Tressilloide/Serra_smart/Kimi_Agent_Smart Greenhouse ESP32 LoRa/docs/Guida_Serra_Smart.md

# Serra Smart — Guida completa

Sistema di monitoraggio e irrigazione automatica basato su due ESP32 collegati
via LoRa e un server Linux con Home Assistant.

**Firmware 2.0** — comunicazione bidirezionale, sensori modulari, controllo
completo da Home Assistant.

---

## 1. Architettura

```
┌──────────────────────────┐      LoRa 433 MHz      ┌────────────────────────┐
│       NODO SERRA         │  ───── dati ────────►  │   PONTE IN CAMERA      │
│        (ESP32)           │                        │       (ESP32)          │
│                          │  ◄── ACK + comandi ──  │                        │
│  • BME280 (I2C)          │                        │  • LoRa Ra-01          │
│  • DS1307 RTC (I2C)      │                        │  • WiFi + MQTT         │
│  • Luce (GPIO 32)        │                        │  • Coda comandi        │
│  • Tensione (GPIO 33)    │                        │  • Ora NTP             │
│  • Terreno ×2 (34, 35)   │                        │  • Discovery HA        │
│  • Flussometro (15)      │                        │  • Sempre acceso       │
│  • microSD (backlog)     │                        │                        │
│  • Relay irrigazione     │                        └───────────┬────────────┘
│  • Deep sleep 15 min     │                                    │ WiFi / MQTT
└──────────────────────────┘                                    ▼
                                                    ┌────────────────────────┐
                                                    │   SERVER IN GARAGE     │
                                                    │     192.168.1.36       │
                                                    │  • Mosquitto           │
                                                    │  • Home Assistant      │
                                                    │  • Tailscale           │
                                                    └────────────────────────┘
```

### Come fluiscono i dati

1. Ogni 15 minuti il nodo si sveglia, legge i sensori e trasmette via LoRa.
2. Il ponte pubblica il pacchetto su MQTT e **solo dopo** risponde con un ACK.
3. Se l'ACK non arriva (ponte spento, WiFi giù, server in manutenzione), il
   nodo salva il pacchetto su microSD e lo ritrasmette al prossimo risveglio.
4. Home Assistant riceve i dati e crea le entità da solo via MQTT Discovery.

### Come fluiscono i comandi (novità della 2.0)

Il nodo dorme il 99% del tempo: non può restare in ascolto. L'unico momento in
cui la sua radio è accesa in ricezione è l'attesa dell'ACK dopo la
trasmissione. **È lì che viene infilato il comando.**

```
nodo  ── dati ─────────────────────────────►  ponte ──► MQTT ──► HA
nodo  ◄── ACK;s=42;now=…;c=7;o=IRR;a=120 ───  ponte
        [esegue]
nodo  ── dati;res=7;rc=0;det=ok ───────────►  ponte ──► serra/nodo/cmd/res
```

Costo aggiuntivo: **zero**. Nessuna finestra di ascolto in più, nessun consumo
extra, nessun pacchetto aggiuntivo nel caso normale.

Home Assistant pubblica i comandi con `retain: true`, quindi **è il broker MQTT
a fare da coda**: se premi un bottone mentre la serra dorme, il comando resta
lì e sopravvive anche a un riavvio del ponte.

**Latenza:** fino a un intervallo di deep sleep (15 minuti di default). La
dashboard mostra "comando in coda" finché non arriva l'esito, così l'attesa è
visibile e non sembra un malfunzionamento.

Poiché anche il pacchetto di esito riceve un ACK, e anche quell'ACK può portare
un comando, più comandi si svuotano a catena nello stesso risveglio.

---

## 2. File del progetto

| Percorso | Contenuto |
|---|---|
| `serra_nodo/serra_nodo.ino` | Orchestrazione del ciclo di vita del nodo |
| `serra_nodo/config.h` | **Tutti i parametri e il pinout** |
| `serra_nodo/protocollo.h` | Formato dei pacchetti (copia identica nel ponte) |
| `serra_nodo/sensori.{h,cpp}` | Registro sensori modulare |
| `serra_nodo/irrigazione.{h,cpp}` | Logica e protezioni dell'irrigazione |
| `serra_nodo/backlog.{h,cpp}` | Coda su microSD |
| `serra_nodo/riserva.{h,cpp}`, `riserva_coda.h` | Riserva in RAM RTC quando la microSD manca (dalla 2.6.0) |
| `serra_nodo/impostazioni.{h,cpp}` | Persistenza in NVS |
| `serra_nodo/comandi.{h,cpp}` | Esecuzione dei comandi |
| `serra_nodo/orologio.{h,cpp}` | DS1307 e sincronizzazione |
| `serra_nodo/radio.{h,cpp}` | LoRa |
| `serra_nodo/watchdog.h` | Wrapper TWDT compatibile core 2.x e 3.x |
| `camera_ponte/camera_ponte.ino` | Ponte LoRa → WiFi → MQTT |
| `camera_ponte/secrets.h` | **Credenziali (non versionato)** |
| `camera_ponte/discovery.{h,cpp}` | Generazione entità Home Assistant |
| `camera_ponte/comandi.{h,cpp}` | Coda comandi MQTT → LoRa |
| `test_protocollo/` | Autotest del protocollo, da caricare su un ESP32 qualsiasi |
| `test_flusso/` | Test del flussometro, da caricare sulla scheda del nodo |
| `homeassistant/packages/serra.yaml` | Contatori, sensori calcolati, automazioni |
| `homeassistant/lovelace/serra_core.yaml` | Dashboard senza dipendenze |
| `homeassistant/lovelace/serra_hacs.yaml` | Dashboard con Mushroom + ApexCharts |
| `server/` | Broker MQTT Mosquitto |
| `docs/PROTOCOLLO.md` | Specifica del protocollo e dei comandi |
| `docs/PINOUT.md` | Pinout, schemi e avvertenze hardware |
| `tools/test_*.py` | Test che girano sul PC: finestra di irrigazione, record arretrati e bilancio dei byte, tempo di volo, scatola nera, riserva RTC (compila `test_riserva.cpp` con g++), radio del ponte contro un SX1278 simulato (`test_radio_ponte.py`, con g++ e i sorgenti della libreria LoRa) |
| `tools/verifica_entita.py` | Controlla che ogni entità citata da package e dashboard esista |
| `tools/salute_serra.py` | Rapporto giornaliero dal recorder di Home Assistant: cicli arrivati, buchi, segnale, batteria, acqua (vedi §9.bis) |

> L'IDE Arduino richiede che ogni sketch stia in una cartella con lo stesso
> nome del file `.ino`. Non rinominare le cartelle. Tutti i `.h` e `.cpp` nella
> cartella dello sketch vengono compilati automaticamente.

---

## 3. Preparazione dell'IDE Arduino

1. Installa il core **esp32 by Espressif** (va bene sia 2.x che 3.x: il codice
   gestisce entrambi).
2. Dal Gestore librerie installa:
   - **LoRa** by Sandeep Mistry
   - **Adafruit BME280 Library** (accetta le dipendenze, *Adafruit Unified Sensor* inclusa)
   - **RTClib** by Adafruit
   - **PubSubClient** by Nick O'Leary
   - *(solo se attivi `USA_ADS1115`)* **Adafruit ADS1X15**
3. Scheda: **ESP32 Dev Module**, monitor seriale a **115200**.

---

## 4. Configurazione del ponte

```bash
cd camera_ponte
cp secrets.h.example secrets.h
```

Apri `secrets.h` e compila WiFi, MQTT e password OTA. Il file è escluso dal
versionamento: nella versione precedente le credenziali finivano dentro git.

Carica lo sketch e apri il monitor seriale. Dovresti vedere `In ascolto
continuo`, la connessione WiFi e poi MQTT. Se il server non è ancora pronto
vedrai tentativi ogni 5 secondi: è normale, e nel frattempo la serra accumula
su SD.

**Garanzie del ponte:**

- Riconnessione WiFi e MQTT **non bloccanti**: la radio non smette mai di ascoltare.
- L'ACK parte **solo dopo** la pubblicazione MQTT riuscita.
- Last Will: se il ponte muore, Home Assistant segna subito tutto come non disponibile.
- Watchdog sul loop (30 s) e riavvio **solo** se il WiFi resta giù per 15 minuti.
- Aggiornamento via WiFi (ArduinoOTA), comodo perché il ponte spesso sta dietro un mobile.

> **Cambiato rispetto alla 1.0:** il ponte non si riavvia più ogni ora. Durante
> i secondi di riavvio la radio non ascolta e, con il nodo che trasmette ogni
> 15 minuti, c'era una probabilità concreta di perdere proprio quel pacchetto.

---

## 5. Configurazione del nodo

Tutto sta in `serra_nodo/config.h`. I valori più importanti:

```c
#define SLEEP_TIME_SEC   900     // risveglio ogni 15 minuti
#define IRRIG_ORA_DEF    17      // irrigazione alle 17:00
#define IRRIG_SEC_DEF    300     // per 5 minuti
#define LORA_BAND        433E6   // deve coincidere con il ponte

#define USA_SOIL         1       // sensori terreno collegati?
#define N_SOIL           2
#define USA_FLUSSO       1       // flussometro collegato?
```

Metti a `0` i sensori che non hai ancora collegato: il codice si adatta, il
pacchetto si accorcia e Home Assistant non mostra entità fantasma.

> **Nota importante:** i valori di irrigazione qui sono solo il **default di
> primo avvio**. Una volta scritti in NVS diventano modificabili da Home
> Assistant, e da quel momento il valore in NVS ha la precedenza su quello
> compilato. Per tornare ai default usa il comando `RESETCFG`.

### 5.1 Le protezioni dell'irrigazione

Sette livelli, dal più esterno al più interno:

1. **`relayOffImmediato()` è la primissima istruzione del `setup()`.** Dopo
   qualunque reset — watchdog, brownout, panic — la valvola si chiude entro
   pochi millisecondi dall'avvio.
2. **`gpio_hold_en()` durante il deep sleep.** GPIO 25 è nel dominio RTC e
   mantiene *attivamente* il livello OFF per tutte le ore di sonno, invece di
   restare flottante.
3. **Il contatore in NVS viene aggiornato PRIMA di aprire la valvola.** Se il
   nodo muore a valvola aperta, al riavvio sa di aver già irrigato e non
   riprova. Meglio un giorno senza acqua che una serra allagata.
4. **Watchdog hardware** armato per la durata + 60 s di margine.
5. **Timeout software** con `millis()` nel ciclo di attesa.
6. **Limiti compilati** che nessun comando può superare: durata massima 900 s,
   intervallo minimo 30 minuti, massimo 4 irrigazioni al giorno, budget 50 L.
7. **Con il flussometro:** chiusura immediata al raggiungimento del budget
   giornaliero, anche a metà irrigazione.

> **Cambiato rispetto alla 1.0:** il marker anti-doppione stava solo sulla
> microSD, quindi **senza SD l'irrigazione non partiva mai**. Ora è in NVS, che
> sopravvive a deep sleep e blackout ed è indipendente dalla scheda.

### 5.2 Irrigazione condizionata al terreno

Imposta la soglia da Home Assistant (`number.serra_soglia_umidita_terreno`) o
con `SOIL,<percentuale>`. Il nodo irriga solo se il sensore **più secco** è
sotto soglia.

Si usa il minimo e non la media di proposito: se anche una sola zona è
asciutta conviene bagnare, mentre una media alta potrebbe nascondere una zona
completamente secca.

`-1` disattiva la condizione: si torna al solo criterio orario.

### 5.3 Irrigazione volumetrica

Con il flussometro puoi chiedere litri invece di minuti:

```bash
mosquitto_pub -t "serra/nodo/cmd/IRRVOL" -m "5,600" -r
```

5 litri, con un tetto di 600 secondi. Se l'acqua non arriva, il nodo chiude
comunque e segnala `nessun_flusso`.

### 5.4 Calibrazioni

| Cosa | Come |
|---|---|
| **Tensione** | Misura la batteria col multimetro (`V_reale`), leggi il valore in HA (`V_letta`), calcola `nuovo = attuale × V_reale / V_letta`, invia `CAL,volt,<nuovo>` |
| **Terreno** | Leggi il grezzo con il sensore in aria e in un bicchiere d'acqua, poi `CAL,soil1,<aria>,<acqua>` |
| **Flussometro** | Riempi un contenitore da 1 litro, conta gli impulsi, `CAL,acqua,<impulsi>` |

Nessuna di queste richiede di ricompilare: i valori vivono in NVS.

### 5.5 Orologio

Se il DS1307 ha perso l'ora (CR2032 scarica), il nodo **lo dichiara e non
irriga**, poi si risincronizza da solo: il ponte allega l'ora NTP a ogni ACK e
il DS1307 si corregge al primo contatto.

Lo stesso meccanismo tiene a bada la deriva: il DS1307 di questo nodo va
avanti di circa 5 s al giorno, e dalla 2.6.0 il nodo si riallinea quando lo
scarto supera `RTC_DRIFT_MAX_SEC`, 5 s (prima 30, cioè una correzione ogni
sei giorni e l'irrigazione fino a mezzo minuto in anticipo).

> **Cambiato rispetto alla 1.0:** prima, con l'orologio perso, veniva impostata
> l'*ora di compilazione*. Il risultato era un orologio che sembrava
> funzionante ma segnava un momento arbitrario nel passato: timestamp falsi in
> Home Assistant e finestra di irrigazione imprevedibile.

---

## 6. Server

### 6.1 Broker MQTT

Copia la cartella `server/` sul server, poi:

```bash
cd server
docker compose up -d
```

Oppure, da CasaOS: App Store → Custom Install → importa `docker-compose.yml`.

### 6.2 Utente e password MQTT

```bash
docker run --rm -it -v "$PWD/mosquitto/config:/mosquitto/config" \
  eclipse-mosquitto:2 \
  mosquitto_passwd -c /mosquitto/config/password.txt utente_serra
docker compose restart
```

Metti la stessa password in `secrets.h` del ponte.

### 6.3 Integrazione MQTT in Home Assistant

Impostazioni → Dispositivi e servizi → Aggiungi integrazione → **MQTT**
Broker `192.168.1.36`, porta `1883`, utente e password creati sopra.

La discovery è attiva di default: appena il ponte si collega compare il
dispositivo **Serra** con sensori **e comandi**.

### 6.4 Package e dashboard

> **Prima di tutto: questa sezione è FACOLTATIVA.**
> Dopo il punto 6.3 il sistema già funziona: sensori e comandi compaiono da
> soli in Home Assistant grazie alla MQTT Discovery del ponte, senza scrivere
> un solo file YAML. Quello che segue aggiunge le cose che la discovery *non
> può* fare, ed è diviso in due parti indipendenti che puoi fare in qualsiasi
> ordine, o non fare affatto.

|  | Cosa aggiunge | Serve? |
|---|---|---|
| **A. Package** | Contatori acqua giornaliero/mensile, VPD, ultimo contatto, automazioni di allarme | No, ma è la parte più utile |
| **B. Dashboard** | La disposizione grafica delle schede | No: senza, HA genera da solo una vista del dispositivo "Serra" |

---

#### Dove sta la cartella di configurazione

Entrambe le parti richiedono di mettere dei file dentro la cartella di
configurazione di Home Assistant, quella dove sta `configuration.yaml`.
Il percorso dipende da come hai installato HA:

| Installazione | Percorso |
|---|---|
| **Docker / CasaOS** (il tuo caso) | La cartella che hai montato su `/config` nel container. La trovi con `docker inspect <nome_container> \| grep -A3 '"/config"'` |
| Home Assistant OS / Supervised | `/config` (visibile dagli add-on) |
| Core in venv | `~/.homeassistant` |

**Come modificarne i file.** Se non hai già un modo comodo:

- **Docker/CasaOS**: la cartella è sul filesystem del server, quindi ci arrivi
  via SSH, oppure con l'editor di file di CasaOS, oppure via Samba se l'hai
  configurato. È la strada più diretta nel tuo caso.
- **HA OS**: Impostazioni → Add-on → installa **File editor** oppure
  **Studio Code Server**, che ti danno un editor dentro l'interfaccia di HA.

---

#### A. Installare il package

Un "package" è semplicemente un file YAML che raggruppa più tipi di
configurazione insieme (sensori, contatori, automazioni) invece di doverli
spargere in sezioni diverse di `configuration.yaml`. È il modo pulito di
aggiungere un blocco di roba che riguarda un solo progetto.

**Passo 1** — abilita i package. Apri `configuration.yaml` e controlla se c'è
già una riga `homeassistant:` all'inizio.

Se **non** c'è, aggiungi in cima al file:

```yaml
homeassistant:
  packages: !include_dir_named packages
```

Se **c'è già**, aggiungi solo la riga `packages:` sotto, rispettando
l'indentazione di due spazi:

```yaml
homeassistant:
  name: Casa              # <- roba tua che c'era già
  latitude: 45.0
  packages: !include_dir_named packages    # <- aggiungi questa
```

**Passo 2** — crea la cartella `packages` **dentro** la cartella di
configurazione, accanto a `configuration.yaml`:

```
<config>/
  configuration.yaml
  packages/          <- da creare, se non esiste
```

**Passo 3** — copia dentro il file:

```
homeassistant/packages/serra.yaml   →   <config>/packages/serra.yaml
```

**Passo 4** — verifica e ricarica. In Home Assistant:
Strumenti per sviluppatori → scheda **YAML** → premi prima
**"Controlla configurazione"**, e solo se dice che è valida premi
**"Ricarica tutto"**. Se segnala un errore, la configurazione vecchia resta
attiva: non hai rotto nulla.

> Se "Controlla configurazione" non compare, ti manca `default_config:` in
> `configuration.yaml`. In alternativa riavvia Home Assistant.

**Passo 5** — verifica che sia andata: Strumenti per sviluppatori → **Stati**,
scrivi `serra_vpd` nel filtro. Se compare `sensor.serra_vpd`, il package è
attivo.

> **Se qualche sensore risulta `unavailable`** è quasi sempre un entity_id che
> non coincide. Home Assistant li genera da "nome dispositivo + nome entità",
> ma se in passato esistevano entità con lo stesso nome li numera
> (`sensor.serra_temperatura_2`). Filtra per `serra` in Stati, guarda i nomi
> veri e correggili dentro `serra.yaml`.

---

#### B. Installare la dashboard

**Passo 1** — scegli quale delle due:

- `serra_core.yaml` — solo schede incluse in Home Assistant. Nessuna
  installazione, nessuna manutenzione. **Parti da questa.**
- `serra_hacs.yaml` — più curata graficamente. Richiede che tu installi prima
  da **HACS → Frontend** le schede **Mushroom** e **apexcharts-card**, e poi
  ricarichi la pagina con CTRL+F5. Se le incolli senza averle installate vedi
  dei riquadri rossi "Custom element doesn't exist".

**Passo 2** — crea una dashboard vuota:
Impostazioni → Dashboard → **+ Aggiungi dashboard** → **Nuova dashboard da
zero** → chiamala "Serra".

**Passo 3** — aprila, poi in alto a destra la matita (**Modifica dashboard**).

**Passo 4** — sempre in alto a destra, i tre puntini ⋮ → **Editor di
configurazione raw**.

**Passo 5** — cancella tutto quello che c'è nell'editor, incolla il contenuto
del file scelto, **Salva**.

> A differenza del package, la dashboard non richiede di copiare file sul
> server: copi e incolli il testo dentro l'interfaccia di Home Assistant.
> Questi due file stanno nel repository solo per comodità tua.

### 6.5 Verifica del traffico

```bash
docker exec -it mosquitto mosquitto_sub -u utente_serra -P <password> -t "serra/#" -v
```

---

## 7. Aggiungere un sensore

Il punto centrale della versione 2.0: **aggiungere un sensore è una modifica al
solo firmware del nodo.**

1. In `sensori.cpp` scrivi la funzione di lettura (ritorna `NAN` se il sensore
   non risponde) e aggiungi **una riga** a `SENSORI[]`.
2. Aggiungi il bit corrispondente all'enum `BitSensore` in `sensori.h`.
3. Riflasha il nodo.

Il sensore compare in Home Assistant al primo pacchetto, con nome uguale alla
chiave, perché il ponte crea un'entità generica per ogni chiave che non
conosce. Quando vuoi nome leggibile, unità e icona, aggiungi una riga alla
tabella `ENTITA[]` in `camera_ponte/discovery.cpp` e riflasha il ponte — ma nel
frattempo il dato è già al sicuro e storicizzato.

Per un sensore analogico non serve nemmeno una funzione nuova: riusa
`leggiPercentuale()` con un `CtxAnalogico`, come fanno i sensori terreno.

Dettagli in [PROTOCOLLO.md §8](PROTOCOLLO.md#8-aggiungere-un-sensore--la-procedura-completa).

---

## 8. Collaudo prima del montaggio

Da fare sul banco, con il relay che pilota una lampadina o solo il LED del modulo.

| # | Prova | Come |
|---|---|---|
| 1 | **Irrigazione** | Metti `IRRIG_SEC_DEF 10` e `IRRIG_ORA_DEF` all'ora corrente. Verifica: relay ON → 10 s → OFF; secondo risveglio nella stessa ora che **non** riapre |
| 2 | **Sicurezza al reset** | Premi EN a valvola aperta: al boot il relay dev'essere OFF entro pochi ms e non deve riprovare |
| 3 | **Limite di durata** | `mosquitto_pub -t serra/nodo/cmd/IRR -m "99999" -r` → il seriale deve dire "clampata al tetto di 900 s" |
| 4 | **Comandi** | Premi "Irriga ora" in HA, guarda il seriale del ponte (consegna nell'ACK) e `serra/nodo/cmd/res` |
| 5 | **Backlog** | Spegni il ponte, metti `SLEEP_TIME_SEC 60`, accumula oltre 120 pacchetti, riaccendi il ponte: devono arrivare **tutti** |
| 6 | **Flussometro** | Fai girare la turbina a mano e conta gli impulsi; calibra con 1 litro |
| 7 | **Terreno** | Calibra in aria e in acqua con `CAL` |
| 8 | **Orologio** | Sballa l'ora del DS1307 e verifica che venga corretta dal campo `now` dell'ACK |
| 9 | **Protocollo** | Carica `test_protocollo/` su un ESP32 qualsiasi (anche senza nulla collegato) e leggi il monitor seriale: devono passare tutte le verifiche |

La prova 5 **fallisce sul firmware 1.0**: è la riproduzione del bug descritto
al punto successivo.

---

## 9. Cosa è cambiato dalla versione 1.0

### Bug corretti

| Problema | Conseguenza | Correzione |
|---|---|---|
| **Perdita di dati nel backlog** | `leggiBacklog()` leggeva max 100 record, `riscriviBacklog()` cancellava l'**intero file** e riscriveva solo quelli. Tutto oltre il centesimo spariva: con 96 pacchetti al giorno bastava un giorno di ponte offline | La coda non consegnata viene copiata **dal file**, mai ricostruita dalla RAM |
| **Il backlog sporcava lo stato corrente** | Fresco e storico finivano sullo stesso topic; HA mostrava come "adesso" una lettura di ore prima | Topic `serra/nodo/storico` separato |
| **Riavvio orario del ponte** | Durante il riavvio la radio non ascoltava: pacchetti persi senza motivo | Watchdog + riavvio solo se il WiFi resta giù 15 minuti |
| **Senza microSD niente irrigazione** | Il marker anti-doppione stava solo su SD | Marker in NVS |
| **Watchdog solo durante l'irrigazione** | Un blocco su SD, LoRa o I2C lasciava il nodo appeso fino a scaricare la batteria | Watchdog globale su tutto il `setup()` |
| **Nessun anti-duplicati** | Un ACK perso causava doppioni nello storico e nel conteggio dell'acqua | Memoria delle ultime 16 coppie (seq, timestamp) |
| **Watchdog mai riconfigurato su core 3.x** | `esp_task_wdt_init()` falliva in silenzio e il timeout restava 5 s | Fallback su `esp_task_wdt_reconfigure()` |
| **Ora di compilazione come ripiego** | Orologio apparentemente valido ma sbagliato | Il nodo dichiara l'ora non attendibile e aspetta il ponte |
| **Stato MQTT non retained** | Dopo un riavvio di HA i sensori restavano vuoti fino a 15 minuti | `retain: true` sullo stato |
| **Credenziali nel repository** | Password MQTT dentro git | `secrets.h` in `.gitignore` |
| **Buffer del pacchetto da 128 byte** | Troncamento silenzioso appena si aggiungevano sensori | Tetto a 250 byte con flag `trunc` esplicito |
| **Trasmissione LoRa senza timeout** | `LoRa.endPacket()` aspetta il flag di TxDone con un ciclo senza uscita e senza nutrire il watchdog. Se l'SX1278 si impunta il nodo resta appeso dentro `setup()`, perde l'intero ciclo di misure e si riavvia dopo 180 s con `rst=6` | Trasmissione asincrona, fine rilevata interrogando `beginPacket()`, limite di guardia pari a tre volte il tempo di volo calcolato, e reset hardware della radio fra un tentativo e il successivo |
| **Contatori di sequenza azzerati a ogni riavvio** | `g_seq` stava in `RTC_DATA_ATTR`, che il bootloader riazzera a ogni avvio diverso dal risveglio dal deep sleep. Un riavvio il cui pacchetto non arrivava al ponte diventava cosi' invisibile | Spostati in `RTC_NOINIT_ATTR`, azzerati solo quando manca la corrente: ora un buco nella numerazione e' la prova di un ciclo perso |
| **Il ponte cacciato dal broker ~25 volte al giorno** | Nel log di Mosquitto: `serra-ponte disconnected: exceeded timeout`. Il WiFi non cadeva mai e il loop non poteva bloccarsi (il watchdog e' a 30 s, il broker tollera 45 s), quindi i pacchetti partivano ma non arrivavano. Nella 2.3.0 si era attribuita la colpa all'algoritmo di Nagle, che trattiene il PINGREQ da due byte | `espClient.setNoDelay(true)` dopo ogni connessione (ponte 2.3.0). **Non e' bastato**: le cadute sono rimaste 14-22 al giorno, vedi la riga seguente |
| **Dati confermati al nodo e mai arrivati** (ponte 2.4.0, nodo 2.5.0) | Le cadute sono stalli del WiFi: quasi nessuna di notte, un picco fra le 6 e le 7 e poi tutto il giorno, cioe' il profilo di un disturbo legato alla vita di casa. Le ritrasmissioni TCP, sempre piu' distanziate, fanno di pochi secondi di disturbo un silenzio di 45 s. Il ponte mandava l'ACK appena `publish()` accettava i byte, quindi ogni pacchetto del nodo che cadeva dentro uno stallo andava perso senza passare dal backlog: 12 dei 15 cicli persi dal 13/09. Inoltre un record del backlog vecchio di 15 minuti passava per fresco e sovrascriveva lo stato in HA | **Eco di conferma**: l'ACK parte solo quando il broker rimanda indietro un gettone pubblicato dopo i dati. Keepalive da 30 a 60 s, ora che non rischia piu' dati. Record del backlog marcati `bk=1` e pubblicati sempre come storici. Gli eventi (esito dell'irrigazione, diagnostica di un riavvio) si ripetono finche' non arrivano |
| **Trasmissione dell'ACK senza timeout sul ponte** | Stesso `LoRa.endPacket()` bloccante del nodo. Non si era ancora manifestato, ma il ponte e' l'unico che ascolta: mentre e' appeso non riceve da nessuno, e l'unica via d'uscita era il riavvio dopo 30 s | Guardia pari a tre volte il tempo di volo calcolato, come sul nodo |

### Funzionalità nuove

- Comandi da Home Assistant, consegnati sull'ACK
- Protocollo `chiave=valore`, con compatibilità in lettura per il v1
- Registro sensori modulare e discovery generica
- Sensori umidità terreno con calibrazione e alimentazione commutata
- Flussometro, irrigazione volumetrica, budget litri, allarme "nessun flusso"
- Irrigazione condizionata all'umidità del terreno
- Impostazioni persistenti in NVS, modificabili da remoto
- Sincronizzazione automatica dell'orologio
- Diagnostica del ponte e aggiornamento OTA
- Package Home Assistant e due dashboard

---

## 9.bis Come si legge la qualita' del collegamento

Due numeri dicono quasi tutto, e vale la pena imparare a leggerli perche'
distinguono un guasto da un semplice calo di segnale.

**RSSI LoRa** (`sensor.serra_segnale_lora`), quanto arriva forte il segnale:

| Valore | Significato |
|---|---|
| da −30 a −70 dBm | ottimo, tipico di nodo e ponte nella stessa stanza |
| da −70 a −100 dBm | normale a distanza, funziona |
| da −100 a −115 dBm | margine ridotto: i pacchetti iniziano a perdersi |
| sotto −115 dBm | al limite della sensibilita', link inaffidabile |

**SNR LoRa** (`sensor.serra_snr_lora`), quanto il segnale emerge dal rumore:
sopra 0 dB e' buono, fino a −7,5 dB il LoRa a SF7 riesce ancora a decodificare,
sotto e' perso.

> **Caso reale, utile da ricordare.** Durante le prove da banco il nodo
> arrivava a −37 dBm. In serra, con il connettore dell'antenna del ponte
> mal serrato, il valore e' sceso a **−97 dBm con SNR −1,5 dB**: sessanta
> decibel persi, cioe' un milione di volte meno potenza. Il collegamento
> funzionava ancora, ma con margine quasi nullo, ed e' rimasto muto per otto
> ore di fila. Se vedi l'RSSI peggiorare di colpo di decine di dB, il primo
> sospettato e' sempre un connettore d'antenna, non il software.

**Memoria del ponte.** Il ponte resta acceso per settimane, quindi vale la
pena sapere leggere tre numeri invece di uno:

| Entita' | Cosa dice |
|---|---|
| `sensor.serra_ponte_memoria_libera` | memoria libera adesso |
| `sensor.serra_ponte_blocco_memoria` | il piu' grande blocco **contiguo** allocabile |
| `sensor.serra_ponte_memoria_minima` | il minimo storico di memoria libera |

Il numero che conta e' il secondo. La memoria si **frammenta**: allocazioni e
rilasci di dimensioni sempre diverse lasciano buchi, e col tempo il totale
libero puo' restare identico mentre il piu' grande blocco contiguo si
rimpicciolisce, finche' un'allocazione fallisce e il ponte si riavvia.
Guardando solo la memoria libera non si vede arrivare niente.

Regola pratica: se dopo giorni `blocco_memoria` cala costantemente mentre
`memoria_libera` resta piatta, c'e' frammentazione. Se restano entrambi
stabili, non ce n'e'.

**RSSI WiFi del ponte** (`sensor.serra_ponte_segnale_wifi`): sopra −70 dBm
bene, fra −70 e −80 accettabile, sotto −80 la connessione inizia a cadere.
Se `sensor.serra_riconnessioni_mqtt` continua a salire, e' quasi sempre questo.

**Il conto dei cicli.** Tutti i numeri sopra sono sintomi; quello che conta
e' quanti cicli arrivano. In Home Assistant lo dice
`sensor.serra_cicli_ricevuti_24h` (package, dal 10/11/2026), giorno per giorno
lo dice `tools/salute_serra.py`, da lanciare sul server:

```
docker exec -i homeassistant python3 - --giorni 10 < tools/salute_serra.py
```

Esempio reale, 4-5/11/2026: RSSI medio −113 dBm con punte a −121, SNR medio
4,1 dB, e il 24% dei cicli arrivato in un giorno, il 61% nell'altro. Con la
microSD guasta quei pacchetti si sono persi; dal nodo 2.6.0 aspettano nella
riserva in RAM RTC, fino a circa 11 ore.

---

## 10. Risoluzione problemi

| Sintomo | Cosa controllare |
|---|---|
| `[LoRa] ERRORE: modulo non trovato` | Cablaggio SPI, NSS su GPIO 5, alimentazione 3,3 V, **antenna montata**. Dal firmware 2.5.0 il ponte non si riavvia più a ripetizione: resta su WiFi e MQTT (quindi anche raggiungibile via OTA), riprova da solo ogni 30 s e nella diagnostica mostra `radio_ok` a 0 |
| Il ponte smette di ricevere, e torna a funzionare solo riflashandolo | Era la radio del ponte che restava configurata male mentre tutto il resto funzionava (9-20/10/2026, tre episodi da 11 a 53 ore). Dal firmware 2.5.0 il ponte se ne accorge da solo e si resetta la radio: guarda **`sensor.serra_riparazioni_radio`**, e il motivo dell'ultima riparazione in **`sensor.serra_ultima_riparazione_radio`** (`registri`, `tx_bloccata`, `silenzio`, `ack_persi`; negli attributi il dettaglio, per esempio il registro trovato alterato), che legge il messaggio ritenuto su `serra/ponte/log`. Se le riparazioni diventano frequenti, il problema è hardware: vedi le due righe seguenti |
| `binary_sensor.serra_radio_del_ponte` su **Problema**, avviso "la radio del ponte non funziona" | Il ponte è acceso e collegato ma il suo modulo LoRa non ascolta; il motivo è nell'attributo `motivo` (il campo `radio_avv` di `serra/ponte/diag`). **`la radio resta in sleep (modo 0x80)`**: il modulo tiene la configurazione ma non entra in ricezione, come l'11/11/2026; i sospettati sono l'alimentazione del modulo (3,3 V e massa: fili, saldature) e il modulo stesso. **`il modulo non risponde (versione 0x00 o 0xFF)`**: il bus SPI non arriva al modulo, o il modulo è senza corrente (MISO GPIO 19, NSS 5, SCK 18, MOSI 23). **`reg 0x.. = ..., atteso ...`**: un registro che non torna a reset appena fatto; se sono più di tre è lo stesso guasto. Non è l'antenna: un'antenna difettosa dà segnale basso e CRC errati, non registri sbagliati. Dal ponte 2.6.1 la radio riprova a partire da sola ogni 30 s (`radio_falliti` conta i tentativi), quindi basta sistemare il contatto; con la 2.6.0 dopo l'intervento va tolta e ridata corrente |
| `sensor.serra_letture_spi_incoerenti` che cresce | Letture dei registri della radio smentite dalla rilettura subito dopo: disturbi sui fili fra ESP32 e modulo LoRa del ponte. Fili SPI più corti, massa in comune ben fatta, niente breadboard, condensatore da 10-100 µF vicino all'alimentazione del modulo |
| `rst_hw` a **0** nella diagnostica del ponte | Il reset hardware della radio non ha effetto: dopo un riavvio software il modulo conserva lo stato di prima. Controlla il filo fra **RST** del modulo e **GPIO 14** |
| `sensor.serra_ack_persi` che cresce di due o tre a ogni ciclo | Il nodo non sente gli ACK del ponte e ritrasmette pacchetti già confermati (si vede anche da `sensor.serra_tentativi_trasmissione` a 4). Dopo tre cicli così il ponte resetta la propria radio; se continua, controlla l'antenna e il connettore del ponte |
| Entita' che lampeggiano fra "non disponibile" e il valore, a un secondo di distanza | Il ponte sta perdendo e riprendendo la connessione MQTT: a ogni riconnessione il broker pubblica il Last Will della sessione morta. Guarda `sensor.serra_riconnessioni_mqtt`: se cresce, la connessione e' instabile. Controlla `sensor.serra_ponte_segnale_wifi` (sotto i -75 dBm e' debole) e assicurati di avere il firmware con `WiFi.setSleep(false)`. Se invece e' `sensor.serra_ponte_uptime` ad azzerarsi, il ponte si sta proprio riavviando |
| Flussometro sempre a zero | Il pin e' inservibile? Sulle schede a **38 pin** (WROVER) i GPIO 16 e 17 sono occupati dalla PSRAM. Carica `test_flusso/` sulla scheda del nodo: separa hardware e firmware in un colpo |
| Il nodo a volte non parte | GPIO 12 alto al boot: manca il pulldown da 10k. Vedi [PINOUT.md §2.4](PINOUT.md) |
| Nessun ACK | Stessi `LORA_BAND`, SF, BW e CR sui due sketch? Ponte acceso e in ascolto? |
| `[SD] ERRORE: scheda non trovata` | FAT32, CS su GPIO 4, modulo a 3,3 V |
| Sensori a −127 | Il sensore non risponde. BME280: indirizzo 0x76 o 0x77 (li prova entrambi) |
| Irrigazione mai eseguita | Guarda `sensor.serra_esito_irrigazione`: ti dice **il motivo** |
| `ora_non_attendibile` | CR2032 del DS1307 scarica. Si corregge da sola al primo contatto col ponte |
| `sensor.serra_motivo_ultimo_riavvio` a **6** | Watchdog: il ciclo di veglia si e' bloccato per oltre `WDT_SETUP_SEC` (60 s dal firmware 2.4.0, prima 180). Nello storico si riconosce da un buco di circa 900 + 61 s fra due pacchetti del nodo, con `sensor.serra_ora_del_nodo` che salta in avanti. Attenzione a non contare le ripubblicazioni MQTT del ponte: valgono come riavvii solo le righe in cui l'ora dichiarata dal nodo e' nuova |
| Il nodo si riavvia e non si sa perche' | Guarda **`sensor.serra_tappa_ultimo_blocco`** (il campo `tp`): dice in che tappa del ciclo si era fermato l'ultima volta (`tx_stato` = trasmissione LoRa, `sd`/`sd_accoda`/`backlog` = microSD, `orologio`/`sensori` = bus I2C, `irrigazione` = valvola aperta). Compare dopo un riavvio anomalo, insieme a `fw` e `rst`, e si ripete finche' un pacchetto che lo contiene non arriva. Col ponte fino alla 2.3.0 l'entita' era numerica e restava sempre vuota: il testo si leggeva solo nel messaggio MQTT |
| `sensor.serra_tentativi_trasmissione` sopra 1 | Il pacchetto principale del ciclo precedente ha avuto bisogno di ritrasmissioni: 2 o 3 tentativi, 4 se non e' passato ed e' finito nel backlog. Da tenere d'occhio soprattutto nel pacchetto che segue l'irrigazione: il 22/09 e' passato al terzo e ultimo tentativo |
| `sensor.serra_conferme_mqtt_mancate` che cresce | Pacchetti del nodo rimasti senza ACK perche' il broker non ha rimandato l'eco in tempo: il WiFi del ponte era in stallo. Non e' una perdita: il nodo li ritrasmette o li tiene sulla microSD, mentre la 2.3.0 li confermava al buio. Se cresce di molte unita' al giorno, conviene avvicinare il ponte all'access point |
| `sensor.serra_record_in_backlog` a **-1** | La microSD del nodo e' assente o guasta: i pacchetti non consegnati non hanno dove andare e si perdono. In HA lo stato generale dice "MicroSD guasta" |
| Entita' che lampeggiano, e si vuole sapere di chi e' la colpa | Nella diagnostica del ponte c'e' **`mqtt_caduta`**, cioe' `mqtt.state()` letto nell'istante della caduta: **-4** vuol dire che e' stato il ponte a chiudere perche' il suo ping non ha avuto risposta, **-3** che se l'e' vista chiudere sotto dal broker. **`rssi_caduta`** dice com'era il segnale WiFi in quel momento: se e' molto peggiore di `wifi_rssi`, il problema e' la copertura e non il software |
| `terreno_umido` | Sta funzionando: il terreno è sopra soglia. Abbassa la soglia o mettila a −1 |
| `nessun_flusso` | Serbatoio vuoto, pompa guasta, filtro otturato o flussometro scollegato. Dal nodo 2.6.0 scatta anche con meno di `FLUSSO_MIN_IMPULSI` (10) impulsi, non solo con zero: il 4/11/2026 un impulso spurio aveva fatto passare per "ok" un'irrigazione da 0,002 L. Se compare a ogni irrigazione ma l'acqua c'è, alza `FLUSSO_GRAZIA_SEC`: il tuo tubo impiega più di 5 s a riempirsi |
| Comando premuto ma non succede nulla | Normale: viene eseguito al prossimo risveglio. Controlla `sensor.serra_comandi_in_coda` |
| Comando rifiutato con `rc=3` | Bloccato da un limite di sicurezza. Il motivo è nel campo `det` |
| Entità mancanti in HA | Riavvia il ponte: ripubblica tutta la discovery a ogni riconnessione MQTT |
| `rc=5` / `rc=4` in MQTT | Password errata (5) o broker irraggiungibile (4) |
| Riavvii con motivo 9 (brownout) | L'alimentazione non regge i picchi della radio |
| Luce al 90% di notte | Modulo con logica invertita: metti `LUCE_INVERTITA 1` |

---

## 11. Prossimi passi possibili

- **Sensori UV e irraggiamento** — il framework è pronto, serve solo la
  funzione di lettura. Vedi [PINOUT.md §4.2](PINOUT.md)
- **ADS1115** per più canali analogici, già supportato da un `#define`
- **Autenticazione dei comandi** — il campo `h` è previsto dal protocollo
- **MOSFET generale** per togliere corrente a tutte le periferiche nel sonno
- **Ingest su InfluxDB** dal topic `serra/nodo/storico`, per recuperare
  davvero la cronologia dei dati arretrati con il loro timestamp originale.
  Home Assistant non sa scrivere stati nel passato: oggi i record arretrati
  contano solo in *Cicli ricevuti 24h* e in *Record arretrati recuperati*
- **Spreading factor più alto** (SF9: circa +5 dB di margine, pacchetti tre
  volte più lunghi in aria) se antenne e connettori non bastano a riportare
  il segnale sopra i −100 dBm. Va cambiato insieme su nodo e ponte, quindi
  conviene farlo con un meccanismo di ripiego (il nodo che riprova all'SF
  vecchio se al nuovo non risponde nessuno), non con due flash a mano
