Tressilloide/Serra_smart/Kimi_Agent_Smart Greenhouse ESP32 LoRa/docs/PROTOCOLLO.md

# Protocollo LoRa v2 — Serra Smart

Specifica del dialogo tra il **nodo serra** e il **ponte in camera**.
Il file di riferimento è [`protocollo.h`](../serra_nodo/protocollo.h), che deve
essere **identico** in `serra_nodo/`, `camera_ponte/` e `test_protocollo/`.

---

## 1. Perché non più il CSV posizionale

Il protocollo v1 era:

```
GH1,42,1755500400,24.10,61.30,1012.50,78.4,12.35,0
```

Il significato di ogni campo dipendeva dalla sua **posizione**. Aggiungere un
sensore significava modificare il nodo *e* il ponte insieme e riflasharli in
modo coordinato: finché non erano allineati, i dati venivano interpretati male
senza che nulla segnalasse l'errore.

Il v2 usa coppie `chiave=valore`:

```
GH1;v=2;s=42;t=1755500400;temp=24.10;hum=61.3;soil1=42.5;acqua=3.210;bl=0
```

Il ponte non ha più bisogno di sapere quali sensori esistono: copia ogni coppia
nel JSON MQTT così com'è, e Home Assistant crea l'entità da solo anche per una
chiave mai vista prima. **Aggiungere un sensore alla serra è diventata una
modifica al solo firmware del nodo.**

Il costo è di pochi byte per pacchetto, del tutto irrilevante: a SF7/BW125 un
pacchetto pieno occupa la radio circa 400 ms, quattro volte l'ora.

Dimensioni reali: **217 byte** nella configurazione attuale (2 sensori terreno
+ flussometro), **239 byte** con 4 sensori terreno. Il margine c'è ma è tutto
usato: aggiungendo altri sensori valuta se disabilitarne qualcuno con `SENS`,
oppure alza `PROTO_MAX_PAYLOAD` fino a 255.

---

## 2. Formato dei messaggi

Separatore di campo: `;` — separatore di argomenti dentro un campo: `,`
Tetto operativo: **250 byte** (`PROTO_MAX_PAYLOAD`); il limite fisico LoRa è 255.

### 2.1 Dati — nodo → ponte

```
GH1;v=2;s=<seq>;t=<epoch>;<chiave>=<valore>;...
```

| Campo | Significato |
|---|---|
| `GH1` | Prefisso: identificativo del nodo (`NODE_ID`) |
| `v` | Versione del protocollo |
| `s` | Numero di sequenza, cresce a ogni pacchetto |
| `t` | Timestamp Unix del dato. **`0` = il nodo non conosce l'ora** |
| altre | Letture dei sensori e stato, vedi §3 |

Un pacchetto rimasto senza ACK finisce nel backlog su microSD, e quando viene
ritrasmesso porta in testa il marcatore `bk=1` (dal firmware del nodo 2.5.0):

```
GH1;bk=1;v=2;s=<seq>;t=<epoch>;<chiave>=<valore>;...
```

Dal firmware 2.6.0, se la microSD manca o rifiuta la scrittura, la stessa
riga aspetta nella **riserva in RAM RTC** del nodo (`serra_nodo/riserva.h`),
senza i campi di configurazione `sAuto`, `sOra`, `sMin`, `sDur`, `sSoil`,
`slp`, che nello storico non servono a nessuno: circa 140 byte a riga, 43
righe in 6 KB. Per il ponte non cambia niente, è un record con `bk=1` come
gli altri.

È così che il ponte lo pubblica su `serra/nodo/storico` e mai sullo stato
attuale. Prima il ponte lo capiva solo dall'età del record, oltre 40 minuti:
un record accodato nel ciclo precedente, vecchio di 15, passava per fresco e
sovrascriveva in Home Assistant il pacchetto vero arrivato un attimo prima. Nel
recorder è successo nove volte fra il 12 e il 14/09.

Per i record dei nodi fino alla 2.4.0, che il marcatore non lo mettono, il
ponte (dalla 2.4.0) usa anche un'altra regola: il nodo trasmette sempre prima
il pacchetto fresco e poi la coda, quindi un record con timestamp più vecchio di
oltre 60 s rispetto all'ultimo pacchetto fresco confermato è per forza
arretrato. Il riferimento si aggiorna solo con timestamp entro 5 minuti dall'ora
NTP del ponte, così una lettura impazzita del DS1307 non lo sporca.

### 2.2 ACK — ponte → nodo

```
ACK;s=<seq>;now=<epoch>;tz=<offset>
ACK;s=<seq>;now=<epoch>;tz=<offset>;c=<cmdId>;o=<OPCODE>;a=<arg1>,<arg2>
```

| Campo | Significato |
|---|---|
| `s` | Sequenza confermata: deve coincidere o l'ACK viene ignorato |
| `now` | Ora NTP del ponte, **UTC**. Il nodo ci risincronizza il DS1307 |
| `tz` | Secondi da sommare a `now` per l'ora civile (+7200 con l'ora legale) |
| `c` | Id del comando accodato |
| `o` | Opcode |
| `a` | Argomenti, separati da virgola |

**Perché `tz` è un campo a parte e non è già dentro `now`.** Tutti i timestamp
del sistema sono UTC e devono restarci: `t` finisce nei grafici di Home
Assistant, e due istanti si confrontano solo se hanno la stessa origine.
L'orario di irrigazione però lo sceglie una persona guardando l'orologio di
casa, quindi il nodo ha bisogno di entrambe le cose — l'istante assoluto e lo
scarto per tradurlo in ora civile.

Prima questo campo non c'era: il nodo scriveva l'epoch UTC nel DS1307 e poi
confrontava `rtc.now().hour()` con l'orario impostato in Home Assistant.
"Irriga alle 6:00" voleva dire le 6:00 UTC, cioè **le 8:00 italiane d'estate**,
e nei log l'unica traccia era un `fuori_orario` alle 6 del mattino.

`tz` manca solo se il ponte non è aggiornato. Il nodo distingue "campo assente"
da "scarto zero" (che è un fuso legittimo) e, finché non l'ha mai ricevuto, non
fa partire l'irrigazione automatica: pubblica l'esito `fuso_sconosciuto`
invece di tirare a indovinare di due ore. **Nodo e ponte vanno quindi
riflashati insieme.**

Il ponte invia l'ACK **solo dopo che il broker ha confermato di aver ricevuto
il dato**. Se MQTT o il WiFi sono giù, o il collegamento è in stallo, l'ACK non
parte, il nodo non riceve conferma e conserva il dato sulla microSD: è così che
la catena "nessun dato perso" resta intatta.

**Come fa il ponte a saperlo: l'eco di conferma** (firmware del ponte 2.4.0).
Una pubblicazione MQTT a QoS 0 non ha conferma: `publish()` restituisce `true`
appena i byte entrano nel buffer TCP dell'ESP32, non quando arrivano. Fino alla
2.3.0 bastava quello per mandare l'ACK. Il WiFi del ponte però va in stallo
14-22 volte al giorno, e dal 13/09 12 cicli persi su 15 sono caduti proprio
dentro uno stallo: ACK partito, dato mai arrivato, niente nel backlog.

Ora, dopo i dati, il ponte pubblica un gettone su `serra/ponte/eco`, un topic a
cui è iscritto lui stesso, e manda l'ACK solo quando il gettone torna
(`ECO_TIMEOUT_MS`, 800 ms). L'eco viaggia sulla stessa connessione **dopo** i
dati, e il broker elabora i messaggi di un client nell'ordine in cui arrivano:
se ha rimandato indietro l'eco, i dati li aveva già. Sul broker di casa l'eco
torna in meno di un millisecondo in rete cablata. Il nodo aspetta l'ACK per
2 s, quindi i margini ci sono. Dall'eco dipende anche il keepalive, alzato da
30 a 60 s: senza eco un keepalive lungo allungava il tempo in cui il ponte
confermava dati destinati a un socket morto, con l'eco non costa più nulla.

**Ritrasmissione dello stesso pacchetto.** Se il nodo non sente l'ACK,
ritrasmette. Il ponte riconosce il duplicato (stessi `s` e `t`), non lo
ripubblica e conferma di nuovo. Se l'ACK perso portava un comando, glielo
riallega: prima rispondeva con un ACK senza comando, e il comando, già tolto
dalla coda, non veniva eseguito da nessuno.

**Quando gli ACK smettono di arrivare** (firmware del ponte 2.5.0). Un
duplicato di un pacchetto già confermato è la prova che quell'ACK il nodo non
l'ha sentito. Capita ogni tanto; per tre cicli di fila (`ACK_PERSI_CICLI`)
vuol dire che è la trasmissione del ponte a non arrivare, e il ponte resetta e
riconfigura la propria radio prima di rispondere. Non è un caso teorico: dal 13
al 20/10/2026 il ponte ha ricevuto ogni pacchetto e risposto a ognuno, ma il
nodo non ha sentito una sola risposta per sei giorni e mezzo (tre tentativi a
ciclo, `txp` sempre a 4, backlog salito fino a 344 record), e si è sistemato
solo riflashando il ponte. Le ritrasmissioni di pacchetti già confermati le
conta `ack_persi` nella diagnostica del ponte. La radio del ponte si sorveglia
anche da sola, rileggendone i registri, e si resetta se il nodo resta muto per
due cicli: vedi [`camera_ponte/radio.h`](../camera_ponte/radio.h).

### 2.3 Esito di un comando — nodo → ponte

È un normale pacchetto dati con in più:

```
...;res=<cmdId>;rc=<codice>;det=<testo>
```

| `rc` | Significato |
|---|---|
| 0 | Eseguito |
| 1 | Opcode sconosciuto |
| 2 | Argomenti non validi |
| 3 | Rifiutato da un limite di sicurezza |
| 4 | Hardware richiesto assente (es. flussometro) |
| 5 | Errore interno |

Anche questo pacchetto riceve un ACK, che può contenere il **comando
successivo**: così una coda di più comandi si svuota tutta nello stesso
risveglio, senza finestre di ascolto aggiuntive.

---

## 3. Chiavi in uso

### Trasporto e controllo

`v` `s` `t` `now` `tz` `c` `o` `a` `res` `rc` `det` `trunc` `ping` `h` `bk`

`bk=1` marca un record ritrasmesso dal backlog (vedi §2.1). La discovery del
ponte lo ignora: non diventa un'entità.

`trunc=1` compare quando il pacchetto avrebbe superato il tetto e alcuni campi
sono stati **omessi**: meglio un pacchetto valido e incompleto che uno tagliato
a metà e non interpretabile.

I campi vengono scritti in ordine di importanza — sensori, poi stato, infine
diagnostica (`fw`, `rst`, `tp`, `txp`) — quindi è la diagnostica a saltare per
prima. I margini sono stretti: il pacchetto più lungo che il nodo possa
produrre davvero (dopo un riavvio anomalo, con tutti i valori alla lunghezza
massima) occupa 235 byte, e 240 una volta accodato con il marcatore, contro un
limite utile di 240 e 236. Lo verifica
[`tools/test_arretrati.py`](../tools/test_arretrati.py): **va rilanciato ogni
volta che si aggiunge un campo al pacchetto.**
In ogni caso l'omissione non fa danni: i template di Home Assistant rendono
stringa vuota per le chiavi assenti, e gli aggiornamenti vuoti vengono scartati,
così ogni entità conserva l'ultimo valore buono fino al pacchetto successivo.

`h` è **riservato a un tag di autenticazione HMAC**, oggi non generato né
verificato. Il parser lo tratta come un campo qualunque, quindi potrà essere
attivato in futuro senza rompere la compatibilità.

### Sensori (tabella in [`sensori.cpp`](../serra_nodo/sensori.cpp))

| Chiave | Unità | Descrizione |
|---|---|---|
| `temp` `hum` `pres` | °C, %, hPa | BME280 |
| `luce` | % | Fotoresistenza |
| `volt` | V | Tensione batteria |
| `soil1`…`soil4` | % | Umidità terreno |
| `acqua` | L | Litri dell'ultima irrigazione |
| `acquaTot` | L | Contatore cumulativo (`total_increasing` in HA) |

Il valore **`-127`** è la sentinella di "sensore non disponibile". Viene usata
al posto di `nan` perché `nan` non è JSON valido e romperebbe il parsing in
Home Assistant. Il ponte la converte in stringa vuota, così Home Assistant
scarta l'aggiornamento e conserva l'ultimo valore buono invece di sporcare i
grafici con dei -127.

### Stato del nodo

| Chiave | Descrizione |
|---|---|
| `irr` | Esito dell'irrigazione, o motivo per cui non è partita (vedi §5) |
| `bl` | Record in attesa nel backlog su microSD. **`-1` = microSD assente o guasta** (dal fw 2.5.0: prima valeva 0 anche in quel caso, e "coda vuota" e "nessuna coda" non si distinguevano) |
| `sAuto` | Irrigazione automatica attiva (0/1) |
| `sOra` `sMin` | Orario programmato |
| `sDur` | Durata programmata in secondi |
| `sSoil` | Soglia umidità terreno (−1 = disattivata) |
| `slp` | Intervallo di deep sleep in secondi |
| `fw` `rst` | Versione firmware e motivo dell'ultimo reset (solo dopo un reset anomalo) |
| `tp` | Tappa del ciclo in cui il nodo si era fermato prima di riavviarsi, in chiaro (`tx_stato`, `sd`, `irrigazione`…). Accompagna `fw` e `rst`, quindi compare solo dopo un reset anomalo, e manca alla primissima accensione perché la memoria RTC non contiene ancora niente di attendibile. In Home Assistant è `sensor.serra_tappa_ultimo_blocco` (dal ponte 2.4.0: prima finiva in un'entità numerica che la mostrava sempre vuota) |
| `txp` | Tentativi che ha richiesto il pacchetto principale del ciclo **precedente**: 1 al primo colpo, fino a 3 con le ritrasmissioni, 4 se non è passato ed è finito nel backlog, 0 al primo ciclo dopo un'interruzione di corrente |
| `rs` | Pacchetti in attesa nella riserva in RAM RTC (dal fw 2.6.0). Solo nel pacchetto principale, solo se diverso da zero, ed è l'ultimo campo: entra solo se il pacchetto lo può portare anche una volta accodato (`aggiungiSeCiSta()`), altrimenti si rinuncia senza `trunc=1`. Il ponte 2.6.0 lo annuncia con un template suo: nel pacchetto principale (quello con `txp`) la sua assenza vale 0 |

**Eventi ripetuti finché non arrivano.** `fw`, `rst` e `tp`, e l'esito di
un'irrigazione in `irr`, sono fatti e non letture. Se il pacchetto che li
porta non passa, il record finisce nello storico, che Home Assistant non legge
come stato. Per questo il nodo li ripete nel pacchetto principale dei risvegli
successivi, finché uno viene confermato. Senza, un `nessun_flusso` accodato non
farebbe mai scattare l'allarme, e un riavvio anomalo resterebbe invisibile. Lo
stato "pendente" sta in memoria RTC e sopravvive anche ai riavvii.

I campi `s*` esistono perché Home Assistant mostri la configurazione **reale
del nodo** invece di quella che crede di aver impostato: se un comando si è
perso, la dashboard se ne accorge da sola al risveglio successivo.

---

## 4. Comandi

Home Assistant pubblica su `serra/nodo/cmd/<OPCODE>` con **`retain: true`**.
Il broker fa da coda persistente; il ponte cancella il messaggio ritenuto nel
momento in cui consegna il comando al nodo.

| Opcode | Argomenti | Effetto |
|---|---|---|
| `IRR` | `secondi` (0 = durata configurata) | Irrigazione manuale a tempo |
| `IRRVOL` | `litri[,max_sec]` | Irrigazione volumetrica (serve il flussometro) |
| `STOP` | — | Blocca l'irrigazione per il resto della giornata |
| `AUTO` | `0\|1` | Abilita/disabilita la programmazione automatica |
| `SCHED` | `ora,minuto,durata_s` | Imposta tutto insieme |
| `DUR` | `secondi` | Solo la durata |
| `ORA` | `HH:MM[:SS]` | Solo l'orario |
| `ORAH` / `ORAM` | `0-23` / `0-59` | Ora e minuto separati (usati dalle due entita number di HA, perche le entita time non vengono create su tutte le installazioni) |
| `SOIL` | `soglia%` (−1 disattiva) | Soglia per l'irrigazione condizionata |
| `SLEEP` | `secondi` | Intervallo di deep sleep |
| `TIME` | `epoch` | Forza la sincronizzazione dell'orologio |
| `CAL` | `chiave,p1[,p2]` | Calibrazione (vedi sotto) |
| `SENS` | `chiave,0\|1` | Abilita/disabilita un sensore |
| `WAKE` | `secondi` | Finestra di manutenzione |
| `CLRBL` | — | Svuota il backlog |
| `RESETCFG` | — | Ripristina le impostazioni di fabbrica |
| `RESET` | — | Riavvia il nodo |

**Calibrazione (`CAL`)**

| Chiave | p1 | p2 |
|---|---|---|
| `soil1`…`soil4` | grezzo misurato in aria (secco) | grezzo misurato in acqua (bagnato) |
| `volt` | rapporto del partitore | — |
| `acqua` | impulsi per litro | — |

Esempio dal server:

```bash
mosquitto_pub -h 192.168.1.36 -u utente_serra -P <password> \
  -t "serra/nodo/cmd/CAL" -m "soil1,3010,1290" -r
```

### 4.1 Come arriva un comando a un nodo che dorme

```
nodo  ── dati ──────────────────────────────►  ponte ──► MQTT ──► Home Assistant
nodo  ◄── ACK;s=42;now=…;c=7;o=IRR;a=120 ────  ponte
        [il nodo esegue]
nodo  ── dati;res=7;rc=0;det=ok ────────────►  ponte ──► serra/nodo/cmd/res
```

Il comando viaggia **dentro l'ACK che il nodo aspetta già**: nessuna finestra
di ascolto aggiuntiva, nessun consumo extra di batteria, nessun pacchetto in
più nel caso normale.

**Latenza:** un comando viene eseguito al primo risveglio utile, quindi entro
un intervallo di deep sleep (15 minuti con la configurazione predefinita).
Home Assistant lo mostra come "in coda" finché non arriva l'esito, così
l'attesa è visibile e non sembra un malfunzionamento.

**Semantica di consegna:** *at-most-once*. Il comando viene rimosso dalla coda
alla **consegna**, non alla ricezione dell'esito. Se l'esito si perde per
strada, l'irrigazione **non** viene ripetuta: è la direzione sicura, coerente
con il principio del progetto — meglio un'irrigazione mancata che una serra
allagata.

### 4.2 Sicurezza

Il collegamento LoRa è **in chiaro e non autenticato**: è una scelta esplicita.
Di conseguenza la protezione sta interamente nei limiti compilati nel firmware
del nodo ([`config.h`](../serra_nodo/config.h)), che nessun comando può superare:

| Limite | Default | Cosa impedisce |
|---|---|---|
| `IRRIG_MAX_SEC` | 900 s | Durata massima assoluta: `IRR,99999` viene clampato |
| `IRRIG_MIN_INTERVALLO_M` | 30 min | Comandi ripetuti a raffica |
| `IRRIG_MAX_AL_GIORNO` | 4 | Irrigazioni ripetute nella stessa giornata |
| `BUDGET_LITRI_GIORNO` | 50 L | Chiude la valvola anche a metà irrigazione |

Se in futuro vorrai autenticare i comandi, il campo `h` è già previsto dal
formato: basta calcolare un HMAC troncato su nodo e ponte, senza toccare il
resto.

---

## 5. Esiti dell'irrigazione (campo `irr`)

Il campo dice due cose diverse a seconda di cosa è successo nel risveglio.

**Se l'acqua è scorsa davvero**, riporta com'è andata — e vale anche per il
bottone "Irriga ora": prima l'esito di un'irrigazione manuale viaggiava solo
nel campo `det` del pacchetto di esito comando, quindi in Home Assistant non
compariva mai, e se quel pacchetto si perdeva (o il nodo si resettava prima di
mandarlo) non ne restava traccia da nessuna parte.

**Negli altri risvegli** riporta il motivo per cui l'automatica non è partita,
che è la diagnostica per cui il campo era nato.

| Valore | Significato |
|---|---|
| `ok` | Eseguita regolarmente |
| `fuori_orario` | Non è l'ora programmata (il caso normale, 95 risvegli su 96) |
| `auto_disattivata` | Programmazione automatica spenta |
| `gia_fatta` | L'appuntamento di oggi è già stato onorato, o massimo giornaliero |
| `troppo_presto` | Meno di `IRRIG_MIN_INTERVALLO_M` dall'ultima |
| `terreno_umido` | Il terreno è già sopra soglia: acqua risparmiata |
| `budget_esaurito` | Superato il budget litri della giornata |
| `ora_non_attendibile` | Orologio non sincronizzato: non si rischia |
| `fuso_sconosciuto` | Il ponte non ha ancora detto in che fuso siamo (vedi §2.2) |
| `nessun_flusso` | Valvola aperta ma il flussometro non ha contato nulla |
| `interrotta` | Il nodo si è resettato con la valvola ancora aperta |

`interrotta` non è una diagnosi di comodo: l'esito e i litri vengono scritti in
NVS **prima** di aprire, con questo valore, e sostituiti solo alla chiusura
della valvola. Se al risveglio il marcatore è ancora alzato vuol dire che
l'irrigazione non è mai arrivata in fondo. Insieme compare `acqua = 0`, che è
la verità disponibile: il conteggio degli impulsi vive in RAM e il reset se
l'è portato via. Prima di questo marcatore un'irrigazione interrotta spariva
del tutto, e in Home Assistant restava esposto l'esito di quella *precedente*
come se fosse appena successo.

`nessun_flusso` è l'allarme più utile del sistema: segnala serbatoio vuoto,
pompa guasta, filtro otturato, tubo staccato — oppure semplicemente il
flussometro scollegato.

Non scatta subito, perché l'acqua impiega qualche secondo a percorrere il tubo
e a far girare la turbina: c'è una finestra di grazia (`FLUSSO_GRAZIA_SEC`,
5 s) durante la quale gli impulsi vengono contati ma il flusso non viene
giudicato, seguita da un'attesa vera e propria (`FLUSSO_TIMEOUT_SEC`, 10 s).
Se l'irrigazione finisce prima che il conto arrivi a fine, il verdetto viene
comunque emesso alla chiusura della valvola: zero impulsi dopo la sola
finestra di grazia significa zero acqua. Senza questo controllo finale
un'irrigazione manuale breve — proprio quella che si fa per provare
l'impianto — passerebbe a vuoto senza segnalare nulla.

---

## 6. Topic MQTT

| Topic | Direzione | Retained | Contenuto |
|---|---|---|---|
| `serra/nodo/stato` | ponte → HA | sì | Dati **freschi** in JSON |
| `serra/nodo/storico` | ponte → HA | no | Record recuperati dal backlog |
| `serra/nodo/cmd/<OPCODE>` | HA → ponte | sì | Comando in coda |
| `serra/nodo/cmd/res` | ponte → HA | no | Esito di un comando |
| `serra/nodo/cmd/pending` | ponte → HA | sì | Comandi ancora in attesa |
| `serra/ponte/stato` | ponte → HA | sì | `online`/`offline` (Last Will) |
| `serra/ponte/diag` | ponte → HA | sì | Diagnostica del ponte (compresi `eco_ko`, i pacchetti rimasti senza ACK per eco mancata, ed `eco_ms`, il tempo dell'ultima eco; dalla 2.5.0 anche lo stato della radio: `radio_ok`, `radio_rip`, `radio_causa`, `radio_det`, `radio_avv`, `rst_hw`, `ack_persi`, `spi_inc`, `crc_ko`; dalla 2.6.0 `storici`, i record arretrati pubblicati su `serra/nodo/storico`; dalla 2.6.1 `radio_falliti`, gli avvii della radio falliti di fila, e `radio_ok` a 0 anche quando il modulo risponde ma non entra in ricezione) |
| `serra/ponte/log` | ponte → HA | sì | L'ultima riparazione della radio del ponte, con motivo e dettaglio (per esempio il registro trovato alterato) |
| `serra/ponte/eco` | ponte → ponte | no | Eco di conferma (§2.2): il ponte deve poterci scrivere **e** leggere |
| `homeassistant/…/config` | ponte → HA | sì | MQTT Discovery |

**Perché due topic distinti per i dati.** Il nodo trasmette prima il pacchetto
fresco e subito dopo la coda arretrata recuperata dalla microSD. Se finissero
tutti su `serra/nodo/stato`, Home Assistant mostrerebbe come "valore attuale"
una lettura di ore prima — l'ultima arrivata, non la più recente.

Va detto con chiarezza: **MQTT non permette di retrodatare la cronologia** di
Home Assistant. I record del backlog arriverebbero comunque con il timestamp di
ricezione. Con la separazione almeno non sporcano più lo stato corrente, e
restano disponibili su un topic dedicato per un eventuale ingest futuro
(InfluxDB o SQL, che accettano il timestamp esplicito).

---

## 7. Compatibilità con il v1

Il ponte riconosce la versione dal separatore: `;` è v2, `,` è v1. I pacchetti
v1 vengono convertiti al volo (`protoParseV1`) mappando le posizioni sulle
chiavi corrispondenti.

Serve durante l'aggiornamento: sulla microSD del nodo possono esserci record
accodati dalla versione precedente del firmware, e vanno consegnati lo stesso
invece di essere buttati. **Aggiorna prima il ponte, poi il nodo**, così il
backlog residuo viene recuperato.

---

## 8. Aggiungere un sensore — la procedura completa

1. **Nodo** — in [`sensori.cpp`](../serra_nodo/sensori.cpp) scrivi la funzione
   di lettura (`NAN` = non disponibile) e aggiungi una riga a `SENSORI[]`.
   Aggiungi il bit corrispondente a `BitSensore` in `sensori.h`.
   Per un sensore analogico non serve nemmeno una funzione nuova: riusa
   `leggiPercentuale()` con un `CtxAnalogico`, come fanno i sensori terreno.
2. **Riflasha il nodo.** Fine della parte obbligatoria: il sensore compare in
   Home Assistant al primo pacchetto, con nome uguale alla chiave.
3. *(facoltativo)* — in [`discovery.cpp`](../camera_ponte/discovery.cpp)
   aggiungi una riga a `ENTITA[]` per dargli nome leggibile, unità,
   `device_class` e icona, poi riflasha il ponte.

Il passo 3 è opzionale proprio per questo: il dato è già al sicuro e
storicizzato mentre decidi come chiamarlo.
