Tressilloide/Serra_smart/Kimi_Agent_Smart Greenhouse ESP32 LoRa/docs/serra3d-neve.png

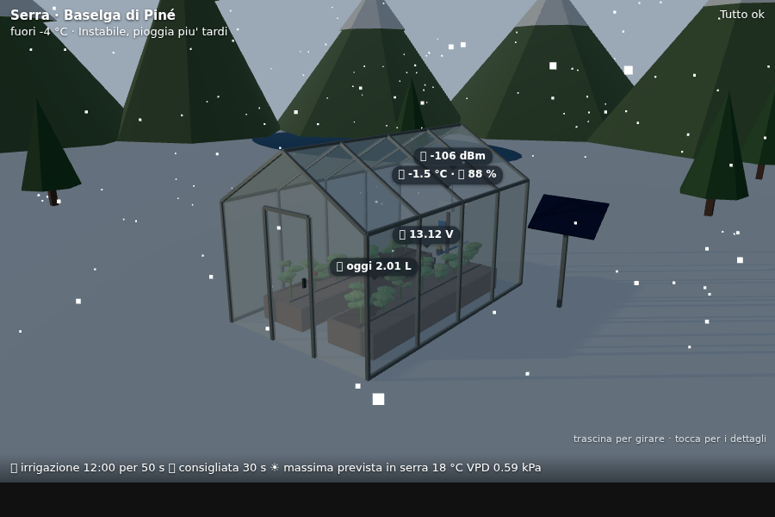
Kimi_Agent_Smart Greenhouse ESP32 LoRa/docs/serra3d-neve.png
