Tressilloide/Serra_smart/Kimi_Agent_Smart Greenhouse ESP32 LoRa/serra_nodo/config.h

/*
 * ============================================================================
 *  SERRA SMART — NODO SERRA : CONFIGURAZIONE
 * ============================================================================
 *  Tutti i parametri modificabili stanno qui. Il resto del codice non contiene
 *  numeri magici.
 *
 *  IMPORTANTE: molti di questi valori sono solo il DEFAULT di primo avvio.
 *  Una volta scritti in NVS (memoria non volatile) diventano modificabili da
 *  Home Assistant tramite i comandi LoRa (vedi comandi.h), e da quel momento
 *  il valore in NVS ha la precedenza su quello scritto qui.
 *  Per tornare ai default: comando RESETCFG oppure cancella la partizione NVS.
 * ============================================================================
 */

#pragma once

// ======================= IDENTITA' DEL NODO =================================

#define NODE_ID          "GH1"    // Identificativo di questo nodo (max 8 char)
#define FW_VERSION       "2.6.0"  // Riportata in Home Assistant

// ======================= RADIO LoRa =========================================
// Questi parametri DEVONO essere identici sul ponte in camera.

#define LORA_BAND        433E6    // Ra-01 = SX1278 a 433 MHz. Se il tuo modulo
                                  // e' a 868 MHz usa 868E6 (anche sul ponte!).
#define LORA_SF          7        // Spreading factor
#define LORA_BW          125E3    // Larghezza di banda
#define LORA_CR          5        // Coding rate 4/5
#define LORA_TX_POWER    17       // dBm su PA_BOOST

#define TX_RETRIES       3        // Tentativi di invio per pacchetto
#define ACK_TIMEOUT_MS   2000     // Attesa ACK dal ponte dopo ogni invio

/*
 * Quanto puo' durare una trasmissione, in multipli del tempo di volo
 * previsto, prima di dichiarare piantato il modulo LoRa.
 *
 * Il tempo di volo di un pacchetto e' calcolabile in anticipo (vedi
 * tempoDiVoloMs() in radio.cpp): con SF7 e BW 125 kHz va da 57 ms per un
 * pacchetto corto a 390 ms per uno pieno. Concedere il triplo significa
 * che nessuna trasmissione legittima viene mai interrotta, e che una
 * trasmissione che non finisce costa meno di un secondo e mezzo invece dei
 * tre minuti del watchdog.
 */
#define TX_GUARDIA_X     3        // Fattore di guardia sul tempo di volo
#define TX_GUARDIA_MS    100      // ...piu' questo margine fisso

// ======================= TEMPI ==============================================

#define SLEEP_TIME_SEC   900      // Intervallo di deep sleep in secondi
                                  // (900 = 15 min, 3600 = 1 ora)
#define SLEEP_MIN_SEC    60       // Non dormire mai meno di cosi'
#define WDT_SETUP_SEC    60       // Watchdog globale: se il setup() si blocca
                                  // (SD, LoRa, I2C) il nodo si riavvia da solo

// ======================= IRRIGAZIONE — DEFAULT ==============================
// Modificabili da Home Assistant con il comando SCHED.

#define IRRIG_ORA_DEF    6        // Ora di inizio irrigazione (0-23)
#define IRRIG_MIN_DEF    0        // Minuto di inizio (0-59)
#define IRRIG_SEC_DEF    300      // Durata in secondi (300 = 5 minuti)
#define IRRIG_AUTO_DEF   true     // Irrigazione automatica attiva?

// L'orario e' ORA CIVILE ITALIANA, non UTC: il nodo somma all'ora del DS1307
// lo scarto del fuso che il ponte gli comunica a ogni ACK.

/*
 * Tolleranza sul risveglio ANTICIPATO.
 *
 * Il timer del deep sleep dell'ESP32 non e' preciso: conta su un oscillatore
 * RC calibrato alla meglio, e in pratica si sveglia qualche secondo PRIMA
 * dell'istante calcolato. Misurato sul campo: con sleep da 900 s i risvegli
 * cadono alle :59:56, :14:58, :29:58 invece che sull'ora tonda.
 *
 * Senza tolleranza quei 4 secondi sono un disastro silenzioso: con
 * l'irrigazione alle 6:00 il risveglio delle 5:59:56 non e' "4 secondi
 * presto", e' 23 ore e 59 minuti TARDI, perche' la distanza dall'orario
 * programmato si calcola sul giro delle 24 ore. La finestra veniva quindi
 * mancata sistematicamente al primo colpo e restava appesa al risveglio
 * successivo, 15 minuti dopo, con pochissimo margine residuo.
 */
#define IRRIG_ANTICIPO_SEC   300     // 5 minuti prima dell'ora contano come "adesso"

/*
 * Finestra di RECUPERO dopo l'orario programmato.
 *
 * La finestra minima e' un intervallo di sleep, il tempo che serve perche' il
 * risveglio successivo veda l'appuntamento. Ma basta un ciclo piu' lungo del
 * solito, una ritrasmissione LoRa o un riavvio per spostare il risveglio di
 * un paio di minuti, e la serra restava a secco per l'intera giornata senza
 * che nulla segnalasse il perche'.
 *
 * Il recupero e' sicuro perche' e' accoppiato a giornoProgrammata in NVS:
 * l'appuntamento di oggi si onora una volta sola, e la finestra larga serve
 * solo a trovare un risveglio buono, non a irrigare piu' volte.
 */
#define IRRIG_RECUPERO_SEC   3600    // fino a un'ora di ritardo e' ancora "oggi"

// ---------------------------------------------------------------------------
//  TETTI DI SICUREZZA — NON modificabili da remoto.
//  Sono compilati nel firmware: nessun comando proveniente da Home Assistant
//  (o da chiunque altro trasmetta sulla stessa frequenza) puo' superarli.
//  Sono l'ultima barriera contro l'allagamento della serra.
// ---------------------------------------------------------------------------

#define IRRIG_MAX_SEC          900   // Durata massima assoluta di UNA irrigazione
                                     // (15 min). Ogni richiesta viene clampata.
#define IRRIG_MIN_INTERVALLO_M 30    // Minuti minimi tra due irrigazioni: blocca
                                     // sia i comandi ripetuti sia i bug di logica
#define IRRIG_MAX_AL_GIORNO    4     // Numero massimo di irrigazioni giornaliere
#define BUDGET_LITRI_GIORNO    50.0f // Litri massimi al giorno (0 = disattivato).
                                     // Attivo solo se il flussometro e' presente.
//
// ATTENZIONE: questo tetto vale quanto vale la taratura del flussometro, ed e'
// il meno affidabile dei quattro. La taratura attuale (433 impulsi/L) e' stata
// fatta al banco versando un litro con l'imbuto, mentre in esercizio la
// valvola alimenta un impianto a goccia, la cui portata puo' stare sotto il
// minimo di specifica del YF-S201 (1 L/min): li' la turbina conta in modo
// irregolare o non conta affatto.
//
// Se il sensore sotto-conta, questo tetto non scatta mai. NON considerarlo
// la rete di sicurezza principale: quelle vere sono le tre qui sopra, che si
// basano sul TEMPO e non dipendono da nessuna misura -- durata massima,
// numero massimo giornaliero e intervallo minimo.

// ======================= SENSORI — FEATURE FLAG =============================
// Metti a 0 quello che non hai ancora collegato: il codice si adatta da solo,
// il pacchetto LoRa si accorcia e Home Assistant non mostra entita' fantasma.

#define USA_BME280       1        // Temperatura / umidita' / pressione (I2C)

/*
 * Limiti di plausibilita' del BME280: sono quelli di funzionamento del chip,
 * non quelli della serra, che d'estate arriva davvero oltre i 50 °C.
 *
 * Servono a riconoscere una lettura I2C fallita. Il 20/09 il nodo ha
 * pubblicato 180,39 °C, 100 % e -232,5 hPa: e' quello che la formula di
 * compensazione ricava da registri letti male, e la libreria lo restituisce
 * come fosse una misura. L'umidita' non ha limiti propri: la libreria la
 * costringe fra 0 e 100, e il 100 % di notte in serra e' un valore vero.
 */
#define BME_T_MIN        -40.0f   // °C
#define BME_T_MAX         85.0f   // °C
#define BME_P_MIN        300.0f   // hPa
#define BME_P_MAX       1100.0f   // hPa

#define USA_LUCE         1        // Fotoresistenza analogica su GPIO32
#define USA_TENSIONE     1        // Partitore di tensione su GPIO33

// Molti moduli con fotoresistenza danno tensione ALTA al buio e BASSA in piena
// luce. Se in Home Assistant vedi la luce al 90% di notte, metti 1 qui.
#define LUCE_INVERTITA   0

#define USA_SOIL         0        // Sensori umidita' terreno analogici
#define N_SOIL           0        // Quanti sensori terreno (max 4 su ADC nativo)
#define USA_FLUSSO       1        // Flussometro YF-S201

// Espansione analogica futura: mettendo a 1 i sensori analogici si spostano
// su un ADS1115 sul bus I2C, senza toccare nient'altro nel codice.
#define USA_ADS1115      0
#define ADS1115_ADDR     0x48

// ======================= CALIBRAZIONI — DEFAULT =============================
// Anche queste finiscono in NVS e sono modificabili da HA con il comando CAL.

// Partitore di tensione. I moduli "0-25V" usano 30k + 7.5k -> rapporto 5.0.
// CALIBRAZIONE: misura la batteria col multimetro (V_reale), leggi V_stampata
// dal seriale, poi:  nuovo = attuale * V_reale / V_stampata
#define VOLT_DIVIDER_DEF 5.0f

// Sensori terreno resistivi: valori grezzi ADC (0-4095) letti in aria e in acqua.
// Sui resistivi il valore SCENDE quando il terreno e' bagnato, quindi
// rawSecco > rawBagnato ed e' normale.
// Taratura reale: comando CAL,soil1,<secco>,<bagnato> da Home Assistant.
#define SOIL_RAW_SECCO_DEF   3000
#define SOIL_RAW_BAGNATO_DEF 1300

// Soglia di umidita' terreno sotto la quale irrigare (%). -1 = irrigazione
// non condizionata al terreno (si comporta come prima: solo orario).
#define SOIL_SOGLIA_DEF  -1

// Flussometro YF-S201: impulsi per litro.
// Il datasheet dichiara F = 7.5 * Q(L/min), cioe' 450 impulsi/litro, ma varia
// parecchio da esemplare a esemplare. Questo valore e' quello MISURATO sul
// nostro sensore versando un litro con l'imbuto: 433 impulsi, che corrisponde
// a K = 433/60 = 7.22.
//
// Attenzione a una cosa: le turbine di questi flussometri sono poco lineari
// alle portate basse, e un litro versato a mano scorre molto piu' lentamente
// dell'acqua spinta dalla pompa. Quando l'impianto sara' collegato, conviene
// riverificare con un secchio graduato alla portata reale e correggere con
// il comando CAL,acqua,<impulsi>.
#define FLUSSO_IMP_LITRO_DEF 433.0f

// Resistenza di pull-up interna sul pin degli impulsi.
//
// 1 = pull-up interno attivo. E' la configurazione in uso: il sensore e'
//     alimentato a 3,3 V e il filo del segnale va diritto sul GPIO, senza
//     partitore ne' condensatore. Alimentandolo a 3,3 V nel circuito non
//     esiste nessun 5 V, quindi il pin non puo' ricevere sovratensioni.
// 0 = nessun pull-up: da usare se alimenti il sensore a 5 V e hai messo il
//     partitore resistivo o un level shifter (vedi docs/PINOUT.md 2.2).
#define FLUSSO_PULLUP        1

// --- Sicurezza idraulica: rilevamento dell'irrigazione "a vuoto" -----------
//
// Se durante l'irrigazione non arriva NESSUN impulso, qualcosa non va: pompa
// guasta, serbatoio vuoto, filtro otturato, tubo staccato. Il nodo lo segnala
// a Home Assistant come "nessun_flusso".
//
// Il controllo si fa in due tempi, perche' l'acqua non arriva istantaneamente:
//
//   |<-- GRAZIA -->|<-- TIMEOUT -->|
//   valvola        acqua           se qui gli impulsi
//   aperta         attesa          sono ancora ZERO -> anomalia
//
// GRAZIA = tempo fisico perche' l'acqua percorra il tubo e la turbina inizi a
// girare. Durante questa finestra il flusso NON viene valutato: gli impulsi
// vengono comunque contati, semplicemente non si giudica ancora.
// Misura quanto ci mette davvero il tuo impianto e lascia un buon margine:
// il costo di un valore troppo alto e' solo un allarme che arriva piu' tardi,
// mentre uno troppo basso genera falsi allarmi a ogni irrigazione.
#define FLUSSO_GRAZIA_SEC    5

// TIMEOUT = quanto si aspetta ANCORA, dopo la grazia, prima di dichiarare
// l'anomalia. Sommati fanno il ritardo totale del rilevamento.
#define FLUSSO_TIMEOUT_SEC   10

/*
 * Impulsi sotto i quali, passate GRAZIA + TIMEOUT, l'acqua si considera
 * mancante. Prima la soglia era "zero impulsi esatti", e il 4/11/2026
 * l'irrigazione delle 12:00 ha erogato 0,002 L -- UN impulso, un rimbalzo
 * del segnale o una goccia -- invece dei soliti 2,2 L: esito "ok", nessun
 * allarme, serra a secco per un giorno senza che nessuno lo sapesse.
 * Con la portata reale (circa 2,6 L/min, ~19 impulsi al secondo) in quei
 * dieci secondi di verdetto ne arrivano a centinaia: 10 sono un margine
 * largo anche per un impianto a goccia molto piu' lento.
 */
#define FLUSSO_MIN_IMPULSI   10

// ======================= MICROSD / BACKLOG ==================================

#define FILE_BACKLOG     "/backlog.txt"
#define FILE_BACKLOG_TMP "/backlog.tmp"
#define FILE_LOG         "/log.txt"

#define BACKLOG_MAX_INVII   60        // Max record inviati per ciclo di veglia
#define BACKLOG_MAX_BYTE    262144UL  // Tetto dimensione file (256 KB, ~2000 rec).
                                      // Oltre, i record piu' VECCHI vengono scartati.
#define LOG_MAX_BYTE        65536UL   // Tetto del file di log (64 KB)

/*
 * Secondo tentativo di montaggio della microSD, a clock ridotto.
 *
 * La libreria monta la scheda a 4 MHz. Su fili lunghi, con un modulo
 * alimentato al limite (vedi docs/PINOUT.md 2.7) o con contatti ossidati,
 * il primo comando fallisce e la scheda risulta assente per l'intero ciclo:
 * dal 20/10/2026 succede a ogni risveglio. Un secondo tentativo a 1 MHz
 * costa qualche millisecondo e rimette in servizio le schede che a 4 MHz
 * non ce la fanno.
 */
#define SD_HZ_LENTO         1000000UL

/*
 * Riserva in memoria RTC (vedi riserva.h): dove aspettano i pacchetti non
 * consegnati quando la microSD manca. Circa 140 byte a pacchetto, quindi
 * 6 KB sono una quarantina di cicli, una decina d'ore: copre i buchi di
 * 4-9 ore visti il 3-5/11/2026, quando il segnale e' sceso a -121 dBm.
 *
 * La RAM RTC lenta dell'ESP32 e' di 8 KB, i primi 512 byte riservati al
 * coprocessore ULP e il resto condiviso con g_seq e la scatola nera. Con
 * 6144 restano circa 1,4 KB liberi (core 3.3.12). Se si sfora, e' il linker
 * a dirlo; per vedere quanto resta:
 *   xtensa-esp32-elf-objdump -h serra_nodo.ino.elf | grep rtc
 * (.rtc_noinit e .rtc.force_slow devono finire prima di .rtc_slow_reserved)
 */
#define RISERVA_BYTE        6144

// ======================= COMANDI ============================================

#define MAX_CMD_PER_RISVEGLIO 5       // Quanti comandi eseguire per ogni veglia
#define WAKE_MAX_SEC          300     // Tetto della finestra di manutenzione WAKE
/*
 * Deriva oltre la quale il DS1307 viene risincronizzato dall'ora del ponte.
 *
 * Era 30 s. Il DS1307 di questo nodo va avanti di circa 5 s al giorno, quindi
 * con 30 s la correzione arrivava ogni sei giorni e l'irrigazione partiva
 * fino a mezzo minuto prima dell'ora vera. Con 5 s si corregge circa una
 * volta al giorno. Non scendere sotto i 2 s: ponte e DS1307 contano a secondi
 * interi, e fra timbratura dell'ACK e lettura passa quasi un secondo, quindi
 * con una soglia piu' stretta la correzione scatterebbe a vuoto.
 */
#define RTC_DRIFT_MAX_SEC     5

// ============================ PINOUT ========================================

// --- I2C (BME280 + DS1307, e in futuro ADS1115 / sensori UV) ---
#define I2C_SDA 21
#define I2C_SCL 22

// --- SPI #1 (VSPI): microSD ---
#define SD_CS    4
#define SD_MOSI  23
#define SD_MISO  19
#define SD_SCK   18

// --- SPI #2 (HSPI): LoRa Ra-01 su bus dedicato ---
// ATTENZIONE GPIO12: e' lo strapping pin MTDI. Se e' ALTO al reset, l'ESP32
// imposta VDD_SDIO a 1.8 V e puo' non avviarsi. Monta un pulldown da 10k su
// GPIO12 e un pull-up da 10k su GPIO5 (NSS), cosi' il modulo LoRa resta
// deselezionato durante il boot e non pilota la linea MISO.
#define LORA_SCK2  27
#define LORA_MISO2 12
#define LORA_MOSI2 13
#define LORA_RST   14
#define LORA_DIO0  26
#define LORA_NSS   5

// --- Relay irrigazione ---
// GPIO25 e' un pin del dominio RTC: puo' mantenere attivamente il livello
// logico anche in deep sleep (gpio_deep_sleep_hold_en), quindi nessun glitch.
// La maggior parte dei moduli relay e' ATTIVA BASSA (LOW = relay eccitato).
// Se il tuo e' attivo alto, inverti le due righe qui sotto.
#define PIN_RELAY 25
#define RELAY_ON  LOW
#define RELAY_OFF HIGH

// --- Sensori analogici su ADC1 (l'unico sempre disponibile) ---
#define PIN_LUM   32     // Fotoresistenza
#define PIN_VOLT  33     // Partitore di tensione
#define PIN_SOIL1 34     // Umidita' terreno 1 (solo input)
#define PIN_SOIL2 35     // Umidita' terreno 2 (solo input)
#define PIN_SOIL3 36     // Riserva (VP, solo input)
#define PIN_SOIL4 39     // Riserva (VN, solo input)

// --- Flussometro ---
//
// Impulsi YF-S201, su interrupt a fronte di discesa.
//
// NON usare GPIO 16 o 17: sui moduli ESP32-WROVER (le schede a 38 pin, quelle
// con il modulo metallico piu' lungo) sono cablati al chip di PSRAM e non
// funzionano come ingresso. Il sintomo e' inequivocabile e ci e' costato una
// serata: il pin resta fisso a livello alto, il conteggio non parte mai, e
// nel frattempo la stessa identica cablatura su una scheda WROOM a 30 pin
// funziona perfettamente.
//
// GPIO 15 invece va bene su entrambi i moduli, ha il pull-up interno (che
// serve, perche' l'uscita del sensore e' open-drain) ed e' nel dominio RTC.
// E' uno strapping pin, ma il suo stato di riposo e' proprio quello alto che
// gli serve, quindi non disturba il boot.
//
// ATTENZIONE se un giorno riattivi l'alimentazione commutata dei sensori:
// anche quella vorrebbe GPIO 15. Va scelto un altro pin per una delle due.
#define PIN_FLUSSO       15

// --- Alimentazione commutata dei sensori terreno ---
//
// I sensori resistivi a due punte si corrodono per elettrolisi se lasciati
// sotto tensione: vanno alimentati solo per il tempo della misura. Servono
// quindi un interruttore comandato dall'ESP32 e questo pin per pilotarlo.
//
// Puoi usare indifferentemente:
//   - un MOSFET P lato alto sul rail 3,3 V  -> PWR_SENSORI_ON = HIGH
//   - un canale libero del modulo relay     -> PWR_SENSORI_ON = LOW
//     (i moduli relay comuni sono ATTIVI BASSI, come quello dell'irrigazione)
// Metti -1 per alimentarli in permanenza: funziona, ma i sensori durano
// poche settimane.
//
// Perche' GPIO 15 e non 16: il 15 appartiene al dominio RTC, quindi il suo
// livello puo' essere MANTENUTO durante il deep sleep invece di restare
// flottante per 15 minuti con il relay che potrebbe eccitarsi da solo.
// In piu' al reset ha un pull-up interno, quindi si presenta ALTO: con un
// relay attivo basso questo significa "spento" gia' prima che parta il
// firmware, senza bisogno di resistenze esterne.
// >>> ATTUALMENTE DISATTIVATA: i sensori restano sempre alimentati. <<<
//
// Per attivarla basta rimettere 15 al posto di -1 e cablare l'interruttore:
// tutto il resto del codice e' gia' pronto e condizionato a questo valore.
//
// ATTENZIONE, il motivo per cui esiste NON e' il consumo: alimentare due
// sensori costa una manciata di milliampere, del tutto trascurabili accanto
// agli ~80 mA che l'ESP32 assorbe da sveglio. Il motivo e' la CORROSIONE:
// i sensori resistivi a due punte, tenuti costantemente sotto tensione, si
// consumano per elettrolisi e in poche settimane iniziano a dare letture
// sbagliate, per poi smettere del tutto.
// Il sintomo da tenere d'occhio non e' quindi la batteria che cala, ma
// l'umidita' del terreno che deriva verso valori sempre piu' bassi e
// incoerenti tra i due sensori. Vedi docs/PINOUT.md 2.1.1.
#define PIN_PWR_SENSORI  -1
#define PWR_SENSORI_ON   LOW  // LOW = modulo relay (attivo basso). HIGH = MOSFET P.
#define PWR_SETTLE_MS    250  // Attesa dopo l'accensione, prima di leggere.
                              // Copre sia l'attuazione del relay (~10 ms) sia
                              // l'assestamento del partitore del sensore.

// Il sensore terreno va alimentato a 3,3 V e NON a 5 V: la sua uscita analogica
// segue la tensione di alimentazione e a 5 V danneggerebbe l'ADC dell'ESP32.

// ======================= LETTURE ANALOGICHE =================================

#define ADC_CAMPIONI     16       // Campioni mediati per ogni lettura analogica
#define ADC_DELAY_MS     3        // Pausa tra un campione e l'altro

// Sentinella "sensore non disponibile". Viene inviata al posto di NaN perche'
// "nan" non e' JSON valido e romperebbe il parsing in Home Assistant.
#define VAL_NON_DISPONIBILE -127.0f

// ======================= COERENZA DEL PINOUT ================================
// Controlli a tempo di compilazione: meglio un errore in fase di build che una
// serata a inseguire un sensore che non legge.

#if (PIN_PWR_SENSORI >= 0) && (PIN_PWR_SENSORI == PIN_FLUSSO)
  #error "PIN_FLUSSO e PIN_PWR_SENSORI sono sullo stesso GPIO: cambiane uno."
#endif

#if USA_FLUSSO && (PIN_FLUSSO == 16 || PIN_FLUSSO == 17)
  #warning "PIN_FLUSSO su GPIO 16/17: non funziona sui moduli WROVER (schede a 38 pin), dove sono cablati alla PSRAM."
#endif

#if USA_FLUSSO && FLUSSO_PULLUP && (PIN_FLUSSO >= 34)
  #error "I GPIO 34-39 sono di solo ingresso e NON hanno pull-up interno: con FLUSSO_PULLUP servirebbe una resistenza esterna."
#endif
