Tressilloide/Serra_smart/Kimi_Agent_Smart Greenhouse ESP32 LoRa/camera_ponte/camera_ponte.ino

/*
 * ============================================================================
 *  SERRA SMART — PONTE LoRa <-> WiFi/MQTT  (ESP32 in camera)
 * ============================================================================
 *
 *  Versione in config.h (FW_VERSION_PONTE) — vedi docs/Guida_Serra_Smart.md
 *  e docs/PROTOCOLLO.md
 *
 *  ---------------------------------------------------------------------------
 *  COMPITI
 *  ---------------------------------------------------------------------------
 *   - Restare SEMPRE in ascolto LoRa: il nodo trasmette per pochi secondi ogni
 *     15 minuti, non possiamo permetterci di perdere quella finestra
 *   - Pubblicare ogni pacchetto su MQTT e rispondere con un ACK SOLO quando il
 *     broker ha confermato di averlo ricevuto (eco di conferma), cosi' un dato
 *     non arrivato resta al sicuro sulla microSD della serra
 *   - Consegnare al nodo i comandi che Home Assistant ha messo in coda,
 *     agganciandoli all'ACK: e' l'unico momento in cui la serra ascolta
 *   - Allegare a ogni ACK l'ora NTP, cosi' il DS1307 della serra si
 *     risincronizza da solo quando la batteria tampone si scarica
 *   - Generare da solo le entita' di Home Assistant, comprese quelle nuove
 *     che non conosce (discovery generica)
 *   - Riconnettersi ad automaticamente a WiFi e MQTT senza mai smettere di
 *     ascoltare la radio
 *   - Accorgersi da solo che la radio e' finita in uno stato sbagliato, e
 *     rimetterla in sesto senza aspettare che qualcuno lo riflashi (radio.h)
 *
 *  ---------------------------------------------------------------------------
 *  LIBRERIE NECESSARIE
 *  ---------------------------------------------------------------------------
 *    - "LoRa" by Sandeep Mistry
 *    - "PubSubClient" by Nick O'Leary
 *
 *  PRIMA DI COMPILARE: copia secrets.h.example in secrets.h e compilalo.
 *
 *  Scheda: "ESP32 Dev Module"
 * ============================================================================
 */

#include <WiFi.h>
#include <PubSubClient.h>
#include <esp_task_wdt.h>
#include <time.h>

#include "config.h"
#include "secrets.h"
#include "protocollo.h"
#include "discovery.h"
#include "comandi.h"
#include "radio.h"

#if ABILITA_OTA
  #include <ArduinoOTA.h>
#endif

#ifndef ESP_ARDUINO_VERSION_VAL
  #define ESP_ARDUINO_VERSION_VAL(a, b, c) (((a) << 16) | ((b) << 8) | (c))
#endif
#ifndef ESP_ARDUINO_VERSION
  #define ESP_ARDUINO_VERSION ESP_ARDUINO_VERSION_VAL(2, 0, 0)
#endif

// ============================ GLOBALI =======================================

WiFiClient   espClient;
PubSubClient mqtt(espClient);

static uint32_t ultimoTentativoWifi = 0;
static uint32_t ultimoTentativoMqtt = 0;
static uint32_t ultimaDiagnostica   = 0;
static uint32_t ultimaDiscovery     = 0;   // 0 = mai pubblicata
static uint32_t wifiGiuDa           = 0;

static uint32_t riconnessioniWifi   = 0;
static uint32_t riconnessioniMqtt   = 0;
static uint32_t pacchettiRicevuti   = 0;
static uint32_t pacchettiScartati   = 0;
static uint32_t comandiConsegnati   = 0;
static uint32_t recordStorici       = 0;   // arretrati pubblicati su serra/nodo/storico
static int      ultimoRssi          = 0;
static float    ultimoSnr           = 0.0f;

/*
 * Perche' e' caduta l'ultima connessione MQTT, e con che segnale WiFi.
 *
 * Finora si sapeva solo QUANTE volte era caduta. Il log del broker diceva
 * sempre "exceeded timeout", cioe' "non ho piu' ricevuto niente da te", e
 * da li' non si poteva distinguere fra due cose molto diverse: il ponte che
 * smette di trasmettere, e il ponte che trasmette senza che arrivi.
 *
 * mqtt.state() letto NEL MOMENTO in cui ci si accorge della caduta separa i
 * due casi: -4 (timeout) significa che e' stato il ponte a chiudere perche'
 * il suo ping non ha avuto risposta, -3 (lost) che se l'e' vista chiudere
 * sotto. Il RSSI dello stesso istante dice se quando succede il segnale era
 * gia' in difficolta'.
 */
static int      statoUltimaCaduta   = 0;
static int      rssiUltimaCaduta    = 0;

// Anti-duplicati: il nodo ritrasmette se l'ACK si perde, e senza questo
// controllo il dato finirebbe due volte nello storico e nel totale dell'acqua.
struct ChiaveDedup { uint32_t seq; uint32_t ts; };
static ChiaveDedup dedup[DEDUP_MEMORIA];
static uint8_t     dedupIdx = 0;

// Eco di conferma (vedi confermaDalBroker()). Il gettone atteso cambia a ogni
// pacchetto, cosi' un'eco in ritardo di un giro precedente non conferma
// quello attuale.
static char     ecoAtteso[24]  = "";
static bool     ecoTornato     = false;
static uint32_t ecoMancate     = 0;    // pacchetti rimasti senza ACK per eco mancata
static uint32_t ultimaEcoMs    = 0;    // tempo di andata e ritorno dell'ultima eco

// Timestamp dell'ultimo pacchetto FRESCO confermato dal broker (0 = nessuno
// dall'avvio). Vedi STORICO_MARGINE_SEC in config.h.
static uint32_t ultimoTsFresco = 0;

/*
 * L'ultimo comando consegnato dentro un ACK, con il pacchetto a cui era
 * allegato.
 *
 * Il comando esce dalla coda quando parte l'ACK. Se il nodo quell'ACK non lo
 * sente, ritrasmette lo stesso pacchetto: prima gli si rispondeva con un ACK
 * nudo, e il comando era perso senza che nessuno lo eseguisse. Ora, per quella
 * sola ritrasmissione, gli si riallega lo stesso comando. Resta "al massimo
 * una volta": il nodo elabora un solo ACK per ogni numero di sequenza.
 */
static bool          ackCmdValido = false;
static uint32_t      ackCmdSeq    = 0;
static uint32_t      ackCmdTs     = 0;
static uint32_t      ackCmdMs     = 0;
static ComandoInCoda ackCmd;

// L'ultimo pacchetto confermato, per accorgersi se il nodo lo ritrasmette
// (vedi controllaAckPerso()).
static bool     ackInviatoValido  = false;
static uint32_t ackInviatoSeq     = 0;
static uint32_t ackInviatoTs      = 0;
static bool     ackInviatoTornato = false;   // il nodo l'ha gia' ritrasmesso
static uint8_t  cicliAckPersi     = 0;
static uint32_t ackPersi          = 0;       // ritrasmissioni di pacchetti gia' confermati

// Sorveglianza del silenzio del nodo (vedi sorvegliaSilenzio()).
static uint32_t ultimoDalNodoMs       = 0;   // ultimo pacchetto leggibile del nodo
static uint32_t riferimentoSilenzioMs = 0;   // da li', o dall'ultimo reset per silenzio
static uint8_t  resetPerSilenzio      = 0;   // reset di fila senza che il nodo si sia fatto vivo
static uint32_t sonnoNodoSec          = SONNO_NODO_DEF_SEC;

// ============================ WATCHDOG ======================================

static void wdtImposta(uint32_t secondi) {
#if ESP_ARDUINO_VERSION >= ESP_ARDUINO_VERSION_VAL(3, 0, 0)
  esp_task_wdt_config_t cfg = {};
  cfg.timeout_ms     = secondi * 1000UL;
  cfg.idle_core_mask = 0;
  cfg.trigger_panic  = true;
  // Si prova PRIMA a riconfigurare e solo dopo a inizializzare.
  // Nel core ESP32 3.x il TWDT e' gia' avviato dal framework, quindi init()
  // per primo fallisce sempre e stampa un "E (...) task_wdt: TWDT already
  // initialized" rosso nel log di avvio: sembra un guasto grave e invece e'
  // rumore. Correzione gia' applicata al nodo in watchdog.h; qui il ponte
  // aveva la sua copia locale ed era rimasta indietro.
  esp_err_t e = esp_task_wdt_reconfigure(&cfg);
  if (e == ESP_ERR_INVALID_STATE) e = esp_task_wdt_init(&cfg);
  if (e != ESP_OK) Serial.printf("[WDT] Configurazione fallita (err=%d)\n", (int)e);
#else
  esp_task_wdt_init(secondi, true);
#endif
  // Anche qui: iscrivere un task gia' iscritto stampa un altro errore rosso.
  if (esp_task_wdt_status(NULL) != ESP_OK) esp_task_wdt_add(NULL);
}

// ============================ WIFI ==========================================

/*
 * Scansione delle reti visibili, stampata all'avvio.
 *
 * Serve a scegliere l'access point guardando i numeri invece che a intuito:
 * il segnale va misurato DALLA POSIZIONE DEL PONTE, non da dove sei tu col
 * telefono. Mostra anche se la rete configurata e' effettivamente visibile,
 * il che smaschera subito i due errori piu' comuni: SSID scritto male e rete
 * a 5 GHz, che l'ESP32 non puo' vedere perche' ha solo la radio a 2,4 GHz.
 */
#if SCANSIONE_WIFI_AVVIO
static void wifiScansione() {
  Serial.println(F("[WiFi] Scansione delle reti visibili da qui..."));
  int n = WiFi.scanNetworks();

  if (n <= 0) {
    Serial.println(F("[WiFi] Nessuna rete trovata."));
    return;
  }

  bool trovataLaNostra = false;
  Serial.println(F("       RSSI  canale  SSID"));
  for (int i = 0; i < n && i < 12; i++) {
    bool nostra = (WiFi.SSID(i) == WIFI_SSID);
    if (nostra) trovataLaNostra = true;
    Serial.printf("      %4d  %6d  %s%s\n", WiFi.RSSI(i), WiFi.channel(i),
                  WiFi.SSID(i).c_str(), nostra ? "   <== configurata" : "");
  }

  if (!trovataLaNostra) {
    Serial.printf("[WiFi] ATTENZIONE: \"%s\" non e' fra le reti visibili.\n", WIFI_SSID);
    Serial.println(F("[WiFi] Controlla il nome (occhio a maiuscole e spazi) e"));
    Serial.println(F("[WiFi] ricorda che l'ESP32 vede SOLO i 2,4 GHz, mai i 5 GHz."));
  }
  WiFi.scanDelete();
}
#endif

static void wifiSetup() {
  WiFi.mode(WIFI_STA);
#if SCANSIONE_WIFI_AVVIO
  wifiScansione();
#endif
  WiFi.setAutoReconnect(true);
  WiFi.persistent(true);
  /*
   * Modem-sleep DISATTIVATO, e non e' un dettaglio.
   *
   * Con il modem-sleep la radio WiFi si spegne a intervalli per risparmiare
   * corrente. Su un dispositivo a batteria ha senso; qui il ponte sta attaccato
   * a un alimentatore USB e il risparmio non serve a nulla, mentre il prezzo e'
   * alto: la connessione TCP verso il broker cade in silenzio ogni tanto, e
   * quando il ponte si riconnette il broker pubblica il Last Will della
   * sessione morta. Risultato in Home Assistant: tutte le entita' della serra
   * diventano "non disponibile" per un secondo e poi tornano, a ripetizione.
   */
  WiFi.setSleep(false);
  WiFi.setHostname(OTA_HOSTNAME);
  WiFi.begin(WIFI_SSID, WIFI_PASS);
  Serial.printf("[WiFi] Connessione a %s ...\n", WIFI_SSID);
}

// Non bloccante: il LoRa deve continuare ad ascoltare anche mentre il WiFi
// e' giu'. Nessuna delle funzioni chiamate qui puo' fermare il loop.
static void wifiMantieni() {
  if (WiFi.status() == WL_CONNECTED) {
    if (wifiGiuDa != 0) {
      // Stesso ragionamento del contatore MQTT: all'avvio il WiFi risulta
      // "giu'" per i primi secondi, prima ancora di essersi mai collegato.
      // Quell'aggancio iniziale non e' una riconnessione.
      static bool primoAggancio = true;
      if (primoAggancio) primoAggancio = false;
      else               riconnessioniWifi++;

      int rssi = WiFi.RSSI();
      Serial.printf("[WiFi] Connesso dopo %lu s: %s (RSSI %d dBm) - riconnessioni: %lu\n",
                    (unsigned long)((millis() - wifiGiuDa) / 1000UL),
                    WiFi.localIP().toString().c_str(), rssi,
                    (unsigned long)riconnessioniWifi);

      // Segnalato all'avvio invece di lasciarlo scoprire dai sintomi: sotto
      // questa soglia le cadute di connessione sono attese, non un guasto.
      if (rssi < WIFI_RSSI_DEBOLE)
        Serial.printf("[WiFi] ATTENZIONE: %d dBm e' un segnale debole. Aspettati "
                      "riconnessioni: avvicina il ponte o cambia access point.\n", rssi);

      wifiGiuDa = 0;
    }
    return;
  }

  if (wifiGiuDa == 0) wifiGiuDa = millis();

  /*
   * Riavvio SOLO se il WiFi resta giu' a lungo, non piu' a intervalli fissi.
   * La versione precedente faceva ESP.restart() ogni ora a prescindere:
   * durante i secondi di riavvio la radio non ascolta, e con il nodo che
   * trasmette ogni 15 minuti c'era una probabilita' concreta di perdere
   * proprio quel pacchetto.
   */
  if (millis() - wifiGiuDa > REBOOT_WIFI_DOWN_MS) {
    Serial.println(F("[WiFi] Giu' da troppo tempo: riavvio il ponte."));
    delay(500);
    ESP.restart();
  }

  if (millis() - ultimoTentativoWifi < WIFI_RETRY_MS) return;
  ultimoTentativoWifi = millis();

  Serial.println(F("[WiFi] Disconnesso, ritento..."));
  WiFi.disconnect();
  WiFi.begin(WIFI_SSID, WIFI_PASS);
}

// ============================ ORA (NTP) =====================================

// L'ora del ponte viaggia su ogni ACK ed e' quella con cui la serra corregge
// il proprio DS1307: e' l'unico orologio affidabile del sistema.
static uint32_t oraCorrente() {
  time_t adesso = time(nullptr);
  return (adesso > 1700000000L) ? (uint32_t)adesso : 0;
}

/*
 * Scarto in secondi fra l'ora civile e UTC in questo istante: +7200 con l'ora
 * legale, +3600 con quella solare.
 *
 * Serve perche' time() restituisce UTC e il nodo scrive quel valore tale e
 * quale nel DS1307, per poi confrontare rtc.now().hour() con l'orario
 * programmato da Home Assistant. Senza questo campo "irriga alle 6:00"
 * significava le 6:00 UTC, cioe' le 8:00 italiane d'estate e le 7:00
 * d'inverno: l'acqua arrivava ogni giorno due ore dopo il previsto.
 *
 * Le regole dell'ora legale stanno solo qui, dentro NTP_TZ, ed e' giusto che
 * ci restino: il nodo non ha ne' modo ne' motivo di conoscerle, gli basta il
 * numero che il ponte gli passa a ogni ACK.
 *
 * Il calcolo NON usa tm_gmtoff: e' un'estensione che newlib espone solo con
 * certe combinazioni di macro di visibilita', e una compilazione che oggi
 * funziona potrebbe smettere di farlo al prossimo aggiornamento del core.
 * Confrontare le due rappresentazioni dello stesso istante e' equivalente e
 * non dipende da nulla.
 */
static int32_t offsetFuso() {
  time_t adesso = time(nullptr);
  if (adesso < 1700000000L) return 0;

  struct tm loc, utc;
  localtime_r(&adesso, &loc);
  gmtime_r   (&adesso, &utc);

  int32_t scarto = (int32_t)(loc.tm_hour - utc.tm_hour) * 3600L
                 + (int32_t)(loc.tm_min  - utc.tm_min ) * 60L
                 + (int32_t)(loc.tm_sec  - utc.tm_sec );

  // Le due date possono cadere a cavallo della mezzanotte: in quel caso la
  // sola differenza oraria e' sbagliata di un giorno intero. Lo scarto fra i
  // giorni dell'anno vale +-1 in condizioni normali e +-364/365 a Capodanno,
  // quando l'anno cambia sotto i piedi al confronto.
  int giorni = loc.tm_yday - utc.tm_yday;
  if (giorni ==  1 || giorni < -1) scarto += 86400L;
  if (giorni == -1 || giorni >  1) scarto -= 86400L;

  return scarto;
}

// ============================ MQTT ==========================================

static void mqttCallback(char* topic, byte* payload, unsigned int len) {
  // L'eco non e' un comando: va riconosciuta prima di tutto il resto.
  if (strcmp(topic, TOPIC_ECO) == 0) {
    size_t atteso = strlen(ecoAtteso);
    if (atteso > 0 && len == atteso && memcmp(payload, ecoAtteso, len) == 0)
      ecoTornato = true;
    return;
  }
  codaMessaggioMqtt(topic, payload, len);
}

static void mqttMantieni() {
  if (WiFi.status() != WL_CONNECTED) return;

  static bool eraConnesso = false;
  if (mqtt.connected()) { eraConnesso = true; return; }

  // Passaggio da connesso a caduto: e' l'unico istante in cui mqtt.state()
  // contiene ancora il motivo, prima che il tentativo di riconnessione lo
  // sovrascriva con il proprio esito.
  if (eraConnesso) {
    eraConnesso       = false;
    statoUltimaCaduta = mqtt.state();
    rssiUltimaCaduta  = WiFi.RSSI();
    Serial.printf("[MQTT] Connessione caduta (stato=%d, RSSI %d dBm, "
                  "uptime %lu s).\n",
                  statoUltimaCaduta, rssiUltimaCaduta,
                  (unsigned long)(millis() / 1000UL));
  }

  if (millis() - ultimoTentativoMqtt < MQTT_RETRY_MS) return;
  ultimoTentativoMqtt = millis();

  Serial.print(F("[MQTT] Connessione al broker... "));

  // Last Will: se il ponte muore, Home Assistant segna subito le entita'
  // come non disponibili invece di mostrare valori vecchi come se fossero attuali.
  if (mqtt.connect(MQTT_CLIENT_ID, MQTT_USER, MQTT_PASS,
                   TOPIC_PONTE, 1, true, "offline")) {
    // La PRIMA connessione non e' una riconnessione: contarla farebbe
    // sembrare instabile un ponte appena avviato che invece sta benissimo.
    // Questi contatori servono a rispondere a "sta reggendo?", quindi devono
    // partire da zero e restarci finche' non succede davvero qualcosa.
    static bool primaConnessione = true;
    if (primaConnessione) primaConnessione = false;
    else                  riconnessioniMqtt++;

    Serial.printf("OK! (riconnessioni finora: %lu, uptime %lu s)\n",
                  (unsigned long)riconnessioniMqtt,
                  (unsigned long)(millis() / 1000UL));

    /*
     * Algoritmo di Nagle disattivato, e va rifatto a OGNI connessione
     * perche' il socket e' nuovo ogni volta.
     *
     * Nagle trattiene i pacchetti piccoli finche' i dati precedenti non
     * sono stati confermati, per non sprecare rete con tanti invii minuscoli.
     * Il PINGREQ di MQTT e' lungo DUE byte, ed e' esattamente il pacchetto
     * che Nagle ama trattenere. Se la conferma TCP di una pubblicazione
     * tarda -- e con il WiFi tarda spesso, perche' anche dall'altra parte
     * c'e' un ritardo volontario sulle conferme -- il ping resta fermo nel
     * buffer di uscita. Il broker non riceve piu' niente, e dopo una volta e
     * mezza il keepalive chiude la sessione: nel suo log si legge
     * "exceeded timeout", che sembra un ponte morto e invece e' un ponte
     * vivissimo con due byte in ostaggio.
     *
     * Qui non c'e' niente da risparmiare: i messaggi sono pochi e radi.
     */
    espClient.setNoDelay(true);

    mqtt.publish(TOPIC_PONTE, "online", true);
    // Sessione pulita: le sottoscrizioni vanno rifatte a ogni connessione,
    // compresa quella dell'eco, senza la quale nessun ACK partirebbe piu'.
    mqtt.subscribe(TOPIC_ECO, 0);
    mqtt.subscribe(TOPIC_CMD_SUB, 1);
    // Subito dopo la sottoscrizione il broker riversa i messaggi ritenuti:
    // i comandi di azione che arrivano adesso sono residui, non richieste.
    codaSegnalaSottoscrizione();

    /*
     * La discovery NON si ripubblica a ogni riconnessione.
     *
     * Sono tredici messaggi ritenuti da ~400 byte: una raffica di 5 KB spinta
     * nel socket alla massima velocita'. Su un WiFi debole basta a far cadere
     * la connessione appena stabilita, il che provoca una riconnessione, che
     * rilancia la raffica. Nel log del ponte si vedeva nitidamente:
     * connessione riuscita, tredici pubblicazioni, caduta dopo cinque secondi,
     * e tutto da capo.
     *
     * Ripubblicare ogni volta era comunque inutile: quei messaggi sono
     * RITENUTI, quindi e' il broker a conservarli. Serve farlo al primo avvio
     * e, per sicurezza, ogni tanto, nel caso il broker sia stato reinstallato.
     */
    uint32_t adessoMs = millis();
    bool servePubblicare = (ultimaDiscovery == 0) ||
                           (adessoMs - ultimaDiscovery > DISCOVERY_RIPUBBLICA_MS);

    if (servePubblicare) {
      discoveryReset();
      if (discoveryPubblicaComandi() && discoveryPubblicaPonte())
        ultimaDiscovery = adessoMs ? adessoMs : 1;   // 0 e' riservato a "mai"
      else
        Serial.println(F("[HA] Discovery interrotta: riprovo alla prossima connessione."));
    } else {
      Serial.printf("[HA] Discovery gia' pubblicata %lu min fa: la salto.\n",
                    (unsigned long)((adessoMs - ultimaDiscovery) / 60000UL));
    }

    codaPubblicaPending();
  } else {
    Serial.printf("fallita (rc=%d), riprovo tra %lu s.\n",
                  mqtt.state(), MQTT_RETRY_MS / 1000UL);
  }
}

/*
 * Conferma che il broker ha davvero ricevuto quello che gli abbiamo appena
 * pubblicato.
 *
 * mqtt.publish() con QoS 0 restituisce true appena i byte entrano nel buffer
 * TCP dell'ESP32, non quando arrivano al broker. Se in quel momento il
 * collegamento e' in stallo -- e succede 14-22 volte al giorno -- il ponte
 * mandava lo stesso l'ACK, il nodo cancellava il dato, e il broker poco dopo
 * chiudeva la sessione con i byte ancora in viaggio. Dal 13/09, 12 cicli persi
 * su 15 sono caduti esattamente dentro uno di questi stalli, e nessuno era
 * finito nel backlog perche' il nodo l'ACK l'aveva ricevuto.
 *
 * Il rimedio e' un'eco: dopo i dati si pubblica un gettone su un topic a cui
 * il ponte stesso e' iscritto, e si aspetta di vederlo tornare. Viaggia sulla
 * stessa connessione TCP DOPO i dati, e il broker elabora i messaggi di un
 * client nell'ordine in cui arrivano: se ha rimandato indietro l'eco, i dati
 * li ha gia' ricevuti e consegnati. Se l'eco non torna entro ECO_TIMEOUT_MS
 * niente ACK: il nodo ritrasmette o mette il pacchetto nel backlog.
 *
 * Non serve cambiare libreria ne' passare a QoS 1, che PubSubClient in
 * pubblicazione non supporta.
 */
static bool confermaDalBroker(uint32_t seq) {
  snprintf(ecoAtteso, sizeof(ecoAtteso), "%lu-%lu",
           (unsigned long)seq, (unsigned long)millis());
  ecoTornato = false;

  if (!mqtt.publish(TOPIC_ECO, ecoAtteso)) return false;

  const uint32_t t0 = millis();
  while (!ecoTornato && millis() - t0 < ECO_TIMEOUT_MS) {
    esp_task_wdt_reset();
    if (!mqtt.loop()) break;      // la connessione e' caduta mentre aspettavamo
    delay(1);
  }

  if (ecoTornato) ultimaEcoMs = millis() - t0;
  ecoAtteso[0] = '\0';            // un'eco che arriva dopo non conferma nulla
  return ecoTornato;
}

// ============================ DEDUP =========================================

static bool giaVisto(uint32_t seq, uint32_t ts) {
  for (uint8_t i = 0; i < DEDUP_MEMORIA; i++)
    if (dedup[i].seq == seq && dedup[i].ts == ts) return true;
  return false;
}

static void ricorda(uint32_t seq, uint32_t ts) {
  dedup[dedupIdx].seq = seq;
  dedup[dedupIdx].ts  = ts;
  dedupIdx = (dedupIdx + 1) % DEDUP_MEMORIA;
}

// ============================ JSON ==========================================

// true se la stringa e' un numero valido per intero (e non, per esempio,
// "2.0.0" o "ok", che nel JSON vanno virgolettati).
static bool eNumerico(const char* s) {
  if (!s || !*s) return false;
  char* fine = nullptr;
  strtod(s, &fine);
  return fine && *fine == '\0';
}

/*
 * Converte il pacchetto in JSON copiando OGNI coppia chiave=valore cosi'
 * com'e'. E' qui che si vede il vantaggio del protocollo v2: il ponte non ha
 * bisogno di sapere quali sensori esistono, quindi aggiungerne uno alla serra
 * non richiede di riflashare anche lui.
 */
static size_t costruisciJson(const PacchettoKV& pkt, char* out, size_t maxOut,
                             int rssi, float snr) {
  /*
   * La coda del JSON viene preparata PRIMA e il suo spazio riservato per tutto
   * il ciclo. Non e' pignoleria: se il buffer si riempisse con i campi, la
   * graffa di chiusura verrebbe troncata e Home Assistant scarterebbe l'intero
   * pacchetto come JSON non valido — tutti i sensori fermi, senza un errore
   * che spieghi perche'. Meglio perdere qualche campo che l'intero messaggio.
   */
  char coda[96];
  int  lCoda = snprintf(coda, sizeof(coda),
                        ",\"rssi\":%d,\"snr\":%.1f,\"ts_ponte\":%lu}",
                        rssi, snr, (unsigned long)oraCorrente());
  if (lCoda < 0 || (size_t)lCoda >= sizeof(coda) || maxOut < (size_t)lCoda + 4) {
    out[0] = '\0';
    return 0;
  }

  size_t pos = 0;
  out[pos++] = '{';
  out[pos]   = '\0';

  bool primo = true, tagliato = false;
  char campo[PROTO_LEN_CHIAVE + PROTO_LEN_VALORE + 8];

  for (uint8_t i = 0; i < pkt.n(); i++) {
    const CampoKV& c = pkt.campo(i);

    int l = eNumerico(c.valore)
          ? snprintf(campo, sizeof(campo), "%s\"%s\":%s",
                     primo ? "" : ",", c.chiave, c.valore)
          : snprintf(campo, sizeof(campo), "%s\"%s\":\"%s\"",
                     primo ? "" : ",", c.chiave, c.valore);
    if (l < 0 || (size_t)l >= sizeof(campo)) continue;   // campo anomalo: saltato

    // Il campo ci sta solo se dopo di lui ci sta ancora tutta la coda.
    if (pos + (size_t)l + (size_t)lCoda + 1 > maxOut) { tagliato = true; break; }

    memcpy(out + pos, campo, (size_t)l);
    pos += (size_t)l;
    out[pos] = '\0';
    primo = false;
  }

  // Se non e' entrato nessun campo va tolta la virgola iniziale della coda,
  // o verrebbe fuori {,"rssi":...} che non e' JSON valido.
  const char* codaDa  = primo ? coda + 1 : coda;
  size_t      codaLen = primo ? (size_t)lCoda - 1 : (size_t)lCoda;

  memcpy(out + pos, codaDa, codaLen);
  pos += codaLen;
  out[pos] = '\0';

  if (tagliato)
    Serial.printf("[MQTT] ATTENZIONE: JSON oltre i %u byte, alcuni campi omessi. "
                  "Alza la dimensione del buffer in gestisciLoRa().\n", (unsigned)maxOut);

  return pos;
}

// ============================ LORA ==========================================

/*
 * Il nodo si e' fatto vivo con un pacchetto leggibile: la radio funziona.
 * Anche un duplicato o un record arretrato vale, il rumore no: da sorda la
 * radio del ponte continuava a consegnare ogni tanto qualche pacchetto di
 * rumore, e non deve bastare a sembrare sana.
 */
static void segnaNodoVivo(const PacchettoKV& pkt) {
  ultimoDalNodoMs = riferimentoSilenzioMs = millis();
  resetPerSilenzio = 0;

  // L'attesa si regola sulla durata del sonno che il nodo dichiara, cosi'
  // allungandolo da Home Assistant non si scambia il sonno per un guasto.
  uint32_t slp = pkt.valoreU("slp", 0);
  if (slp >= 60 && slp <= 3600) sonnoNodoSec = slp;
}

/*
 * Riparazione per silenzio: il nodo non si sente da SILENZIO_CICLI risvegli.
 *
 * E' la rete di sicurezza per tutto quello che la verifica dei registri non
 * vede. Fino alla 2.4.0 questo caso aspettava che qualcuno riflashasse il
 * ponte: il 9/10 la radio e' rimasta sorda 35 ore, l'11/10 53.
 */
static void sorvegliaSilenzio() {
  uint32_t attesa = (SILENZIO_CICLI * sonnoNodoSec + SILENZIO_MARGINE_SEC) * 1000UL;
  attesa <<= (resetPerSilenzio < 3 ? resetPerSilenzio : 3);

  if (millis() - riferimentoSilenzioMs < attesa) return;
  riferimentoSilenzioMs = millis();
  resetPerSilenzio++;

  char det[48];
  snprintf(det, sizeof(det), "nessun pacchetto del nodo da %lu min",
           (unsigned long)((millis() - ultimoDalNodoMs) / 60000UL));
  radioRipara(RIP_SILENZIO, det);
}

/*
 * Un ACK e' partito per questo pacchetto: se ora ne arriva un duplicato,
 * il nodo quell'ACK non l'ha sentito (vedi controllaAckPerso()).
 */
static void ricordaAckInviato(uint32_t seq, uint32_t ts) {
  // Il pacchetto confermato prima non e' tornato indietro: il suo ACK e'
  // arrivato, e la serie dei cicli con ACK persi si interrompe.
  if (ackInviatoValido && !ackInviatoTornato) cicliAckPersi = 0;

  ackInviatoValido  = true;
  ackInviatoSeq     = seq;
  ackInviatoTs      = ts;
  ackInviatoTornato = false;
}

/*
 * Il nodo ha ritrasmesso un pacchetto che avevamo gia' confermato.
 *
 * Una volta ogni tanto e' normale: un disturbo, una collisione. Per
 * ACK_PERSI_CICLI cicli di fila no. Dal 13 al 20/10 il ponte ha ricevuto
 * ogni pacchetto e risposto a ognuno, e il nodo non ha mai sentito una sola
 * risposta: tre tentativi a ciclo, backlog salito fino a 344 record, e
 * nessuna misura della radio del ponte lo poteva vedere. Lo vede solo chi
 * guarda cosa succede dopo l'ACK.
 *
 * Si conta un ciclo per pacchetto, non per ritrasmissione, e si ripara PRIMA
 * di rispondere: l'ACK di questo stesso duplicato parte gia' dalla radio
 * rimessa in sesto.
 */
static void controllaAckPerso(uint32_t seq, uint32_t ts) {
  if (!ackInviatoValido || seq != ackInviatoSeq || ts != ackInviatoTs) return;

  ackPersi++;
  if (ackInviatoTornato) return;
  ackInviatoTornato = true;

  if (++cicliAckPersi < ACK_PERSI_CICLI) return;
  cicliAckPersi = 0;

  char det[48];
  snprintf(det, sizeof(det), "%u cicli di fila con l'ACK non sentito",
           (unsigned)ACK_PERSI_CICLI);
  radioRipara(RIP_ACK_PERSI, det);
}

/*
 * Costruisce e invia l'ACK. E' il messaggio piu' importante del sistema:
 *   - conferma al nodo che il dato e' arrivato fino al broker
 *   - porta l'ora corrente, con cui la serra corregge il proprio orologio
 *   - porta l'eventuale comando da eseguire
 * Tutto questo senza un solo pacchetto in piu' rispetto a prima.
 *
 * seq, ts       : identificano il pacchetto confermato
 * allegaComando : si puo' estrarre un comando nuovo dalla coda
 * ripeti        : comando gia' consegnato da riallegare (ritrasmissione dello
 *                 stesso pacchetto), oppure nullptr
 *
 * Ritorna false se l'ACK non e' partito.
 */
static bool inviaAck(uint32_t seq, uint32_t ts, bool allegaComando,
                     const ComandoInCoda* ripeti = nullptr) {
  // Con la radio inservibile non si estrae nessun comando dalla coda: uscito
  // per un ACK che non puo' partire, sarebbe perso.
  if (!radioOk()) {
    Serial.println(F("[LoRa] Radio non disponibile: ACK non inviato."));
    return false;
  }

  char ack[PROTO_MAX_PAYLOAD + 1];

  /*
   * snprintf ritorna quanti caratteri AVREBBE scritto, non quanti ne ha
   * scritti davvero. Accumulando quel valore senza limitarlo, "pos" puo'
   * superare la dimensione del buffer e la sottrazione successiva va in
   * underflow (sono size_t), passando a snprintf una dimensione enorme.
   * Da qui in poi si scriverebbe oltre il buffer. Questa lambda tiene "pos"
   * dentro i limiti qualunque cosa succeda.
   */
  size_t pos = 0;
  auto accoda = [&](const char* fmt, auto... args) {
    if (pos >= sizeof(ack) - 1) return;
    int n = snprintf(ack + pos, sizeof(ack) - pos, fmt, args...);
    if (n < 0) return;
    pos = (size_t)n >= sizeof(ack) - pos ? sizeof(ack) - 1 : pos + (size_t)n;
  };

  accoda("%s;s=%lu", PROTO_PREFIX_ACK, (unsigned long)seq);

  uint32_t adesso = oraCorrente();
  if (adesso > 0) {
    accoda(";now=%lu", (unsigned long)adesso);
    accoda(";tz=%ld",  (long)offsetFuso());
  }

  if (ripeti) {
    accoda(";c=%lu;o=%s;a=%s", (unsigned long)ripeti->id, ripeti->opcode, ripeti->args);
    Serial.printf("[CMD] Riallego id=%lu %s: l'ACK che lo portava non era arrivato.\n",
                  (unsigned long)ripeti->id, ripeti->opcode);
  } else if (allegaComando && !codaVuota()) {
    ComandoInCoda cmd;
    if (codaEstrai(cmd)) {
      accoda(";c=%lu;o=%s;a=%s", (unsigned long)cmd.id, cmd.opcode, cmd.args);
      comandiConsegnati++;
      ackCmd       = cmd;
      ackCmdValido = true;
      ackCmdSeq    = seq;
      ackCmdTs     = ts;
      ackCmdMs     = millis();
    }
  }

  if (!radioTrasmetti(ack)) {
    // La radio e' gia' stata resettata. Il nodo, senza ACK, ritrasmettera':
    // se c'era un comando, gli verra' riallegato come per un ACK perso.
    Serial.printf("[LoRa] ACK NON partito: %s\n", ack);
    return false;
  }

  Serial.printf("[LoRa] ACK -> %s\n", ack);
  return true;
}

static void gestisciLoRa() {
  // Una sola lettura SPI quando non e' arrivato niente: la radio e' in
  // ricezione continua e non va riarmata (vedi radio.h).
  char buf[PROTO_MAX_PAYLOAD + 1];
  int  n = radioRicevi(buf, sizeof(buf), ultimoRssi, ultimoSnr);
  if (n <= 0) return;

  pacchettiRicevuti++;

  Serial.printf("\n[LoRa] #%lu (RSSI %d dBm, SNR %.1f dB, %d byte): %s\n",
                (unsigned long)pacchettiRicevuti, ultimoRssi, ultimoSnr, n, buf);

  // --- Parsing: v2 (chiave=valore) oppure v1 (CSV posizionale) -------------
  // Il supporto al v1 serve durante l'aggiornamento: sulla microSD del nodo
  // possono esserci record accodati dalla versione precedente del firmware.
  char        prefisso[12] = {0};
  PacchettoKV pkt;
  bool        ok;

  if (protoEV2(buf)) ok = pkt.parse(buf, prefisso, sizeof(prefisso));
  else               ok = protoParseV1(buf, pkt, prefisso, sizeof(prefisso));

  if (!ok || strcmp(prefisso, "GH1") != 0) {
    Serial.println(F("[LoRa] Pacchetto non riconosciuto, ignorato."));
    pacchettiScartati++;
    return;
  }

  segnaNodoVivo(pkt);

  uint32_t seq = pkt.valoreU("s", 0);
  uint32_t ts  = pkt.valoreU("t", 0);

  // --- Duplicato? Si conferma comunque, ma non si ripubblica ---------------
  // Il dato e' gia' arrivato al broker (ricorda() scatta solo dopo l'eco):
  // si e' perso l'ACK. Se quell'ACK portava un comando, glielo si riallega.
  if (giaVisto(seq, ts)) {
    Serial.println(F("[LoRa] Duplicato (ACK perso in precedenza): confermo senza ripubblicare."));
    controllaAckPerso(seq, ts);
    bool stessoPacchetto = ackCmdValido && seq == ackCmdSeq && ts == ackCmdTs &&
                           (millis() - ackCmdMs) < ACK_RIPETIBILE_MS;
    inviaAck(seq, ts, false, stessoPacchetto ? &ackCmd : nullptr);
    return;
  }

  // --- Fresco o storico? ---------------------------------------------------
  // Un record ripescato dal backlog non deve finire su serra/nodo/stato:
  // il nodo trasmette prima il pacchetto attuale e poi la coda arretrata,
  // quindi Home Assistant finirebbe per mostrare come "valore corrente" una
  // lettura vecchia. Dal firmware 2.5.0 il nodo marca quei record con bk=1;
  // per quelli dei firmware precedenti valgono l'eta' e il confronto con
  // l'ultimo pacchetto fresco (vedi config.h).
  // ts == 0 significa che il nodo non conosce ancora l'ora: e' un pacchetto
  // fresco, e anzi ha bisogno del "now" nell'ACK.
  uint32_t adesso = oraCorrente();
  bool storico = pkt.ha("bk") ||
                 ((ts > 0) && (adesso > 0) && (adesso > ts) &&
                  ((adesso - ts) > SOGLIA_STORICO_SEC)) ||
                 ((ts > 0) && (ultimoTsFresco > 0) &&
                  (ts + STORICO_MARGINE_SEC < ultimoTsFresco));

  const char* topic = storico ? TOPIC_STORICO : TOPIC_STATO;

  /*
   * 900 byte e non 640: un pacchetto LoRa pieno (250 byte, fino a 28 campi)
   * espanso in JSON con virgolette e nomi di chiave puo' superare
   * abbondantemente i 640, e il buffer precedente era piu' piccolo di quello
   * che il protocollo stesso permette di ricevere.
   */
  char json[900];
  costruisciJson(pkt, json, sizeof(json), ultimoRssi, ultimoSnr);
  Serial.printf("[MQTT] %s <- %s\n", topic, json);

  // Retained solo per lo stato attuale: dopo un riavvio di Home Assistant i
  // sensori hanno subito un valore invece di restare vuoti fino al risveglio
  // successivo del nodo (fino a 15 minuti di buco).
  bool pubblicato = mqtt.connected() &&
                    mqtt.publish(topic, (const uint8_t*)json, strlen(json), !storico);

  if (!pubblicato) {
    // Niente ACK: la serra conserva il dato su microSD e lo rimandera'.
    // E' cosi' che la catena "nessun dato perso" resta intatta.
    Serial.println(F("[MQTT] Pubblicazione fallita: NIENTE ACK, la serra terra' il dato su SD."));
    return;
  }

  // --- Esito di un comando eseguito dal nodo -------------------------------
  // Prima dell'eco, cosi' l'eco conferma anche lui.
  if (pkt.ha("res")) {
    const char* det = pkt.valore("det");
    codaPubblicaEsito(pkt.valoreU("res", 0), pkt.valoreU("rc", 0), det ? det : "");
  }

  // --- Il broker ha ricevuto davvero? --------------------------------------
  if (!confermaDalBroker(seq)) {
    ecoMancate++;
    Serial.printf("[MQTT] Eco non tornata entro %lu ms: NIENTE ACK, il nodo "
                  "ritrasmettera' o terra' il dato su SD (eco mancate: %lu).\n",
                  (unsigned long)ECO_TIMEOUT_MS, (unsigned long)ecoMancate);
    return;
  }

  // Solo adesso il pacchetto e' consegnato: una sua ritrasmissione e' un
  // duplicato da non ripubblicare.
  ricorda(seq, ts);
  if (storico) recordStorici++;

  // Riferimento per riconoscere i record arretrati che seguiranno, solo se
  // il timestamp e' credibile rispetto all'ora NTP del ponte.
  if (!storico && ts > ultimoTsFresco && adesso > 0 &&
      (ts > adesso ? ts - adesso : adesso - ts) <= STORICO_PLAUSIBILE_SEC)
    ultimoTsFresco = ts;

  // --- ACK, con eventuale comando ------------------------------------------
  // Ai record storici NON si allegano comandi: il nodo li invia con una
  // funzione che non li interpreta, quindi il comando andrebbe perso.
  if (inviaAck(seq, ts, !storico)) ricordaAckInviato(seq, ts);

  // --- Discovery: crea le entita' mancanti, anche per chiavi sconosciute ---
  // DOPO l'ACK: al primo pacchetto dopo l'avvio sono una decina di messaggi
  // da ~400 byte, e fatti prima avrebbero ritardato sia l'eco sia l'ACK
  // mentre il nodo aspetta, con la radio accesa, per al massimo 2 s.
  for (uint8_t i = 0; i < pkt.n(); i++)
    discoveryAssicuraSensore(pkt.campo(i).chiave);

  /*
   * rssi e snr vanno annunciati a parte, ed e' un errore che e' costato due
   * entita' mai nate: non arrivano dal nodo, li aggiunge il ponte in fondo al
   * JSON. Il ciclo qui sopra scorre i campi del PACCHETTO, dove quei due non
   * compaiono, quindi la loro discovery non veniva pubblicata mai — pur
   * essendo regolarmente presenti nella tabella e usati dalle dashboard.
   */
  discoveryAssicuraSensore("rssi");
  discoveryAssicuraSensore("snr");
}

// ============================ DIAGNOSTICA ===================================

static void pubblicaDiagnostica() {
  if (!mqtt.connected()) return;
  if (millis() - ultimaDiagnostica < DIAG_INTERVALLO_MS) return;
  ultimaDiagnostica = millis();

  // 768 byte: con i campi della radio, e ogni campo alla sua lunghezza
  // massima teorica (contatori a 4294967295, interi con segno a -2147483648,
  // testi della radio a 47 caratteri), il JSON arriva a 704. Chi aggiunge un
  // campo deve rifare il conto: snprintf troncherebbe la graffa finale e Home
  // Assistant scarterebbe tutto.
  char payload[768];
  snprintf(payload, sizeof(payload),
    "{\"uptime\":%lu,\"pkt\":%lu,\"scartati\":%lu,\"cmd_consegnati\":%lu,"
    "\"riconn_wifi\":%lu,\"riconn_mqtt\":%lu,"
    "\"coda\":%u,\"wifi_rssi\":%d,\"heap\":%lu,"
    "\"heap_blocco\":%lu,\"heap_minimo\":%lu,"
    "\"lora_rssi\":%d,\"lora_snr\":%.1f,"
    "\"mqtt_caduta\":%d,\"rssi_caduta\":%d,"
    "\"eco_ko\":%lu,\"eco_ms\":%lu,"
    "\"radio_ok\":%d,\"radio_rip\":%lu,\"radio_causa\":\"%s\",\"radio_det\":\"%s\","
    "\"radio_avv\":\"%s\",\"radio_falliti\":%lu,\"rst_hw\":%d,"
    "\"ack_persi\":%lu,\"spi_inc\":%lu,\"crc_ko\":%lu,\"storici\":%lu,"
    "\"ip\":\"%s\",\"fw\":\"%s\"}",
    (unsigned long)(millis() / 1000UL),
    (unsigned long)pacchettiRicevuti, (unsigned long)pacchettiScartati,
    (unsigned long)comandiConsegnati,
    (unsigned long)riconnessioniWifi, (unsigned long)riconnessioniMqtt,
    codaConta(),
    WiFi.RSSI(), (unsigned long)ESP.getFreeHeap(),
    /*
     * heap_blocco e heap_minimo servono a rispondere alla domanda che la sola
     * memoria libera NON risolve: la heap si sta frammentando?
     *
     * Un uso intenso di String alloca e libera blocchi di dimensioni sempre
     * diverse, lasciando buchi. Dopo settimane il totale libero puo' restare
     * identico mentre il piu' grande blocco CONTIGUO si rimpicciolisce, finche'
     * un'allocazione fallisce e il dispositivo si riavvia. Guardando solo la
     * memoria libera non si vede arrivare nulla.
     *
     *   heap_blocco  = il piu' grande blocco allocabile in questo momento.
     *                  Se cala giorno dopo giorno mentre "heap" resta stabile,
     *                  quella e' frammentazione.
     *   heap_minimo  = il minimo storico di memoria libera dall'avvio, utile a
     *                  sapere quanto margine c'e' stato davvero nei picchi.
     */
    (unsigned long)ESP.getMaxAllocHeap(),
    (unsigned long)ESP.getMinFreeHeap(),
    ultimoRssi, ultimoSnr,
    statoUltimaCaduta, rssiUltimaCaduta,
    // eco_ko: pacchetti del nodo rimasti senza ACK perche' il broker non ha
    // confermato in tempo. La 2.3.0 li avrebbe confermati al buio, senza
    // sapere se arrivavano: ora il nodo li ritrasmette o li tiene su SD.
    (unsigned long)ecoMancate, (unsigned long)ultimaEcoMs,
    /*
     * La radio (vedi radio.h):
     *   radio_rip    reset fatti per rimetterla in sesto dall'avvio; zero e'
     *                il caso normale. radio_causa e radio_det dicono perche'
     *                l'ultimo, compreso il registro trovato alterato
     *   radio_ok     0 se la radio non sta ascoltando: il ponte riprova
     *                ad avviarla ogni RADIO_RIPROVA_MS
     *   radio_avv    perche' non parte ("il modulo non risponde", "la radio
     *                resta in sleep"), oppure il primo registro escluso
     *                dalla verifica perche' non torna nemmeno a reset appena
     *                fatto; vuoto di norma
     *   radio_falliti  avvii falliti di fila; zero appena riparte
     *   rst_hw       1 se il filo di reset funziona, 0 se no, -1 non ancora
     *                verificato (lo si sa dal primo riavvio senza staccare
     *                la corrente, per esempio dopo un OTA)
     *   ack_persi    ritrasmissioni di pacchetti gia' confermati, cioe' ACK
     *                che il nodo non ha sentito
     *   spi_inc      letture dei registri smentite dalla rilettura subito
     *                dopo: disturbi sui fili fra ESP32 e modulo
     *   crc_ko       pacchetti arrivati con il CRC sbagliato
     */
    radioOk() ? 1 : 0, (unsigned long)radioRiparazioni(),
    radioCausaTesto(radioUltimaCausa()), radioUltimoDettaglio(),
    radioAvviso(), (unsigned long)radioAvviiFalliti(), (int)radioResetHw(),
    (unsigned long)ackPersi, (unsigned long)radioLettureIncoerenti(),
    (unsigned long)radioCrcErrati(), (unsigned long)recordStorici,
    WiFi.localIP().toString().c_str(), FW_VERSION_PONTE);

  mqtt.publish(TOPIC_DIAG, (const uint8_t*)payload, strlen(payload), true);
}

/*
 * Ogni riparazione della radio finisce anche su serra/ponte/log, ritenuto,
 * con il motivo: e' cosi' che si sapra' cosa e' successo anche quando il
 * recorder di Home Assistant l'avra' dimenticato. Se MQTT e' giu' quando
 * succede, parte appena torna su: a quel punto conta l'ultima, e il totale
 * resta nel contatore.
 */
static void pubblicaEventoRadio() {
  static uint32_t pubblicate = 0;
  const uint32_t n = radioRiparazioni();
  if (n == pubblicate || !mqtt.connected()) return;

  char payload[320];
  snprintf(payload, sizeof(payload),
    "{\"evento\":\"riparazione_radio\",\"n\":%lu,\"causa\":\"%s\",\"det\":\"%s\","
    "\"radio_ok\":%d,\"rst_hw\":%d,\"avviso\":\"%s\",\"uptime\":%lu,\"ts\":%lu,"
    "\"fw\":\"%s\"}",
    (unsigned long)n, radioCausaTesto(radioUltimaCausa()), radioUltimoDettaglio(),
    radioOk() ? 1 : 0, (int)radioResetHw(), radioAvviso(),
    (unsigned long)(millis() / 1000UL), (unsigned long)oraCorrente(), FW_VERSION_PONTE);

  if (mqtt.publish(TOPIC_LOG, (const uint8_t*)payload, strlen(payload), true))
    pubblicate = n;
}

// ============================ SETUP / LOOP ==================================

void setup() {
  Serial.begin(115200);
  delay(100);
  Serial.println();
  Serial.println(F("============================================================"));
  Serial.printf ("  PONTE LoRa <-> MQTT - firmware %s\n", FW_VERSION_PONTE);
  Serial.println(F("============================================================"));

  // --- LoRa: gli stessi identici parametri radio del nodo serra ------------
  // Se il modulo non risponde il ponte NON si riavvia piu' a ripetizione,
  // come fino alla 2.4.0: cosi' restavano spenti anche WiFi, MQTT e OTA, e
  // l'unico modo di aggiornarlo era il cavo. Ora riprova da solo ogni
  // RADIO_RIPROVA_MS, e intanto Home Assistant vede radio_ok a 0.
  if (radioAvvia()) {
    Serial.println(F("[LoRa] In ascolto continuo."));
  } else {
    Serial.printf("[LoRa] ERRORE: radio non pronta (%s).\n", radioAvviso());
    Serial.println(F("[LoRa] Controlla cablaggio SPI, NSS=GPIO5, 3,3 V e ANTENNA montata."));
    Serial.printf("[LoRa] Riprovo da solo ogni %lu s.\n",
                  (unsigned long)(RADIO_RIPROVA_MS / 1000UL));
  }
  if (radioResetHw() == 0)
    Serial.println(F("[LoRa] ATTENZIONE: il reset hardware non ha effetto: controlla "
                     "il filo fra RST del modulo e GPIO 14."));

  wifiSetup();

  configTzTime(NTP_TZ, NTP_SERVER1, NTP_SERVER2);

  mqtt.setServer(MQTT_HOST, MQTT_PORT);
  mqtt.setCallback(mqttCallback);
  // Deve contenere il piu' grande fra: payload di discovery (~400 byte) e
   // JSON di stato (fino a 900), piu' topic e intestazione MQTT.
  mqtt.setBufferSize(1536);
  mqtt.setKeepAlive(MQTT_KEEPALIVE_SEC);   // perche' 60 s: vedi config.h
  mqtt.setSocketTimeout(5);

  discoveryInit(&mqtt);
  codaInit(&mqtt);

#if ABILITA_OTA
  ArduinoOTA.setHostname(OTA_HOSTNAME);
  ArduinoOTA.setPassword(OTA_PASSWORD);
  ArduinoOTA.onStart([]() {
    Serial.println(F("[OTA] Aggiornamento in corso..."));
    esp_task_wdt_delete(NULL);    // l'upload puo' superare il timeout
  });
  ArduinoOTA.begin();
  Serial.printf("[OTA] Attivo come \"%s\".\n", OTA_HOSTNAME);
#endif

  // Watchdog sul loop. Sostituisce il riavvio orario a tappeto: interviene
  // solo quando il ponte e' davvero bloccato, non ogni ora a prescindere.
  wdtImposta(WDT_LOOP_SEC);
}

void loop() {
  esp_task_wdt_reset();

  // Priorita' assoluta: la radio va servita per prima e a ogni giro.
  // Il nodo trasmette per pochi secondi ogni 15 minuti: quella finestra
  // non si puo' perdere.
  gestisciLoRa();

  // ...e va tenuta d'occhio, perche' da sola non dice di essersi guastata.
  radioSorveglia();
  sorvegliaSilenzio();

  wifiMantieni();
  mqttMantieni();
  mqtt.loop();

#if ABILITA_OTA
  ArduinoOTA.handle();
#endif

  pubblicaDiagnostica();
  pubblicaEventoRadio();

  delay(2);                       // un respiro allo stack WiFi
}
