Tressilloide/Serra_smart/Kimi_Agent_Smart Greenhouse ESP32 LoRa/camera_ponte/config.h

/*
 * ============================================================================
 *  SERRA SMART — PONTE IN CAMERA : CONFIGURAZIONE
 * ============================================================================
 *  Le credenziali WiFi e MQTT NON stanno qui: sono in secrets.h, che e'
 *  escluso dal versionamento tramite .gitignore. Copia secrets.h.example in
 *  secrets.h e compilalo con i tuoi dati.
 * ============================================================================
 */

#pragma once

#define FW_VERSION_PONTE "2.6.1"

// ======================= RADIO LoRa =========================================
// DEVONO coincidere esattamente con serra_nodo/config.h, altrimenti i due
// moduli non si sentono nemmeno stando uno accanto all'altro.

#define LORA_BAND   433E6
#define LORA_SF     7
#define LORA_BW     125E3
#define LORA_CR     5

/*
 * Guardia sulla trasmissione dell'ACK, come sul nodo.
 *
 * LoRa.endPacket() attende il flag di TxDone con un ciclo che non ha ne'
 * timeout ne' un modo di nutrire il watchdog. Sul nodo quel ciclo si e'
 * davvero impiantato, piu' volte. Qui il danno sarebbe anche peggiore: il
 * ponte e' l'unico che ascolta, e mentre e' appeso non riceve nulla da
 * nessuno finche' il watchdog non lo riavvia trenta secondi dopo.
 *
 * L'attesa viene limitata a tre volte il tempo di volo calcolato: un ACK
 * di una sessantina di byte vola in 113 ms, quindi la guardia scatta a
 * 439 ms. Nessuna trasmissione onesta ci arriva nemmeno vicino, e dalla
 * 2.5.0 una che non si conclude vuol dire reset della radio (radio.cpp).
 */
#define TX_GUARDIA_X     3        // Fattore di guardia sul tempo di volo
#define TX_GUARDIA_MS    100      // ...piu' questo margine fisso
#define LORA_TX_POWER 17

/*
 * Preambolo e sync word: quelli di fabbrica dell'SX1278, che il nodo usa
 * senza mai impostarli. Il ponte li scrive comunque, come tutti gli altri
 * registri: se il reset hardware non funzionasse, dopo un riavvio software
 * il modulo conserverebbe i valori che aveva prima, qualunque fossero.
 */
#define LORA_PREAMBOLO   8
#define LORA_SYNC_WORD   0x12

/*
 * Bus SPI della radio a 1 MHz, non agli 8 MHz predefiniti della libreria.
 * Il ponte scambia con il modulo pochi byte per pacchetto, e su fili volanti
 * un clock lento e' molto piu' difficile da disturbare: un solo bit
 * sbagliato basta a lasciare la radio sorda per giorni (vedi radio.h).
 */
#define LORA_SPI_HZ      1000000UL

// Ogni quanto rileggere i registri della radio, e se il modulo non risponde
// ogni quanto riprovare ad avviarlo (vedi radio.h)
#define RADIO_VERIFICA_MS  10000UL
#define RADIO_RIPROVA_MS   30000UL

/*
 * Avvio della radio (vedi radioAvvia() in radio.cpp).
 *
 * RADIO_MODO_MS e RADIO_MODO_TENTATIVI: quanto aspettare che il modulo
 * confermi un cambio di modo (un SX1278 sano ci mette meno di un
 * millisecondo) e quante passate sleep -> standby -> ricezione fare prima di
 * dichiarare l'avvio fallito.
 *
 * RADIO_ESCLUSI_MAX: quanti registri di configurazione possono non tornare
 * a reset appena fatto restando un "difetto della tabella" da tollerare. Di
 * piu', e' il modulo che non si legge o non si scrive: avvio fallito, e si
 * riprova ogni RADIO_RIPROVA_MS.
 */
#define RADIO_MODO_MS         50UL
#define RADIO_MODO_TENTATIVI  3
#define RADIO_ESCLUSI_MAX     3

/*
 * Riparazioni per sintomi, quando i registri sembrano a posto ma la radio no
 * (vedi sorvegliaSilenzio() e controllaAckPerso() in camera_ponte.ino).
 *
 * SILENZIO: nessun pacchetto leggibile del nodo per SILENZIO_CICLI risvegli
 * di fila piu' SILENZIO_MARGINE_SEC. Un ciclo perso capita, due di fila
 * quasi mai: il 20/10 la radio e' rimasta sorda per undici ore. Con il sonno
 * di 900 s fa 35 minuti, e la durata del sonno la dice il nodo stesso nel
 * campo slp. Se dopo il reset il nodo resta muto, l'attesa raddoppia a ogni
 * tentativo fino a otto volte: un nodo spento davvero non deve far
 * resettare la radio ogni mezz'ora per giorni.
 *
 * ACK PERSI: il nodo ritrasmette un pacchetto gia' confermato, quindi il
 * nostro ACK non l'ha sentito. Capita, ma per ACK_PERSI_CICLI cicli di fila
 * vuol dire che la nostra trasmissione non arriva: dal 13 al 20/10 e'
 * successo a tutti i cicli, per sei giorni e mezzo.
 */
#define SILENZIO_CICLI         2
#define SILENZIO_MARGINE_SEC   300UL
#define SONNO_NODO_DEF_SEC     900UL    // finche' il nodo non dice il suo
#define ACK_PERSI_CICLI        3

// ======================= MQTT ===============================================

#define MQTT_HOST   "192.168.1.36"     // IP statico del server in garage
#define MQTT_PORT   1883
#define MQTT_CLIENT_ID "serra-ponte"

// --- Topic ---
// Dati freschi. Retained: cosi' dopo un riavvio di Home Assistant i sensori
// hanno subito un valore invece di restare vuoti fino al risveglio successivo
// del nodo (fino a 15 minuti di buco).
#define TOPIC_STATO    "serra/nodo/stato"

// Record recuperati dal backlog della microSD. Vanno su un topic SEPARATO:
// se finissero su TOPIC_STATO, Home Assistant mostrerebbe come "valore
// attuale" una lettura di ore prima, perche' il nodo trasmette il pacchetto
// fresco per primo e la coda storica subito dopo.
#define TOPIC_STORICO  "serra/nodo/storico"

#define TOPIC_PONTE    "serra/ponte/stato"    // online/offline (Last Will)
#define TOPIC_DIAG     "serra/ponte/diag"     // diagnostica del ponte
// Ultima riparazione della radio, con il motivo. Retained: resta leggibile
// anche giorni dopo, quando il recorder di Home Assistant l'ha gia' scordata.
#define TOPIC_LOG      "serra/ponte/log"

/*
 * Eco di conferma: il ponte si iscrive a questo topic e ci pubblica un
 * gettone dopo ogni pacchetto del nodo. L'ACK parte solo quando il gettone
 * torna indietro (vedi confermaDalBroker() in camera_ponte.ino).
 *
 * Se un giorno aggiungi al broker un acl_file, l'utente del ponte deve poter
 * scrivere E leggere questo topic: con l'eco negata nessun pacchetto verrebbe
 * piu' confermato e il nodo metterebbe tutto nel backlog.
 */
#define TOPIC_ECO      "serra/ponte/eco"

// Comandi: Home Assistant pubblica RETAINED su serra/nodo/cmd/<OPCODE>.
// Il broker fa da coda persistente; il ponte cancella il retained quando
// consegna il comando al nodo.
#define TOPIC_CMD_BASE "serra/nodo/cmd"
#define TOPIC_CMD_SUB  "serra/nodo/cmd/+"
#define TOPIC_CMD_RES  "serra/nodo/cmd/res"
#define TOPIC_CMD_PEND "serra/nodo/cmd/pending"

// Prefisso della MQTT Discovery di Home Assistant (cambialo solo se hai
// modificato discovery_prefix nella configurazione dell'integrazione MQTT).
#define HA_DISCOVERY_PREFIX "homeassistant"

// ======================= TIMING =============================================

#define WIFI_RETRY_MS        10000UL    // Intervallo tra i tentativi WiFi

// Stampa all'avvio l'elenco delle reti visibili con il loro segnale, misurato
// dalla posizione del ponte. Costa un paio di secondi al boot e serve a
// scegliere l'access point sui numeri, non a intuito. Mettilo a 0 quando la
// configurazione e' stabile.
#define SCANSIONE_WIFI_AVVIO 1

// Sotto questo valore il collegamento e' fragile e va segnalato all'avvio.
#define WIFI_RSSI_DEBOLE     -78
#define MQTT_RETRY_MS        5000UL     // Intervallo tra i tentativi MQTT
#define DIAG_INTERVALLO_MS   60000UL    // Pubblicazione diagnostica

/*
 * Keepalive MQTT: 60 s, era 30.
 *
 * Con 30 s il broker chiudeva la sessione dopo 45 s senza ricevere nulla, e
 * visto che il ponte manda un ping ogni 30 s bastavano 15-45 s di WiFi
 * disturbato per farla cadere: 14-22 volte al giorno, concentrate fra le 6 e
 * le 7 del mattino e nelle ore di giorno, quasi mai di notte. Le ritrasmissioni
 * TCP, che si distanziano sempre di piu', trasformano pochi secondi di
 * disturbo in un silenzio lungo.
 *
 * Nella 2.3.0 il keepalive NON era stato alzato apposta: piu' lungo voleva
 * dire piu' tempo in cui il ponte confermava al nodo dati che finivano in un
 * socket morto. Con l'eco di conferma quel rischio non c'e' piu' -- senza eco
 * niente ACK, e il dato resta sulla microSD -- quindi ora conviene lasciar
 * passare gli stalli brevi invece di trasformarli in riconnessioni, ognuna
 * con il suo "non disponibile" in Home Assistant.
 */
#define MQTT_KEEPALIVE_SEC   60

/*
 * Quanto aspettare l'eco prima di rinunciare all'ACK. In rete locale torna in
 * pochi millisecondi (il ping del server verso il ponte: mediana 3 ms, massimo
 * 88 ms su quattro ore); il nodo aspetta l'ACK per 2000 ms e la trasmissione
 * dell'ACK ne costa circa 100, quindi 800 ms lasciano margine su entrambi i lati.
 */
#define ECO_TIMEOUT_MS       800UL

// Ogni quanto RIPUBBLICARE la discovery di Home Assistant. I messaggi sono
// ritenuti, quindi li conserva il broker: ripubblicarli a ogni riconnessione
// significava solo riversare 5 KB nel socket ogni volta, cosa che su un WiFi
// debole faceva cadere la connessione appena stabilita. Serve al primo avvio
// e ogni tanto, nel caso il broker venga reinstallato e perda tutto.
#define DISCOVERY_RIPUBBLICA_MS  21600000UL   // 6 ore
#define WDT_LOOP_SEC         30         // Watchdog del loop principale

/*
 * Il ponte NON si riavvia piu' a intervalli fissi.
 * La versione precedente faceva ESP.restart() ogni ora: durante i ~8 secondi
 * di riavvio la radio non ascolta, e con il nodo che trasmette ogni 15 minuti
 * la probabilita' di perdere proprio quel pacchetto non era trascurabile.
 * Al suo posto: watchdog sul loop e riavvio SOLO se il WiFi resta giu' a lungo,
 * cioe' quando il riavvio serve davvero a qualcosa.
 */
#define REBOOT_WIFI_DOWN_MS  900000UL   // 15 minuti senza WiFi -> riavvio

/*
 * Un record e' "storico" se il nodo lo marca con bk=1 (dal firmware 2.5.0 lo
 * fa con tutto quello che esce dal backlog), oppure, per i record accodati da
 * firmware precedenti, se il suo timestamp e' piu' vecchio di questo valore.
 *
 * La sola regola dell'eta' non bastava: un record accodato un ciclo prima ha
 * 15 minuti, sembra fresco, e finiva su serra/nodo/stato DOPO il pacchetto
 * vero, sovrascrivendolo in Home Assistant con valori vecchi. Nel recorder
 * e' successo nove volte fra il 12 e il 14/09.
 */
#define SOGLIA_STORICO_SEC   2400UL     // 40 minuti

/*
 * Terza regola, che non dipende dal firmware del nodo: il nodo trasmette
 * SEMPRE prima il pacchetto fresco e solo dopo svuota il backlog, quindi un
 * record con un timestamp piu' vecchio dell'ultimo pacchetto fresco
 * confermato e' per forza arretrato. Copre i nodi fino alla 2.4.0, che non
 * mettono bk=1.
 *
 * STORICO_MARGINE_SEC: quanto piu' vecchio deve essere. Non zero perche'
 * l'orologio del nodo, quando il ponte lo corregge, puo' tornare indietro di
 * una trentina di secondi a meta' risveglio, e il pacchetto di esito di un
 * comando che segue non va scambiato per arretrato. Un record del backlog e'
 * vecchio almeno un intervallo di sonno, 900 s.
 *
 * STORICO_PLAUSIBILE_SEC: il riferimento si aggiorna solo con timestamp entro
 * questa distanza dall'ora NTP del ponte. Un orologio del nodo impazzito
 * (una lettura del DS1307 andata male, che dica 2099) non deve far sembrare
 * arretrato tutto quello che arriva dopo.
 */
#define STORICO_MARGINE_SEC     60UL
#define STORICO_PLAUSIBILE_SEC  300UL

// Per quanto tempo un comando allegato a un ACK resta ripetibile, se lo
// stesso pacchetto torna perche' il nodo quell'ACK non l'ha sentito.
#define ACK_RIPETIBILE_MS    30000UL

// Anti-duplicati: quante coppie (seq,timestamp) ricordare. Se un ACK si perde
// il nodo ritrasmette lo stesso pacchetto: senza questo controllo il dato
// finirebbe due volte nello storico e nel conteggio dell'acqua.
#define DEDUP_MEMORIA        16

// Quanti comandi tenere in coda in RAM.
#define CODA_CMD_MAX         8

/*
 * SCADENZA DEI COMANDI "DI AZIONE".
 *
 * I comandi arrivano come messaggi MQTT ritenuti, e il broker li conserva
 * finche' il ponte non li consegna. Per le impostazioni va benissimo: se
 * cambi la durata dell'irrigazione e il nodo dorme, il valore aspetta.
 *
 * Per i comandi che FANNO qualcosa e' invece pericoloso. Un "Irriga ora"
 * premuto e rimasto sul broker perche' il ponte era spento viene consegnato
 * alla prima occasione utile, e la serra si annaffia da sola a un orario
 * qualunque, magari il giorno dopo. E' successo davvero.
 *
 * Due protezioni:
 *  1. un comando di azione che arriva nella raffica di messaggi ritenuti
 *     subito dopo la sottoscrizione viene scartato: e' un residuo, non una
 *     richiesta appena fatta (vedi CODA_FINESTRA_RETAINED_MS)
 *  2. un comando di azione rimasto in coda piu' di questo tempo scade
 */
#define CMD_TTL_AZIONE_MIN     30      // minuti
#define CODA_FINESTRA_RETAINED_MS 3000UL

// ======================= NTP ================================================
// L'ora corretta viaggia su ogni ACK: e' cosi' che il DS1307 del nodo si
// risincronizza da solo quando la batteria tampone si scarica.

#define NTP_SERVER1  "pool.ntp.org"
#define NTP_SERVER2  "time.google.com"
#define NTP_TZ       "CET-1CEST,M3.5.0,M10.5.0/3"   // Italia, con ora legale

// ======================= PINOUT LoRa ========================================
// Sul ponte il LoRa ha il bus SPI tutto per se' (VSPI standard).

#define LORA_MISO 19
#define LORA_MOSI 23
#define LORA_SCK  18
#define LORA_RST  14
#define LORA_DIO0 26
#define LORA_NSS  5

// ======================= OTA ================================================
// Aggiornamento del firmware via WiFi: comodo perche' il ponte spesso e'
// dietro un mobile. La password sta in secrets.h.

#define ABILITA_OTA  1
#define OTA_HOSTNAME "serra-ponte"
