Tressilloide/Serra_smart/Kimi_Agent_Smart Greenhouse ESP32 LoRa/camera_ponte/discovery.cpp

#include "discovery.h"
#include "config.h"
#include "protocollo.h"

#include <string.h>
#include <esp_task_wdt.h>

static PubSubClient* mqtt = nullptr;

// Blocco "device": raggruppa tutte le entita' sotto un unico dispositivo
// "Serra" nell'interfaccia di Home Assistant.
static const char* DEV =
  "\"dev\":{\"ids\":[\"serra_nodo\"],\"name\":\"Serra\",\"mf\":\"DIY\","
  "\"mdl\":\"ESP32 LoRa\",\"sw\":\"" FW_VERSION_PONTE "\"}";

// ---------------------------------------------------------------------------
//  1. Tabella delle chiavi conosciute
// ---------------------------------------------------------------------------

struct EntitaSensore {
  const char* chiave;
  const char* nome;
  const char* unita;       // nullptr = adimensionale
  const char* devClass;    // nullptr = nessuna
  const char* statClass;   // "measurement" / "total_increasing" / nullptr
  const char* icona;       // nullptr = icona automatica
  bool        testuale;    // true = valore non numerico (niente sentinella -127)
  bool        diagnostica; // true = finisce nella sezione Diagnostica di HA
};

static const EntitaSensore ENTITA[] = {
  // chiave      nome                     unita  devClass          statClass       icona                    txt    diag
  { "temp",     "Temperatura",            "°C", "temperature", "measurement",  nullptr,                 false, false },
  { "hum",      "Umidita' aria",          "%",   "humidity",        "measurement",  nullptr,                 false, false },
  { "pres",     "Pressione",              "hPa", "pressure",        "measurement",  nullptr,                 false, false },
  { "luce",     "Luce",                   "%",   nullptr,           "measurement",  "mdi:brightness-6",      false, false },
  { "volt",     "Tensione batteria",      "V",   "voltage",         "measurement",  nullptr,                 false, false },

  { "soil1",    "Umidita' terreno 1",     "%",   "moisture",        "measurement",  "mdi:water-percent",     false, false },
  { "soil2",    "Umidita' terreno 2",     "%",   "moisture",        "measurement",  "mdi:water-percent",     false, false },
  { "soil3",    "Umidita' terreno 3",     "%",   "moisture",        "measurement",  "mdi:water-percent",     false, false },
  { "soil4",    "Umidita' terreno 4",     "%",   "moisture",        "measurement",  "mdi:water-percent",     false, false },

  // Niente device_class "water" su questo: in Home Assistant quella classe
  // ammette solo state_class "total" o "total_increasing", perche' descrive
  // un contatore. Qui invece il valore e' il volume della SINGOLA irrigazione,
  // che sale e scende. Con la combinazione sbagliata HA lo segnalava a ogni
  // avvio ("is using state class measurement which is impossible considering
  // device class water") e rifiutava di tenerne le statistiche.
  { "acqua",    "Acqua ultima irrigazione","L",  nullptr,           "measurement",  "mdi:water",             false, false },
  // total_increasing: Home Assistant lo tratta come un contatore e ci puo'
  // costruire sopra un utility_meter per i totali giornalieri e mensili.
  { "acquaTot", "Acqua totale",           "L",   "water",           "total_increasing", "mdi:counter",       false, false },

  { "irr",      "Esito irrigazione",      nullptr, nullptr,         nullptr,        "mdi:sprinkler-variant", true,  false },
  { "det",      "Esito ultimo comando",   nullptr, nullptr,         nullptr,        "mdi:message-text",      true,  true  },

  { "rssi",     "Segnale LoRa",           "dBm", "signal_strength", "measurement",  nullptr,                 false, true  },
  { "snr",      "SNR LoRa",               "dB",  nullptr,           "measurement",  "mdi:signal-variant",    false, true  },
  { "bl",       "Record in backlog",      nullptr, nullptr,         "measurement",  "mdi:database-clock",    false, true  },
  { "fw",       "Firmware nodo",          nullptr, nullptr,         nullptr,        "mdi:chip",              true,  true  },
  { "rst",      "Motivo ultimo riavvio",  nullptr, nullptr,         nullptr,        "mdi:restart-alert",     false, true  },
  // La tappa della scatola nera e' un TESTO ("tx_stato", "sd", ...). Senza
  // questa riga finiva nel fallback generico, che e' numerico: il template
  // trasformava ogni testo in stringa vuota e in Home Assistant la tappa non
  // sarebbe comparsa mai, proprio il giorno in cui servisse.
  { "tp",       "Tappa ultimo blocco",    nullptr, nullptr,         nullptr,        "mdi:map-marker-path",   true,  true  },
  // Tentativi che il pacchetto principale del ciclo PRECEDENTE ha richiesto:
  // 1 al primo colpo, fino a 3 con le ritrasmissioni, 4 se non e' passato.
  { "txp",      "Tentativi trasmissione", nullptr, nullptr,         "measurement",  "mdi:repeat",            false, true  },
  // Pacchetti che aspettano nella riserva in RAM RTC del nodo, dal firmware
  // 2.6.0 (serra_nodo/riserva.h): c'e' solo quando la riserva non e' vuota,
  // e ha un template suo (vedi pubblicaSensore()).
  { "rs",       "Pacchetti in riserva",   nullptr, nullptr,         "measurement",  "mdi:tray-full",         false, true  },
  { "trunc",    "Pacchetto troncato",     nullptr, nullptr,         nullptr,        "mdi:alert",             false, true  },
};

static const uint8_t N_ENTITA = sizeof(ENTITA) / sizeof(ENTITA[0]);

// ---------------------------------------------------------------------------
//  Chiavi di trasporto e di controllo: non devono generare entita'.
//  (sOra/sMin/sDur/sAuto/sSoil/slp alimentano le entita' di COMANDO, che sono
//   pubblicate a parte con il loro tipo corretto: number, switch, time.)
// ---------------------------------------------------------------------------

static const char* IGNORA[] = {
  "v", "s", "t", "now", "c", "o", "a", "h", "res", "rc",
  "sOra", "sMin", "sDur", "sAuto", "sSoil", "slp",
  "cmdL", "cmdS", "ping",
  "bk"      // marcatore dei record arretrati: dice al ponte dove pubblicarli
};
static const uint8_t N_IGNORA = sizeof(IGNORA) / sizeof(IGNORA[0]);

bool discoveryDaIgnorare(const char* chiave) {
  for (uint8_t i = 0; i < N_IGNORA; i++)
    if (strcmp(chiave, IGNORA[i]) == 0) return true;
  return false;
}

// ---------------------------------------------------------------------------
//  Cache delle chiavi gia' annunciate
// ---------------------------------------------------------------------------

#define MAX_CHIAVI_ANNUNCIATE 32
static char    annunciate[MAX_CHIAVI_ANNUNCIATE][PROTO_LEN_CHIAVE];
static uint8_t nAnnunciate = 0;

static bool giaAnnunciata(const char* chiave) {
  for (uint8_t i = 0; i < nAnnunciate; i++)
    if (strcmp(annunciate[i], chiave) == 0) return true;
  return false;
}

static void segnaAnnunciata(const char* chiave) {
  if (nAnnunciate >= MAX_CHIAVI_ANNUNCIATE) return;
  strncpy(annunciate[nAnnunciate], chiave, PROTO_LEN_CHIAVE - 1);
  annunciate[nAnnunciate][PROTO_LEN_CHIAVE - 1] = '\0';
  nAnnunciate++;
}

void discoveryReset() { nAnnunciate = 0; }

void discoveryInit(PubSubClient* client) {
  mqtt = client;
  discoveryReset();
}

// ---------------------------------------------------------------------------
//  Pubblicazione di un sensore
// ---------------------------------------------------------------------------

static void pubblicaSensore(const EntitaSensore& e) {
  if (!mqtt || !mqtt->connected()) return;

  char topic[96];
  snprintf(topic, sizeof(topic), HA_DISCOVERY_PREFIX "/sensor/serra_%s/config", e.chiave);

  /*
   * Template del valore. Il nodo invia -127 quando un sensore non e'
   * disponibile (e' JSON valido, a differenza di "nan"). Qui lo convertiamo
   * in stringa vuota: Home Assistant scarta gli aggiornamenti vuoti, quindi
   * l'entita' conserva l'ultimo valore buono invece di mostrare un -127 che
   * sporcherebbe grafici e statistiche.
   */
  char tpl[220];
  if (strcmp(e.chiave, "rs") == 0) {
    /*
     * "rs" il nodo lo manda solo quando la riserva non e' vuota: con il
     * template generico, svuotata la riserva l'entita' resterebbe per sempre
     * sull'ultimo numero. Nel pacchetto principale (l'unico con "txp") la
     * sua assenza vuol dire zero; negli esiti dei comandi e nei ping, che
     * non lo portano mai, vuol dire "non so" e si tiene il valore.
     */
    snprintf(tpl, sizeof(tpl),
             "{%% if value_json.txp is defined %%}{{ value_json.rs | default(0) }}{%% endif %%}");
  } else if (e.testuale) {
    snprintf(tpl, sizeof(tpl), "{{ value_json.%s | default('') }}", e.chiave);
  } else {
    snprintf(tpl, sizeof(tpl),
             "{%% set v = value_json.%s | float(-127) %%}{{ '' if v == -127 else v }}",
             e.chiave);
  }

  char payload[820];
  int n = snprintf(payload, sizeof(payload),
    "{\"name\":\"%s\","
    "\"uniq_id\":\"serra_%s\","
    "\"stat_t\":\"%s\","
    "\"val_tpl\":\"%s\","
    "%s%s%s"                       // unita'
    "%s%s%s"                       // device_class
    "%s%s%s"                       // state_class
    "%s%s%s"                       // icona
    "%s"                           // categoria diagnostica
    "\"exp_aft\":7200,"
    "\"avty_t\":\"%s\","
    "%s}",
    e.nome, e.chiave, TOPIC_STATO, tpl,
    e.unita     ? "\"unit_of_meas\":\"" : "", e.unita     ? e.unita     : "", e.unita     ? "\"," : "",
    e.devClass  ? "\"dev_cla\":\""      : "", e.devClass  ? e.devClass  : "", e.devClass  ? "\"," : "",
    e.statClass ? "\"stat_cla\":\""     : "", e.statClass ? e.statClass : "", e.statClass ? "\"," : "",
    e.icona     ? "\"ic\":\""           : "", e.icona     ? e.icona     : "", e.icona     ? "\"," : "",
    e.diagnostica ? "\"ent_cat\":\"diagnostic\"," : "",
    TOPIC_PONTE, DEV);

  if (n <= 0) return;
  if (n >= (int)sizeof(payload)) {
    Serial.printf("[HA] Payload discovery troppo lungo per %s: salto.\n", e.chiave);
    return;
  }

  if (mqtt->publish(topic, (const uint8_t*)payload, n, true)) {
    Serial.printf("[HA] Entita' pubblicata: %s (%s)\n", e.chiave, e.nome);
  } else {
    Serial.printf("[HA] ERRORE nella pubblicazione di %s (payload %d byte, "
                  "buffer MQTT insufficiente?)\n", e.chiave, n);
  }
}

void discoveryAssicuraSensore(const char* chiave) {
  if (!chiave || !*chiave) return;
  if (discoveryDaIgnorare(chiave)) return;
  if (giaAnnunciata(chiave)) return;

  for (uint8_t i = 0; i < N_ENTITA; i++) {
    if (strcmp(chiave, ENTITA[i].chiave) == 0) {
      pubblicaSensore(ENTITA[i]);
      segnaAnnunciata(chiave);
      return;
    }
  }

  // --- 2. Fallback generico: chiave sconosciuta, entita' creata lo stesso ---
  // E' quello che permette di aggiungere un sensore al nodo senza toccare
  // il firmware del ponte.
  Serial.printf("[HA] Chiave sconosciuta '%s': creo una entita' generica.\n", chiave);

  EntitaSensore generica = {
    chiave, chiave, nullptr, nullptr, "measurement", "mdi:help-circle-outline", false, false
  };
  pubblicaSensore(generica);
  segnaAnnunciata(chiave);
}

// ---------------------------------------------------------------------------
//  Entita' di comando
// ---------------------------------------------------------------------------

/*
 * Nota sui template: rendono STRINGA VUOTA quando la chiave manca, invece di
 * un valore di ripiego. Se un pacchetto arriva senza il blocco di stato
 * (per troncamento, o perche' e' un pacchetto di esito comando), Home Assistant
 * scarta l'aggiornamento vuoto e il controllo conserva il valore precedente.
 * Con un default numerico il cursore salterebbe a zero e poi tornerebbe
 * indietro a ogni pacchetto incompleto.
 *
 * "retain":true e' essenziale: Home Assistant pubblica il comando come
 * messaggio ritenuto, quindi il broker lo conserva finche' il ponte non lo
 * consegna al nodo. La coda sopravvive a un riavvio del ponte senza bisogno
 * di scriverla da nessuna parte.
 */
static bool pubblica(const char* topic, const char* payload) {
  if (!mqtt || !mqtt->connected()) return false;

  if (!mqtt->publish(topic, (const uint8_t*)payload, strlen(payload), true)) {
    Serial.printf("[HA] ERRORE pubblicando %s: interrompo la sequenza.\n", topic);
    return false;
  }

  /*
   * Respiro fra un messaggio e il successivo.
   *
   * Le entita' di comando sono tredici messaggi ritenuti da ~400 byte: spinti
   * tutti insieme fanno circa 5 KB riversati nel socket alla massima velocita'.
   * Con un WiFi debole quella raffica basta a far cadere la connessione appena
   * stabilita, il che provoca una riconnessione, che rilancia la raffica: un
   * ciclo che si autoalimenta, osservato davvero nel log del ponte.
   * mqtt->loop() da' modo allo stack di svuotare il buffer di trasmissione.
   *
   * Il watchdog va nutrito qui dentro: sono una ventina di messaggi di fila,
   * e su un collegamento in stallo ogni publish puo' restare bloccata fino a
   * una decina di secondi prima di arrendersi. Sommate, possono superare i
   * 30 s del watchdog del loop e riavviare il ponte a meta' discovery.
   */
  esp_task_wdt_reset();
  mqtt->loop();
  delay(30);
  return true;
}

bool discoveryPubblicaComandi() {
  if (!mqtt || !mqtt->connected()) return false;
  Serial.println(F("[HA] Pubblico le entita' di comando..."));

  char topic[96];
  char payload[820];

  // --- Bottone: irriga ora (durata = quella configurata sul nodo) ----------
  snprintf(topic, sizeof(topic), HA_DISCOVERY_PREFIX "/button/serra_irriga/config");
  snprintf(payload, sizeof(payload),
    "{\"name\":\"Irriga ora\",\"uniq_id\":\"serra_irriga\","
    "\"cmd_t\":\"%s/IRR\",\"payload_press\":\"0\",\"retain\":true,"
    "\"ic\":\"mdi:sprinkler\",\"avty_t\":\"%s\",%s}",
    TOPIC_CMD_BASE, TOPIC_PONTE, DEV);
  if (!pubblica(topic, payload)) return false;

  // --- Bottone: blocca l'irrigazione per oggi ------------------------------
  snprintf(topic, sizeof(topic), HA_DISCOVERY_PREFIX "/button/serra_stop/config");
  snprintf(payload, sizeof(payload),
    "{\"name\":\"Blocca irrigazione per oggi\",\"uniq_id\":\"serra_stop\","
    "\"cmd_t\":\"%s/STOP\",\"payload_press\":\"1\",\"retain\":true,"
    "\"ic\":\"mdi:water-off\",\"avty_t\":\"%s\",%s}",
    TOPIC_CMD_BASE, TOPIC_PONTE, DEV);
  if (!pubblica(topic, payload)) return false;

  // --- Numero: durata irrigazione ------------------------------------------
  // Il massimo coincide con il tetto compilato nel nodo (IRRIG_MAX_SEC):
  // richieste superiori verrebbero comunque clampate dal firmware.
  snprintf(topic, sizeof(topic), HA_DISCOVERY_PREFIX "/number/serra_durata/config");
  snprintf(payload, sizeof(payload),
    "{\"name\":\"Durata irrigazione\",\"uniq_id\":\"serra_durata\","
    "\"cmd_t\":\"%s/DUR\",\"retain\":true,"
    "\"stat_t\":\"%s\",\"val_tpl\":\"{{ value_json.sDur | default('') }}\","
    "\"min\":10,\"max\":900,\"step\":10,\"unit_of_meas\":\"s\",\"mode\":\"box\","
    "\"ic\":\"mdi:timer-sand\",\"avty_t\":\"%s\",%s}",
    TOPIC_CMD_BASE, TOPIC_STATO, TOPIC_PONTE, DEV);
  if (!pubblica(topic, payload)) return false;

  /*
   * Orario programmato: DUE number, ora e minuto, invece di una sola entita'
   * "time".
   *
   * Sarebbe stato piu' elegante un time, che accetta direttamente "17:30:00".
   * Verificato pero' su un'installazione reale (Home Assistant 2025.11) che
   * le discovery del dominio "time" vengono semplicemente ignorate: nello
   * stesso istante e con lo stesso prefisso, un "sensor" minimale veniva
   * creato e un "time" altrettanto minimale no. Meglio due controlli un po'
   * meno belli ma che esistono di sicuro, che uno elegante che non compare.
   */
  snprintf(topic, sizeof(topic), HA_DISCOVERY_PREFIX "/number/serra_orario_ora/config");
  snprintf(payload, sizeof(payload),
    "{\"name\":\"Orario irrigazione ora\",\"uniq_id\":\"serra_orario_ora\","
    "\"cmd_t\":\"%s/ORAH\",\"retain\":true,"
    "\"stat_t\":\"%s\",\"val_tpl\":\"{{ value_json.sOra | default('') }}\","
    "\"min\":0,\"max\":23,\"step\":1,\"mode\":\"box\","
    "\"ic\":\"mdi:clock-outline\",\"avty_t\":\"%s\",%s}",
    TOPIC_CMD_BASE, TOPIC_STATO, TOPIC_PONTE, DEV);
  if (!pubblica(topic, payload)) return false;

  snprintf(topic, sizeof(topic), HA_DISCOVERY_PREFIX "/number/serra_orario_minuto/config");
  snprintf(payload, sizeof(payload),
    "{\"name\":\"Orario irrigazione minuto\",\"uniq_id\":\"serra_orario_minuto\","
    "\"cmd_t\":\"%s/ORAM\",\"retain\":true,"
    "\"stat_t\":\"%s\",\"val_tpl\":\"{{ value_json.sMin | default('') }}\","
    "\"min\":0,\"max\":59,\"step\":5,\"mode\":\"box\","
    "\"ic\":\"mdi:clock-outline\",\"avty_t\":\"%s\",%s}",
    TOPIC_CMD_BASE, TOPIC_STATO, TOPIC_PONTE, DEV);
  if (!pubblica(topic, payload)) return false;

  // --- Interruttore: irrigazione automatica --------------------------------
  snprintf(topic, sizeof(topic), HA_DISCOVERY_PREFIX "/switch/serra_auto/config");
  snprintf(payload, sizeof(payload),
    "{\"name\":\"Irrigazione automatica\",\"uniq_id\":\"serra_auto\","
    "\"cmd_t\":\"%s/AUTO\",\"retain\":true,"
    "\"stat_t\":\"%s\",\"val_tpl\":\"{{ value_json.sAuto | default('') }}\","
    "\"pl_on\":\"1\",\"pl_off\":\"0\",\"stat_on\":\"1\",\"stat_off\":\"0\","
    "\"ic\":\"mdi:calendar-clock\",\"avty_t\":\"%s\",%s}",
    TOPIC_CMD_BASE, TOPIC_STATO, TOPIC_PONTE, DEV);
  if (!pubblica(topic, payload)) return false;

  // --- Numero: soglia umidita' terreno (-1 = irrigazione non condizionata) --
  snprintf(topic, sizeof(topic), HA_DISCOVERY_PREFIX "/number/serra_soglia/config");
  snprintf(payload, sizeof(payload),
    "{\"name\":\"Soglia umidita' terreno\",\"uniq_id\":\"serra_soglia\","
    "\"cmd_t\":\"%s/SOIL\",\"retain\":true,"
    "\"stat_t\":\"%s\",\"val_tpl\":\"{{ value_json.sSoil | default('') }}\","
    "\"min\":-1,\"max\":100,\"step\":1,\"unit_of_meas\":\"%%\",\"mode\":\"slider\","
    "\"ic\":\"mdi:water-alert\",\"avty_t\":\"%s\",%s}",
    TOPIC_CMD_BASE, TOPIC_STATO, TOPIC_PONTE, DEV);
  if (!pubblica(topic, payload)) return false;

  // --- Numero: intervallo di risveglio -------------------------------------
  snprintf(topic, sizeof(topic), HA_DISCOVERY_PREFIX "/number/serra_sleep/config");
  snprintf(payload, sizeof(payload),
    "{\"name\":\"Intervallo risveglio\",\"uniq_id\":\"serra_sleep\","
    "\"cmd_t\":\"%s/SLEEP\",\"retain\":true,"
    "\"stat_t\":\"%s\",\"val_tpl\":\"{{ value_json.slp | default('') }}\","
    "\"min\":60,\"max\":3600,\"step\":60,\"unit_of_meas\":\"s\",\"mode\":\"box\","
    "\"ic\":\"mdi:sleep\",\"ent_cat\":\"config\",\"avty_t\":\"%s\",%s}",
    TOPIC_CMD_BASE, TOPIC_STATO, TOPIC_PONTE, DEV);
  if (!pubblica(topic, payload)) return false;

  // --- Bottone: finestra di manutenzione -----------------------------------
  snprintf(topic, sizeof(topic), HA_DISCOVERY_PREFIX "/button/serra_wake/config");
  snprintf(payload, sizeof(payload),
    "{\"name\":\"Finestra manutenzione (2 min)\",\"uniq_id\":\"serra_wake\","
    "\"cmd_t\":\"%s/WAKE\",\"payload_press\":\"120\",\"retain\":true,"
    "\"ic\":\"mdi:tools\",\"ent_cat\":\"config\",\"avty_t\":\"%s\",%s}",
    TOPIC_CMD_BASE, TOPIC_PONTE, DEV);
  if (!pubblica(topic, payload)) return false;

  // --- Bottone: svuota backlog ---------------------------------------------
  snprintf(topic, sizeof(topic), HA_DISCOVERY_PREFIX "/button/serra_clrbl/config");
  snprintf(payload, sizeof(payload),
    "{\"name\":\"Svuota backlog\",\"uniq_id\":\"serra_clrbl\","
    "\"cmd_t\":\"%s/CLRBL\",\"payload_press\":\"1\",\"retain\":true,"
    "\"ic\":\"mdi:database-remove\",\"ent_cat\":\"config\",\"avty_t\":\"%s\",%s}",
    TOPIC_CMD_BASE, TOPIC_PONTE, DEV);
  if (!pubblica(topic, payload)) return false;

  // --- Bottone: riavvia il nodo --------------------------------------------
  snprintf(topic, sizeof(topic), HA_DISCOVERY_PREFIX "/button/serra_reset/config");
  snprintf(payload, sizeof(payload),
    "{\"name\":\"Riavvia nodo serra\",\"uniq_id\":\"serra_reset\","
    "\"cmd_t\":\"%s/RESET\",\"payload_press\":\"1\",\"retain\":true,"
    "\"dev_cla\":\"restart\",\"ent_cat\":\"config\",\"avty_t\":\"%s\",%s}",
    TOPIC_CMD_BASE, TOPIC_PONTE, DEV);
  if (!pubblica(topic, payload)) return false;

  // --- Sensore: comandi in attesa di consegna ------------------------------
  // Serve alla dashboard per dire "comando in coda, verra' eseguito al
  // prossimo risveglio" invece di sembrare che non sia successo nulla.
  snprintf(topic, sizeof(topic), HA_DISCOVERY_PREFIX "/sensor/serra_pending/config");
  snprintf(payload, sizeof(payload),
    "{\"name\":\"Comandi in coda\",\"uniq_id\":\"serra_pending\","
    "\"stat_t\":\"%s\",\"val_tpl\":\"{{ value_json.n | default(0) }}\","
    "\"json_attr_t\":\"%s\","
    "\"ic\":\"mdi:playlist-play\",\"avty_t\":\"%s\",%s}",
    TOPIC_CMD_PEND, TOPIC_CMD_PEND, TOPIC_PONTE, DEV);
  if (!pubblica(topic, payload)) return false;

  Serial.println(F("[HA] Entita' di comando pubblicate."));
  return true;
}

// ---------------------------------------------------------------------------
//  Entita' diagnostiche del ponte
// ---------------------------------------------------------------------------

struct DiagPonte {
  const char* id;
  const char* nome;
  const char* campo;      // chiave nel JSON di serra/ponte/diag
  const char* unita;
  const char* devClass;
  const char* icona;
};

static const DiagPonte DIAG[] = {
  { "ponte_uptime", "Ponte uptime",        "uptime",         "s",   "duration",        "mdi:timer-outline"   },
  { "ponte_wifi",   "Ponte segnale WiFi",  "wifi_rssi",      "dBm", "signal_strength", nullptr               },
  { "ponte_pkt",    "Pacchetti ricevuti",  "pkt",            nullptr, nullptr,         "mdi:package-down"    },
  // Il ponte conta un pacchetto appena lo riceve dalla radio, PRIMA di
  // controllare che sia leggibile. Con un collegamento al limite capita che
  // arrivi qualcosa di corrotto: senza questo contatore, "pacchetti ricevuti"
  // che sale senza che i sensori si aggiornino resta inspiegabile.
  { "ponte_ko",     "Pacchetti scartati",  "scartati",       nullptr, nullptr,         "mdi:package-variant-remove" },
  { "ponte_heap",   "Ponte memoria libera","heap",           "B",   "data_size",       "mdi:memory"          },
  { "ponte_cmd",    "Comandi consegnati",  "cmd_consegnati", nullptr, nullptr,         "mdi:send-check"      },
  // Questi due sono la spia dei "non disponibile" lampeggianti in Home
  // Assistant: ogni riconnessione MQTT fa pubblicare al broker il Last Will
  // della sessione morta, e per un secondo tutte le entita' della serra
  // spariscono. Se il contatore cresce di continuo, la connessione e' instabile.
  // Il blocco contiguo piu' grande e' la spia della frammentazione della heap:
  // se cala nei giorni mentre la memoria libera resta stabile, la memoria si
  // sta sbriciolando e prima o poi un'allocazione fallira'.
  { "ponte_hblk",   "Ponte blocco memoria","heap_blocco",    "B",   "data_size",       "mdi:memory"          },
  { "ponte_hmin",   "Ponte memoria minima","heap_minimo",    "B",   "data_size",       "mdi:memory"          },
  { "ponte_rwifi",  "Riconnessioni WiFi",  "riconn_wifi",    nullptr, nullptr,         "mdi:wifi-sync"       },
  { "ponte_rmqtt",  "Riconnessioni MQTT",  "riconn_mqtt",    nullptr, nullptr,         "mdi:lan-disconnect"  },
  // Pacchetti rimasti senza ACK perche' il broker non ha confermato con l'eco:
  // il nodo li ritrasmette o li tiene sulla microSD. Se cresce, il WiFi del
  // ponte va in stallo spesso.
  { "ponte_ecoko",  "Conferme MQTT mancate", "eco_ko",       nullptr, nullptr,         "mdi:message-alert"   },
  // Le tre spie della radio del ponte (vedi radio.h). Riparazioni: quante
  // volte si e' dovuta resettare da sola, il motivo e' su serra/ponte/log.
  // ACK persi: ritrasmissioni di pacchetti gia' confermati, cioe' risposte
  // che il nodo non ha sentito. Letture SPI incoerenti: disturbi sui fili fra
  // ESP32 e modulo; se cresce, il problema e' il cablaggio, non il codice.
  { "ponte_radiorip", "Riparazioni radio",   "radio_rip",      nullptr, nullptr,         "mdi:radio-tower"     },
  { "ponte_ackpersi", "ACK persi",           "ack_persi",      nullptr, nullptr,         "mdi:message-reply-text" },
  { "ponte_spiinc",   "Letture SPI incoerenti", "spi_inc",     nullptr, nullptr,         "mdi:sine-wave"       },
  // Pacchetti arrivati con il CRC sbagliato: con un segnale al limite sono
  // soprattutto pacchetti del nodo ricevuti a meta'. Il contatore c'era gia'
  // nella diagnostica, ma senza entita' non lo vedeva nessuno.
  { "ponte_crcko",    "Pacchetti CRC errato",   "crc_ko",      nullptr, nullptr,         "mdi:package-variant-closed-remove" },
  // Record arretrati (backlog su SD o riserva in RAM RTC) consegnati e
  // pubblicati su serra/nodo/storico: la prova che le code del nodo servono.
  { "ponte_storici",  "Record arretrati recuperati", "storici", nullptr, nullptr,     "mdi:history"         },
};

bool discoveryPubblicaPonte() {
  if (!mqtt || !mqtt->connected()) return false;

  char topic[96];
  char payload[700];

  for (uint8_t i = 0; i < sizeof(DIAG) / sizeof(DIAG[0]); i++) {
    const DiagPonte& d = DIAG[i];
    snprintf(topic, sizeof(topic), HA_DISCOVERY_PREFIX "/sensor/%s/config", d.id);
    snprintf(payload, sizeof(payload),
      "{\"name\":\"%s\",\"uniq_id\":\"%s\",\"stat_t\":\"%s\","
      "\"val_tpl\":\"{{ value_json.%s | default(0) }}\","
      "%s%s%s%s%s%s%s%s%s"
      "\"stat_cla\":\"measurement\",\"ent_cat\":\"diagnostic\","
      "\"avty_t\":\"%s\",%s}",
      d.nome, d.id, TOPIC_DIAG, d.campo,
      d.unita    ? "\"unit_of_meas\":\"" : "", d.unita    ? d.unita    : "", d.unita    ? "\"," : "",
      d.devClass ? "\"dev_cla\":\""      : "", d.devClass ? d.devClass : "", d.devClass ? "\"," : "",
      d.icona    ? "\"ic\":\""           : "", d.icona    ? d.icona    : "", d.icona    ? "\"," : "",
      TOPIC_PONTE, DEV);
    if (!pubblica(topic, payload)) return false;
  }

  // --- Ultima riparazione della radio --------------------------------------
  // Un testo, non un numero: il motivo ("registri", "silenzio", ...) e, negli
  // attributi, il dettaglio, per esempio il registro trovato alterato. Legge
  // il messaggio ritenuto di serra/ponte/log, quindi dice cosa e' successo
  // anche giorni dopo e anche dopo un riavvio di Home Assistant. Finche' una
  // riparazione non c'e' mai stata resta "sconosciuto", ed e' il caso buono.
  snprintf(topic, sizeof(topic), HA_DISCOVERY_PREFIX "/sensor/ponte_radiocausa/config");
  snprintf(payload, sizeof(payload),
    "{\"name\":\"Ultima riparazione radio\",\"uniq_id\":\"ponte_radiocausa\","
    "\"stat_t\":\"%s\",\"val_tpl\":\"{{ value_json.causa | default('') }}\","
    "\"json_attr_t\":\"%s\",\"ic\":\"mdi:radio-tower\",\"ent_cat\":\"diagnostic\","
    "\"avty_t\":\"%s\",%s}",
    TOPIC_LOG, TOPIC_LOG, TOPIC_PONTE, DEV);
  if (!pubblica(topic, payload)) return false;

  Serial.println(F("[HA] Entita' diagnostiche del ponte pubblicate."));
  return true;
}
