Tressilloide/Serra_smart/(commit log)

2026-09-01 Serra smart: monitoraggio e irrigazione automatica con ESP32 e LoRa
    Sistema composto da un nodo ESP32 in serra (BME280, DS1307, umidita' del
    terreno, flussometro, microSD, relay di irrigazione, deep sleep), un ponte
    ESP32 in casa che fa da gateway LoRa verso WiFi e MQTT, e un server con
    Mosquitto e Home Assistant.
    Caratteristiche principali
    - Nessun dato perso: il ponte conferma solo dopo la pubblicazione su MQTT,
    altrimenti il nodo accoda su microSD e ritrasmette al risveglio successivo
    - Comunicazione bidirezionale: i comandi da Home Assistant viaggiano dentro
    l'ACK che il nodo gia' attende, senza consumo aggiuntivo
    - Sensori modulari: protocollo chiave=valore e discovery generica, ag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
2026-09-01 hw: alimentazione sensori terreno predisposta ma disattivata
    Il pin che comanda l'alimentazione dei sensori terreno passa da GPIO 16 a
    GPIO 15 e viene per ora messo a -1, cioe' disattivato: i sensori restano
    costantemente alimentati e non serve cablare nessun interruttore.
    Perche' GPIO 15 quando verra' attivata: appartiene al dominio RTC, quindi
    il suo livello puo' essere mantenuto durante il deep sleep invece di
    restare flottante per 15 minuti, cosa che con un relay significherebbe
    rischiare che si ecciti da solo e tenga i sensori sotto tensione tutta la
    notte. In piu' ha un pull-up interno al reset, quindi con un relay attivo
    basso si presenta gia' spento prima che parta il firmware.
    Agg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
    [config.h, irrigazione.cpp, sensori.cpp, sensori.h, serra_nodo.ino]
2026-09-02 hw: flussometro alimentato a 3,3 V e calibrato a 433 impulsi/litro
    Collegamento verificato sul campo: sensore alimentato a 3,3 V e segnale
    diretto sul GPIO 17, senza partitore ne' condensatore, con il pull-up
    interno dell'ESP32.
    Alimentare il sensore a 3,3 V invece che a 5 V elimina alla radice il
    problema del livello logico: nel circuito non esiste nessun 5 V, quindi il
    GPIO non puo' ricevere sovratensioni qualunque sia il tipo di uscita del
    sensore. Sparisce la necessita' del partitore e con essa il rischio piu'
    subdolo di questo collegamento, quello che funziona per mesi e poi
    danneggia il pin.
    Il compromesso, documentato: il datasheet dichiara 5-18 V, quindi a 3,3 V
    il sensore lavora f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
    [config.h, sensori.cpp]
2026-09-02 irrigazione: finestra di grazia prima di giudicare il flusso
    L'acqua non arriva istantaneamente alla turbina: deve percorrere il tubo e
    la pompa deve adescarsi. Il rilevamento dell'irrigazione a vuoto ora e'
    diviso in due tempi espliciti:
    FLUSSO_GRAZIA_SEC (5 s) gli impulsi vengono contati ma il flusso non
    viene giudicato, cosi' il riempimento del tubo
    non genera un falso allarme
    FLUSSO_TIMEOUT_SEC (10 s) attesa successiva prima di dichiarare l'anomalia
    Il timeout scende da 30 a 10 s perche' ora la grazia copre esplicitamente
    il transitorio iniziale, e non serve piu' usare un valore alto per
    compensarlo alla cieca. Il ritardo total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
2026-09-02 diag: avanzamento irrigazione sul seriale e watchdog silenzioso
    Durante l'irrigazione viene stampata ogni 2 secondi una riga con secondi
    trascorsi, impulsi contati, litri e LIVELLO LOGICO del pin del flussometro.
    Il livello del pin e' il dato che discrimina fra le due cause possibili di
    "nessun flusso": se resta fisso a 1 mentre l'acqua scorre, gli impulsi non
    arrivano fisicamente all'ESP32 (massa non in comune con il sensore, filo
    staccato, sensore non alimentato); se invece cambia ma il conteggio resta
    a zero, il problema e' nell'interrupt lato firmware.
    Il watchdog ora prova prima esp_task_wdt_reconfigure() e solo dopo init(),
    e controlla esp_task_wdt_status() prima di iscrivere il task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
    [config.h, irrigazione.cpp, watchdog.h]
2026-09-02 diag: sonda delle transizioni e sketch di test del flussometro
    Il log mostra pin fisso a 1 per tutti i 30 secondi di irrigazione, mentre
    un secondo ESP32 collegato allo stesso filo conta correttamente. Un solo
    digitalRead ogni due secondi pero' non basta a dichiarare ferma la linea:
    potrebbe cadere sempre nella stessa meta' dell'onda.
    Aggiunta flussoSondaTransizioni(), che campiona il pin a raffica per 200 ms
    contando i cambi di livello senza passare dall'interrupt, e il suo risultato
    compare nella riga di avanzamento dell'irrigazione. Distingue in modo netto
    le due cause rimaste:
    transizioni = 0 -> sul filo non arriva segnale elettrico
    transizioni > 0, impulsi = 0 -> segna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
2026-09-02 hw: flussometro spostato da GPIO 17 a GPIO 15 (conflitto PSRAM su WROVER)
    Il flussometro non contava un solo impulso sulla scheda del nodo, mentre lo
    stesso sensore, sullo stesso filo e con lo stesso codice, funzionava su una
    seconda scheda. Anche lo sketch di test minimale, caricato sulla scheda del
    nodo, non contava: il firmware era quindi innocente.
    Causa: le due schede sono moduli diversi. Quella del nodo ha 38 pin, cioe'
    monta un ESP32-WROVER, dove i GPIO 16 e 17 sono cablati al chip di PSRAM e
    non funzionano come I/O. Il sintomo era il pin fermo a livello alto con
    nessun segnale in grado di muoverlo. La scheda funzionante ha 30 pin ed e'
    un WROOM, dove il 17 e' libero.
    PIN_FLUSSO pas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
2026-09-12 ponte: disattivato il modem-sleep WiFi, causa dei "non disponibile" a raffica
    In Home Assistant tutte le entita' della serra passavano a "non disponibile"
    e tornavano al valore un secondo dopo, a ripetizione e a orari irregolari.
    Non era il nodo: quelle righe nel registro non sono trasmissioni della
    serra. Sono l'entita' che sparisce e ricompare leggendo il messaggio
    ritenuto su serra/nodo/stato, quindi il topic di disponibilita' del ponte
    che oscilla fra offline e online.
    Causa: WiFi.setSleep(true) sul ponte. Il modem-sleep spegne la radio a
    intervalli per risparmiare corrente, ma il ponte sta attaccato a un
    alimentatore USB e quel risparmio non serve a niente, mentre fa cadere in
    silenzi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
2026-09-12 comandi: scadenza dei comandi di azione, e test flussometro con relay
    IRRIGAZIONE PARTITA DA SOLA ALLE 19:19
    I comandi viaggiano come messaggi MQTT ritenuti e il broker li conserva
    finche' il ponte non li consegna. Non c'era nessuna scadenza: un "irriga
    ora" premuto quando il ponte era spento restava sul broker e veniva
    consegnato alla prima occasione utile, anche il giorno dopo e a un orario
    qualunque. E' esattamente quello che e' successo.
    Due protezioni, entrambe solo sui comandi che FANNO qualcosa (IRR, IRRVOL,
    STOP, WAKE, RESET, CLRBL, TIME). Le impostazioni continuano a passare anche
    in ritardo, perche' un valore vecchio e' comunque quello giusto e anzi serve
    a riallineare il nodo dop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
    [camera_ponte.ino, comandi.cpp, comandi.h, config.h, test_flusso.ino]
2026-09-12 fix: revisione del codice — JSON troncato, backlog orfano, scansioni SD
    Revisione sistematica dopo le modifiche incrementali degli ultimi giorni.
    PONTE — JSON dello stato troncabile in modo non valido
    costruisciJson accumulava il valore di ritorno di snprintf, che indica
    quanti caratteri AVREBBE scritto e non quanti ne ha scritti: con un
    pacchetto abbastanza pieno "pos" poteva superare la dimensione del buffer,
    mandando in underflow la sottrazione successiva (sono size_t) e passando a
    snprintf una dimensione enorme. Nel caso benigno il JSON usciva troncato a
    meta' e Home Assistant lo scartava in blocco, fermando TUTTI i sensori
    senza un errore che spiegasse perche'.
    Ora la coda del JSO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
    [backlog.cpp, camera_ponte.ino, irrigazione.cpp]
2026-09-12 fix: entity_id sbagliati nel package HA e validazione della NVS
    HOME ASSISTANT — tre entita' irraggiungibili
    Home Assistant ricava l'entity_id dal campo "name", non da "unique_id".
    Tre entita' avevano un nome che genera uno slug diverso da quello con cui
    erano poi richiamate, quindi i riferimenti non avrebbero trovato nulla:
    "Serra minuti dall'ultimo contatto" -> serra_minuti_dallultimo_contatto
    ma richiamata come serra_minuti_silenzio dal sensore di stato
    generale e dall'automazione "nodo silenzioso"
    "Serra ora del nodo" -> serra_ora_del_nodo, richiamata come serra_ora_nodo
    da entrambe le dashboard
    utility_meter acqua_serra_giornaliera / _mensile -> entity_id dal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
    [impostazioni.cpp]
2026-09-12 fix: verifiche sull'installazione reale di Home Assistant
    Collegandomi all'installazione vera (HA 2025.11.3) e confrontando le entita'
    effettive con quelle attese, sono emersi tre problemi che l'analisi del solo
    codice non poteva rivelare.
    1. ENTITA' "time" MAI CREATE
    Il controllo "Orario irrigazione" non esisteva. Non e' un errore del
    payload: pubblicando nello stesso istante, con lo stesso prefisso e via
    mqtt.publish di Home Assistant, una discovery "sensor" minimale creava
    l'entita' e una "time" altrettanto minimale veniva ignorata. Su questa
    installazione il dominio time non viene proprio accettato.
    Sostituito con due entita' number, ora e minuto, che funzionano di sicuro.
    Aggiunti al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
    [camera_ponte.ino, comandi.cpp, discovery.cpp, serra_hacs.yaml]
2026-09-12 ponte: contatori di riconnessione corretti, e scala di lettura del segnale
    VERIFICA SUL CAMPO DEL FIRMWARE NUOVO
    Dopo l'aggiornamento del ponte, la qualita' della rete e' passata da 10%
    di pacchetti persi e 142 ms medi a 0% e 2 ms. Il modem-sleep era davvero
    la causa dei "non disponibile" a raffica in Home Assistant.
    Confermate presenti le entita' nuove: riconnessioni WiFi e MQTT, e le due
    number per ora e minuto che sostituiscono l'entita' time mai creata.
    CONTATORI CHE PARTIVANO DA UNO
    Sia il contatore MQTT sia quello WiFi conteggiavano anche la connessione
    iniziale, che non e' una riconnessione: un ponte appena avviato e in perfetta
    salute mostrava gia' "1" e "2". Sono diagnostici che s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
2026-09-12 diag: metriche per riconoscere la frammentazione della heap
    Domanda legittima: l'uso di String puo' far crashare l'ESP32 dopo settimane
    riempiendo la heap? La risposta va misurata, non stimata, perche' la sola
    memoria libera NON rivela il problema: allocazioni e rilasci di dimensioni
    diverse lasciano buchi, e il totale libero puo' restare identico mentre il
    piu' grande blocco CONTIGUO si rimpicciolisce, finche' un'allocazione
    fallisce e il dispositivo si riavvia.
    Aggiunti alla diagnostica del ponte, con le rispettive entita' in Home
    Assistant:
    heap_blocco ESP.getMaxAllocHeap() — il piu' grande blocco allocabile.
    Se cala nei giorni mentre la memoria libera resta piatta,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
    [camera_ponte.ino, discovery.cpp]
2026-09-13 ponte: la raffica di discovery faceva cadere la connessione che la lanciava
    Dal log del ponte, su un WiFi a -84 dBm:
    OK! (connessione n.2, uptime 193 s) -> 13 pubblicazioni di discovery
    OK! (connessione n.3, uptime 198 s) -> ricaduta dopo 5 secondi
    poi sei tentativi falliti con rc=-2 (TCP che non si aggancia)
    A ogni riconnessione MQTT il ponte ripubblicava l'intera discovery: tredici
    messaggi ritenuti da ~400 byte, circa 5 KB spinti nel socket alla massima
    velocita' senza pause e senza fermarsi se una pubblicazione falliva. Con un
    collegamento debole quella raffica basta a far cadere la connessione appena
    stabilita, il che provoca una riconnessione, che rilancia la raffica.
    Un cicl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
2026-09-13 ponte: scansione WiFi all'avvio e avviso sul segnale debole
    Cambiare la rete del ponte significa sceglierne una migliore, e il segnale va
    misurato DALLA POSIZIONE DEL PONTE, non da dove si trova chi lo configura col
    telefono in mano.
    All'avvio il ponte stampa ora l'elenco delle reti visibili con RSSI e canale,
    segnalando quale e' quella configurata. Smaschera subito i due errori piu'
    comuni quando si cambia rete: SSID scritto male e rete a 5 GHz, che l'ESP32
    non puo' vedere avendo solo la radio a 2,4 GHz.
    Aggiunto anche un avviso esplicito quando ci si collega sotto i -78 dBm:
    sotto quella soglia le cadute sono attese e non un guasto, e vale la pena
    dirlo subito invece di lasciarlo dedurre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
    [camera_ponte.ino, config.h]
2026-09-13 ponte: watchdog allineato al nodo, e caratteri ASCII sul seriale
    Leggendo il monitor seriale del ponte sono emerse due cose.
    L'errore rosso "task_wdt: TWDT already initialized" era ancora li'. La
    correzione era stata applicata al nodo, in watchdog.h, ma il ponte ha la sua
    copia locale di wdtImposta ed era rimasta indietro: chiamava init() prima di
    reconfigure(), che nel core ESP32 3.x fallisce sempre perche' il TWDT e' gia'
    avviato dal framework. Ora l'ordine e' invertito e il task viene iscritto
    solo se non lo e' gia'.
    Il titolo di avvio usciva come "PONTE LoRa <-> MQTT ??? firmware 2.0.0": il
    trattino lungo U+2014 non e' rappresentabile sui monitor seriali. Sostituito
    con un trattino ASC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
    [camera_ponte.ino, config.h, serra_nodo.ino, test_flusso.ino, test_protocollo.ino]
2026-09-13 diag: entita' per i pacchetti LoRa scartati
    Il ponte conta un pacchetto appena lo riceve dalla radio, PRIMA di verificare
    che sia leggibile. Con un collegamento al limite - adesso siamo a -100 dBm e
    SNR -5,5 dB, contro i -7,5 dB del muro di decodifica a SF7 - capita che arrivi
    qualcosa di corrotto o che sia il solo ACK di ritorno a perdersi, facendo
    ritrasmettere il nodo.
    In entrambi i casi il contatore dei pacchetti ricevuti sale mentre i sensori
    restano fermi, e senza un secondo numero accanto la cosa e' inspiegabile.
    Il conteggio degli scartati esisteva gia' nel JSON di diagnostica ma non
    aveva una sua entita' in Home Assistant.
2026-09-13 doc: il budget litri non e' una rete di sicurezza affidabile
    La valvola alimenta un impianto a goccia, la cui portata puo' stare sotto il
    minimo di specifica del YF-S201 (1 L/min): a quel regime la turbina conta in
    modo irregolare o non conta affatto, e tarare in modo esatto richiederebbe di
    raccogliere l'acqua da tutti i gocciolatori.
    Scelta consapevole: si tiene la taratura di banco (433 impulsi/L) e i litri
    restano indicativi, perche' cio' che serve davvero e' sapere SE passa acqua,
    non quanta. Il rilevamento 'nessun flusso' guarda solo la presenza di impulsi,
    quindi resta affidabile a prescindere dalla taratura.
    La conseguenza da non dimenticare e' che BUDGET_LITRI_GIORNO vale quanto v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
2026-09-13 nodo: i litri dell'ultima irrigazione sopravvivono al deep sleep
    "Acqua ultima irrigazione" in Home Assistant mostrava sempre 0, mentre
    "Acqua oggi" era corretta.
    g_litriUltima era una static in irrigazione.cpp. Ogni risveglio da deep
    sleep e' un avvio da zero, quindi al risveglio successivo valeva di nuovo
    0 e il pacchetto regolare pubblicava "acqua":0.000, sovrascrivendo in HA
    il valore buono arrivato col pacchetto di esito del comando.
    "Acqua oggi" si salvava perche' e' un utility_meter costruito su acquaTot,
    che sta in NVS ed e' quindi sopravvissuto al sonno.
    Il valore passa in NVS insieme agli altri contatori. Non costa una
    scrittura in piu': impostazioniSalva() gira gia' a fine irri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
2026-09-13 nodo: la finestra di irrigazione non saltava piu' il giro di mezzanotte
    La finestra oraria era un confronto diretto fra minuti del giorno:
    minutiOra >= minutiSched && minutiOra < minutiSched + finestraMin
    Corretto tranne che a cavallo della mezzanotte. Con la pianificazione
    alle 23:50 e 15 minuti di sonno la finestra andrebbe da 1430 a 1446, ma
    i minuti del giorno arrivano a 1439 e poi tornano a 0: il risveglio delle
    23:45 e' troppo presto, quello delle 00:00 ricomincia da capo, e la serra
    non veniva irrigata mai. In silenzio, con esito "fuori_orario".
    Ora la distanza dall'orario programmato si calcola in modulo 1440.
    Nessun effetto sulle pianificazioni diurne: per minutiSched + fine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
2026-09-14 irrigazione: l'orario e' ora locale, la finestra perdona, i reset si vedono
    Tre guasti che insieme spiegavano perche' l'irrigazione delle 6:00 non
    arrivava mai e perche' quella di stamattina non ha lasciato traccia.
    FUSO ORARIO. Il ponte mandava time(nullptr), cioe' UTC, e il nodo lo
    scriveva tale e quale nel DS1307 per poi confrontare rtc.now().hour() con
    l'orario impostato da Home Assistant. "Irriga alle 6:00" voleva dire le
    6:00 UTC, cioe' le 8:00 italiane d'estate. Ora il ponte allega "tz" a ogni
    ACK, il DS1307 resta in UTC (giusto per i timestamp) e la decisione si
    prende su orologioLocale(). Finche' il fuso non e' mai arrivato il nodo
    non irriga e pubblica "fuso_sconosciuto": meglio s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
    [camera_ponte.ino, config.h, impostazioni.cpp, impostazioni.h, irrigazione.cpp, irrigazione.h, orologio.cpp, orologio.h]
2026-09-15 nodo: la trasmissione LoRa non puo' piu' restare appesa per sempre
    LoRa.endPacket() nella libreria di Sandeep Mistry aspetta il flag di TxDone
    con un "while (...) yield();" senza timeout e senza nutrire il watchdog. Se
    l'SX1278 non alza mai quel flag il nodo resta bloccato dentro setup(), perde
    l'intero ciclo di misure e il watchdog globale lo riavvia dopo 180 secondi.
    E' la firma dei riavvii rst=6 registrati in Home Assistant: buchi di 900+181 s
    fra due pacchetti, compresi due avvenuti a valvola ferma, quindi senza che il
    disturbo del solenoide c'entrasse nulla.
    Ora la trasmissione parte in modo asincrono e la fine si rileva interrogando
    beginPacket(), che risponde 0 finche' la radio e' o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
2026-09-18 nodo: una scatola nera che dice DOVE si e' bloccato
    Il 2.3.0 mette un limite alla trasmissione LoRa, che e' l'indiziato numero uno
    dei riavvii da watchdog. Ma non e' l'unico: la microSD resta possibile, e le
    sue chiamate non si possono limitare dall'esterno. Finora, dopo un riavvio, si
    sapeva solo CHE il nodo si era bloccato, mai DOVE.
    Ora un byte in memoria RTC segna la tappa raggiunta dal ciclo, e il pacchetto
    che segue un riavvio anomalo la riferisce nel campo "tp", accanto a fw e rst.
    Il ponte non va riflashato: le chiavi sconosciute creano da sole un'entita'
    generica in Home Assistant.
    RTC_NOINIT_ATTR e non RTC_DATA_ATTR: le variabili RTC con inizializzatore
    vengono riazzerate dal boo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
2026-09-21 ponte: due byte tenuti in ostaggio da Nagle, 450 disconnessioni
    Il broker cacciava il ponte una ventina di volte al giorno con "exceeded
    timeout", ed e' l'origine delle entita' che lampeggiano su "non disponibile"
    in Home Assistant.
    Non era un ponte che moriva. Il WiFi non e' mai caduto (riconn_wifi resta a
    zero) e il loop non poteva restare bloccato abbastanza a lungo: il watchdog
    interviene a 30 s e il broker ne tollera 45, quindi un blocco avrebbe causato
    un riavvio, non una disconnessione. I pacchetti partivano e non arrivavano.
    E' l'algoritmo di Nagle. Il PINGREQ di MQTT e' lungo due byte, ed e' proprio il
    pacchetto che Nagle trattiene finche' i dati precedenti non sono confermati.
    Co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
    [camera_ponte.ino, config.h, protocollo.h]
2026-09-26 nodo 2.5.0, ponte 2.4.0: l'ACK arriva solo quando il broker ha preso il dato
    Il ponte confermava al nodo appena mqtt.publish() QoS 0 restituiva true, cioe'
    quando i byte erano entrati nel buffer TCP. Con il socket morto il dato era
    gia' perso e il nodo non lo accodava, perche' l'ACK era arrivato: dal 13/09,
    12 cicli persi su 15 cadono entro 30 s da un "exceeded timeout" del broker.
    Ponte 2.4.0
    - eco di conferma su serra/ponte/eco: l'ACK parte solo quando il token torna,
    entro 800 ms. Verificato sul broker vero, 30 su 30 sotto 1 ms.
    - keepalive a 60 s, ora che una conferma sbagliata non e' piu' possibile.
    - un record e' storico se il nodo lo marca con bk=1; la vecchia regola
    dell'eta' re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
    [camera_ponte.ino, comandi.cpp, config.h, discovery.cpp, protocollo.h, radio.cpp, radio.h, sensori.cpp]
2026-10-20 ponte 2.5.0: la radio sorda si ripara da sola, senza riflash
    Ogni tanto il ponte smetteva di ricevere il nodo, e tornava a funzionare solo
    riflashandolo via OTA. Le statistiche orarie di Home Assistant (la tabella
    statistics, che va oltre i 10 giorni del recorder) mostrano quattro episodi,
    orari UTC:
    - 09/10 07:30 -> 10/10 18:31 sordo, dopo 16 giorni di uptime
    - 11/10 14:45 -> 13/10 19:52 sordo, 20 ore dopo il riavvio
    - 13/10 20:08 -> 20/10 17:37 riceveva tutto, ma il nodo non ha sentito un
    solo ACK: tre pacchetti per ciclo, txp=4, backlog da 43 a 344 record
    - 20/10 06:26 -> 17:37 di nuovo sordo
    Il resto del ponte stava bene: uptime che cresce, WiFi e MQTT su, heap
    fermo. E la radio sord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
2026-11-09 doc: README alla radice, come funziona l'insieme
    Architettura nodo -> ponte -> server, ciclo di veglia e irrigazione,
    eco di conferma e comandi dentro l'ACK, entita' e package di Home
    Assistant, garanzie del sistema e stato al 9/11/2026.
2026-11-10 nodo 2.6.0, ponte 2.6.0: senza microSD i pacchetti aspettano in RAM RTC
    Dal 20/10 la microSD del nodo non risponde (bl=-1) e il segnale LoRa e'
    sceso a circa -110 dBm: fra il 31/10 e il 10/11 Home Assistant ha visto 834
    cicli sui 959 attesi, e ogni pacchetto non confermato era perso.
    Nodo 2.6.0:
    - riserva in RAM RTC lenta (serra_nodo/riserva.*, 6 KB, ~43 pacchetti,
    ~11 ore): accoglie cio' che la microSD rifiuta, sopravvive a deep sleep,
    watchdog e panic, viene svuotata prima del backlog al primo ACK buono.
    Le righe perdono i campi di configurazione s*/slp, inutili nello storico.
    Logica pura in riserva_coda.h, provata sul PC da tools/test_riserva.*
    - campo "rs" (pacchetti in riserva)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
2026-11-10 HA: package riallineato al server, copertura dati, avvisi e irrigazione adattiva
    Il package del repository non si poteva piu' copiare sul server: usava id
    rinominati che nel registro di Home Assistant non esistono, e non aveva i
    sensori di massima/minima aggiunti a mano il 27/10. Ora parte dal file
    installato e ci aggiunge il resto.
    - nomi della prima installazione ("Serra ora del nodo", "Serra minuti
    dall'ultimo contatto"), anche nelle dashboard
    - temperatura massima/minima di oggi (dal server), con l'attributo "ieri"
    - "Serra cicli ricevuti 24h": percentuale dei risvegli attesi arrivati, in
    tempo reale o recuperati da serra/nodo/storico, contando ogni posto del
    calendario una volta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
2026-11-10 irrigazione a secco non vista; tools/salute_serra.py
    Il 4/11/2026 l'irrigazione delle 12:00 ha erogato 0,002 L invece dei soliti
    2,2: un impulso solo del flussometro, esito "ok", nessun allarme. Il nodo
    dichiarava l'anomalia solo con zero impulsi esatti.
    - nodo: FLUSSO_MIN_IMPULSI (10) passata la finestra di verdetto; sotto, la
    soglia resta zero per le irrigazioni di pochi secondi
    - HA: "Serra - Irrigazione quasi a secco", sotto 0,1 L o meno di un quarto
    della volta prima, anche attraverso i "non disponibile" del ponte; vale
    subito, senza aspettare il flash del nodo
    - tools/salute_serra.py: rapporto giornaliero dal recorder di HA (cicli
    arrivati su attesi, buco piu' lungo, RSSI/SNR,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
2026-11-10 doc: firmware 2.6.0, package HA nuovo, stato al 10/11
    - README: riserva RTC nel ciclo di veglia, campo rs, entita' nuove del
    ponte, novita' del package (cicli 24h, avvisi, irrigazione adattiva,
    utility_meter), limiti (lo storico non riempie i grafici), stato al 10/11
    con i numeri di tools/salute_serra.py, ordine di flash e installazione
    del package
    - PROTOCOLLO: righe in riserva senza campi s*, chiave rs, diagnostica storici
    - Guida: file nuovi, deriva dell'orologio a 5 s, come leggere il conto dei
    cicli, nessun_flusso con FLUSSO_MIN_IMPULSI, SF piu' alto fra i passi
    possibili
    Claude-Session: https://claude.ai/code/session_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
2026-11-10 HA: la durata base si copia solo all'accensione dell'adattiva
    Il controllo "base ancora al minimo" girava anche alle 00:20, e una base di
    10 s scelta apposta sarebbe stata sovrascritta ogni notte con la durata
    corrente.
    Claude-Session: https://claude.ai/code/session_012nkyHGLsECx6FBj8kYs91D
2026-11-10 HA: durata dell'irrigazione da notte e previsione, meteo per la serra
    La durata si calcola ogni mattina dalla notte appena passata e dalla
    previsione di met.no, tarata sui dati veri da agosto e sulle durate scelte
    a mano (tools/calibra_irrigazione.py rifa' tutti i conti dal recorder).
    - Perche' la notte: il BME280 e' in una scatola di plastica che di giorno
    fa da forno (massime di 40-50 C anche a ottobre); di notte e' in
    equilibrio con l'aria. Dalla notte si prende la pressione di vapore,
    cioe' quanta acqua c'e' nell'aria.
    - "Domanda" del giorno = somma oraria del VPD 8-18, ricostruita da minima
    notturna, massima prevista in serra (campana di 3 h attorno alle 13) e
    pressione di va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
2026-11-10 HA: modello 3D interattivo della serra (custom:serra-3d-card)
    Card personalizzata con three.js r160 copiato in locale (vendor/, licenza
    MIT inclusa), cosi' funziona anche senza internet:
    - serra a capanna, aiuole con le piante, linea a goccia, elettrovalvola,
    scatola del nodo con LED e antenna, batteria, regolatore, pannello
    solare; intorno abeti, montagne e il lago della Serraia
    - sole e luce da sun.sun (azimut, elevazione), stelle di notte
    - pioggia, neve, nebbia e nuvole da weather.forecast_home
    - aria interna colorata dalla temperatura, vetri appannati con l'umidita'
    e brinati sotto 1 C, cime innevate quando fuori fa freddo
    - onde dell'antenna proporzionali al segnale LoRa, LED che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
2026-11-10 doc: irrigazione su misura, previsione e modello 3D; installazione dell'11/11
    Package, card 3D e Panoramica nuova installati sul server l'11/11/2026, con
    la quota di Home Assistant portata da 0 a 1000 m (met.no dava temperature
    6,0 C troppo alte). check_config pulito, log senza errori, entita' nuove
    attive: met.no ora 1,6 C invece di ~7,6; pressione del BME280 ridotta al
    mare 1012,8 hPa contro 1013,0 di met.no.
    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
2026-11-10 HA: pulsante "Durata automatica"; spento torna la durata normale
    Il pulsante (input_boolean.serra_irrigazione_adattiva, ora "Serra durata
    automatica") decide QUANTO irrigare; la programmazione (switch) resta SE.
    - acceso: subito la durata consigliata, poi ogni mattina alle 6:40; se la
    notte non e' ancora stata misurata lo dice invece di tacere
    - spento: torna sul nodo la DURATA NORMALE (input_number, ora "Serra durata
    normale irrigazione"), aspettando il ponte se e' giu'
    - una durata cambiata a mano diventa la durata normale: riconosciuta dal
    contesto della chiamata number.set_value (c'e' un utente), non dai cambi
    di stato del nodo, che passano da "non disponibile" a ogni riconnessio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
2026-11-10 card 3D 1.1: fluida sull'Echo Show; pulsante installato
    Card serra-3d-card 1.1.0, pensata per l'Echo Show 8 (Mali-G72, WebView):
    - mesh statiche unite per materiale con i colori nei vertici (BufferGeometry-
    Utils r160 in vendor/): da 207 mesh visibili a 22-27, da 181 draw call a
    17-21, ogni triangolo conservato; i tocchi vanno su scatole invisibili
    ricavate dagli oggetti prima dell'unione
    - ombre con shadowMap.autoUpdate = false: rifatte solo quando il sole si
    sposta
    - livelli di qualita' alta/media/bassa (ombre, risoluzione, antialiasing,
    Lambert invece di PBR, particelle); "auto" parte da media sui touch e
    scende da sola sotto i 22 fps di media, ricordando il livello nel
    disp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
2026-11-11 ponte 2.6.1: una radio che non ascolta e' un avvio fallito, non un registro escluso
    L'11/11/2026 il modulo LoRa del ponte ha smesso di uscire da sleep: tutta la
    configurazione a posto, il registro del modo fermo a 0x80. Il ponte 2.6.0 lo
    metteva fra i registri "esclusi dalla verifica", restava con radio_ok a 1 e
    riprovava solo con la sorveglianza del silenzio (35, 70, 140, 280 minuti).
    - radio.cpp: l'avvio controlla di essere entrato in ricezione, con fino a tre
    passate sleep -> standby -> ricezione; versione e modo sono registri vitali;
    piu' di RADIO_ESCLUSI_MAX registri che non tornano non sono un difetto
    della tabella. In tutti e tre i casi radio_ok va a 0, radio_avv dice il
    moti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
2026-11-11 doc: sensore e avviso della radio del ponte installati su HA l'11/11
    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
2026-11-12 HA: i dati recuperati dal nodo finiscono nei grafici (serra_storico)
    Componente che ascolta serra/nodo/storico e registra i record nel recorder
    all'ora in cui sono stati misurati, con le statistiche orarie. Installato
    sul server il 12/11 e usato per i 43 record della notte 11-12/11.
    Ponte 2.6.1 flashato via OTA il 12/11.
    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
